seiftotal30-source/BLOC-BOT/thesis/title_main.tex

% Thesis title, read by the title page (titlepage/titlepage.tex) and by main.tex.
\newcommand{\thesistitle}{Universal Modular Platform}
\newcommand{\thesissubtitle}{BLOC-BOT: ESP32-Based Design with a Wireless Handheld Controller}
