seiftotal30-source/BLOC-BOT/thesis/figures.tex

% Figure library for the thesis. \input{figures} where needed, or copy single blocks.
% Images live in ../CAD/out/ (see \graphicspath in main.tex), so re-rendering them in
% Fusion updates the thesis without copying files.
% Every figure is also registered in tracking/log.md with how it was produced.
% Naming: label fig:<topic>-<view>.

% F01 -- made with Fusion viewport.saveAsImageFile, iso top-right view, plate hidden
\begin{figure}[htbp]
  \centering
  
  \caption{Right and left motor brackets with the right-hand TT motor and wheel
           (isometric view).}
  \label{fig:bracket-iso}
\end{figure}

% F02 -- top view, plate hidden
\begin{figure}[htbp]
  \centering
  
  \caption{Top view of both brackets showing the three mounting slots.}
  \label{fig:bracket-top}
\end{figure}

% F03 -- Fusion "front" view (looks along +Y), plate hidden
\begin{figure}[htbp]
  \centering
  
  \caption{Front view: flange on the gearbox top, motor tab and sensor column.}
  \label{fig:bracket-front}
\end{figure}

% F04 -- left view, plate, wheel and left bracket hidden
\begin{figure}[htbp]
  \centering
  
  \caption{Side view: the encoder disc's bottom rim sits in the LM393 fork; the board is
           screwed to the column.}
  \label{fig:sensor-side}
\end{figure}

% F05 -- iso bottom-right view, plate shown
\begin{figure}[htbp]
  \centering
  
  \caption{Brackets mounted under the waffle plate, seen from below.}
  \label{fig:plate-below}
\end{figure}

% F06 -- iso top-right view, plate shown
\begin{figure}[htbp]
  \centering
  
  \caption{Brackets and wheel relative to the waffle plate, seen from above.}
  \label{fig:plate-top}
\end{figure}

% F07-F10 -- bracket alone (all references hidden), four isometric views
\begin{figure}[htbp]
  \centering
  \hfill
  \\[1ex]
  \hfill
  
  \caption{Right bracket on its own: top and underside, from the front and the rear.}
  \label{fig:bracket-angles}
\end{figure}

% F11-F12 -- bracket with motor, disc and LM393 (no wheel, no plate), from below
\begin{figure}[htbp]
  \centering
  \hfill
  
  \caption{Assembly from below: motor tab and nut traps, encoder disc and LM393 sensor.}
  \label{fig:assembly-below}
\end{figure}

% F13 -- controller, closed, iso top-right
\begin{figure}[htbp]
  \centering
  
  \caption{Handheld controller, closed: joystick left, display window top centre, two buttons
           below the stick, directional cross of four buttons on the right.}
  \label{fig:controller-iso}
\end{figure}

% F14 -- controller, top view
\begin{figure}[htbp]
  \centering
  
  \caption{Controller from above (178 x 87~mm): window over the OLED active area, two
           buttons below the stick, directional cross right, joystick opening sized from the cap's sweep sphere.}
  \label{fig:controller-top}
\end{figure}

% F15 -- exploded view (custom graphics copies, design not moved)
\begin{figure}[htbp]
  \centering
  
  \caption{Exploded view: bottom shell, internal parts, top shell and printed caps.}
  \label{fig:controller-exploded}
\end{figure}

% F16 -- section through the directional cross and the display
\begin{figure}[htbp]
  \centering
  
  \caption{Section through the directional cross and the display: caps trapped by their flanges above the
           switch plungers, switches on pillars, OLED glass under the 1~mm bezel lip.}
  \label{fig:controller-section}
\end{figure}

% F18-F19 -- rear caster supports under the waffle plate (cst_shots.py)
\begin{figure}[htbp]
  \centering
  \hfill
  
  \caption{Rear caster under the plate, from below and behind. Left: version A, a 4~mm plate
           (the motor bracket flange's thickness) with four printed pillars the caster screws to.
           Right: version B, the same plate with a 9.75~mm boss, caster screwed straight on.}
  \label{fig:caster-iso}
\end{figure}

% F20-F21 -- side views, plate underside to floor
\begin{figure}[htbp]
  \centering
  \hfill
  
  \caption{Side views. Plate underside to floor is 47.75~mm (bracket + TT motor + \O 65 wheel):
           A and B both 4 + 9.75 + 34 (caster) = 47.75~mm.}
  \label{fig:caster-side}
\end{figure}

% F22-F23 -- the printed supports alone, underside up
\begin{figure}[htbp]
  \centering
  \hfill
  
  \caption{The two supports, underside up: nut traps for the four M3 plate screws, countersunk
           M3 holes for the caster through the pillars (A) or the boss (B).}
  \label{fig:caster-parts}
\end{figure}
