seiftotal30-source/BLOC-BOT/thesis/chapters/front_abbreviations.tex

% List of abbreviations: every acronym used in Chapters 1-3 (collected by grep over the
% chapters). Add new ones here when a chapter introduces them.
\chapter*{List of Abbreviations}
\addcontentsline{toc}{chapter}{List of Abbreviations}

\renewcommand{\arraystretch}{1.1}
\begin{longtable}{L{3.2cm}L{\dimexpr\textwidth-4.4cm\relax}}
\toprule
\textbf{Abbreviation} & \textbf{Meaning} \\
\midrule
\endhead
ADC    & Analog-to-Digital Converter \\
ARC    & Algerian Robot Cup \\
BMS    & Battery Management System \\
CAD    & Computer-Aided Design \\
DA     & Algerian dinar (\emph{dinar algérien}) \\
DC     & Direct Current \\
EPFL   & École Polytechnique Fédérale de Lausanne \\
FDM    & Fused Deposition Modelling \\
FR     & Functional Requirement \\
GPIO   & General-Purpose Input/Output \\
HTSSOP & Heat-sink Thin Shrink Small Outline Package \\
I\textsuperscript{2}C & Inter-Integrated Circuit \\
IMU    & Inertial Measurement Unit \\
IP     & Internet Protocol \\
LE     & (Bluetooth) Low Energy \\
LED    & Light-Emitting Diode \\
LSB    & Least Significant Bit \\
MAC    & Medium Access Control \\
MEMS   & Micro-Electro-Mechanical System \\
MOSFET & Metal-Oxide-Semiconductor Field-Effect Transistor \\
NC     & Not Connected \\
OLED   & Organic Light-Emitting Diode \\
PETG   & Polyethylene Terephthalate Glycol \\
PSRAM  & Pseudo-Static Random-Access Memory \\
PWM    & Pulse-Width Modulation \\
RAM    & Random-Access Memory \\
RMS    & Root Mean Square \\
ROM    & Read-Only Memory \\
SAR    & Successive-Approximation Register \\
SCL    & Serial Clock (I\textsuperscript{2}C) \\
SDA    & Serial Data (I\textsuperscript{2}C) \\
SoC    & System on a Chip \\
SPI    & Serial Peripheral Interface \\
SRAM   & Static Random-Access Memory \\
TSSOP  & Thin Shrink Small Outline Package \\
TTL    & Transistor-Transistor Logic \\
USB    & Universal Serial Bus \\
\bottomrule
\end{longtable}
