seiftotal30-source/BLOC-BOT/thesis/chapters/front_dedication.tex

% Two dedications, one per student, each on its own page. These are personal texts:
% each author writes their own. The red markers must be replaced before printing.
\chapter*{Dedication}
\addcontentsline{toc}{chapter}{Dedication}

\vspace*{2cm}
\begin{center}
\begin{minipage}{0.78\textwidth}
\itshape\centering
\todo{dedication of CHETIOUI Wassim, in their own words}

\vspace{1.2cm}
\normalfont\normalsize
\hfill CHETIOUI Wassim
\end{minipage}
\end{center}

\clearpage

\vspace*{2cm}
\begin{center}
\begin{minipage}{0.78\textwidth}
\itshape\centering
\todo{dedication of CHARAD Seif Ali, in their own words}

\vspace{1.2cm}
\normalfont\normalsize
\hfill CHARAD Seif Ali
\end{minipage}
\end{center}
