seiftotal30-source/BLOC-BOT/thesis/chapters/cover.tex

% Cover page (English). Standard Algerian Master's layout: state and ministry headers,
% university, faculty, department, degree, speciality, title, authors, supervisor, jury.
% The jury is known only shortly before the defence; fill in the table then.
\begin{titlepage}
  \centering
  \small
  {\bfseries People's Democratic Republic of Algeria\\
  Ministry of Higher Education and Scientific Research\par}
  \vspace{4mm}
  {\large\bfseries Ferhat Abbas University S\'{e}tif~1\par}
  \vspace{1mm}
  Faculty of Science and Technology\\
  Department of Electronics\par
  \vspace{14mm}

  {\large\bfseries MASTER'S THESIS\par}
  \vspace{2mm}
  Field: Science and Technology\\
  Speciality: Embedded Systems\par
  \vspace{12mm}

  \rule{\textwidth}{0.8pt}\par
  \vspace{4mm}
  {\LARGE\bfseries BLOC-BOT\par}
  \vspace{3mm}
  {\Large Design and realisation of a modular mobile robot platform\\
  controlled wirelessly by an ESP32-based handheld controller\par}
  \vspace{4mm}
  \rule{\textwidth}{0.8pt}\par
  \vspace{12mm}

  \begin{minipage}[t]{0.47\textwidth}
    \raggedright
    \textbf{Presented by:}\\[1mm]
    Wassim CHETIOUI\\
    Seif Ali CHARAD
  \end{minipage}\hfill
  \begin{minipage}[t]{0.47\textwidth}
    \raggedleft
    \textbf{Supervised by:}\\[1mm]
    Dr.\ Miloud HAMANI
  \end{minipage}\par
  \vspace{14mm}

  \textbf{Defended on \todo{date} before the jury composed of:}\par
  \vspace{3mm}
  \begin{tabular}{@{}l l l l@{}}
    \todo{name} & \todo{grade} & Ferhat Abbas University S\'{e}tif~1 & President \\
    \todo{name} & \todo{grade} & Ferhat Abbas University S\'{e}tif~1 & Examiner \\
    Miloud HAMANI & \todo{grade} & Ferhat Abbas University S\'{e}tif~1 & Supervisor \\
  \end{tabular}\par
  \vfill
  Academic year \todo{2025/2026?}\par
\end{titlepage}
