seiftotal30-source/BLOC-BOT/thesis/tracking/log.md

# Thesis tracking log

One running record of every figure, graph, reference and search made for the thesis.
Add a row whenever one is created or used. IDs never change once given, even if an item is
dropped (mark it `dropped`).

## Figures

Images are in `CAD/out/`. LaTeX blocks are in `thesis/figures.tex`.

| ID | File | LaTeX label | How it was made | Date | Status |
|---|---|---|---|---|---|
| F01 | shot_iso.png | fig:bracket-iso | Fusion, iso top-right, plate hidden, 1600x1100 | 2026-10-05 | ready |
| F02 | shot_top.png | fig:bracket-top | Fusion, top view, plate hidden | 2026-10-05 | ready |
| F03 | shot_front.png | fig:bracket-front | Fusion "front" view (looks along +Y), plate hidden | 2026-10-05 | ready |
| F04 | shot_side.png | fig:sensor-side | Fusion left view; plate, wheel, left bracket hidden | 2026-10-05 | ready |
| F05 | shot_with_plate_below.png | fig:plate-below | Fusion iso bottom-right, plate shown | 2026-10-05 | ready |
| F06 | shot_with_plate_top.png | fig:plate-top | Fusion iso top-right, plate shown | 2026-10-05 | ready |
| F07 | angle_bracket_iso_front.png | fig:bracket-angles (a) | Fusion iso top-right, bracket only | 2026-10-05 | ready |
| F08 | angle_bracket_iso_rear.png | fig:bracket-angles (b) | Fusion iso top-left, bracket only | 2026-10-05 | ready |
| F09 | angle_bracket_under_front.png | fig:bracket-angles (c) | Fusion iso bottom-right, bracket only | 2026-10-05 | ready |
| F10 | angle_bracket_under_rear.png | fig:bracket-angles (d) | Fusion iso bottom-left, bracket only | 2026-10-05 | ready |
| F11 | angle_assembly_under_front.png | fig:assembly-below (a) | Fusion iso bottom-right; bracket, motor, disc, LM393 | 2026-10-05 | ready |
| F12 | angle_assembly_under_rear.png | fig:assembly-below (b) | Fusion iso bottom-left; bracket, motor, disc, LM393 | 2026-10-05 | ready |
| F13 | controller_iso.png | fig:controller-iso | Fusion iso top-right, closed case with references, 1800x1100 (CAD/scripts/ctl_shots.py) | 2026-10-05 | ready |
| F14 | controller_top.png | fig:controller-top | Fusion top view, closed case (ctl_shots.py) | 2026-10-05 | ready |
| F15 | controller_exploded.png | fig:controller-exploded | Custom-graphics copies lifted 0/35/75/100 mm (bottom/parts/top/caps), camera (30,-38,26) (ctl_shots.py) | 2026-10-05 | ready |
| F16 | controller_section.png | fig:controller-section | Custom-graphics copies cut by the vertical plane through the directional cross (57.5,-9.5) and display (0,19.7) centres (ctl_shots.py); F13-F16 re-shot 2026-10-14 (cross of 4 + 2 buttons, rim chamfer) | 2026-10-05 | ready |
| F17 | electronics/robot_circuit.svg | (not added yet) | Hand-written SVG block diagram of the proposed ESP32-S3 robot circuit; convert to PDF before including. 2026-10-10: two DRV8871 boxes replaced by one DRV8833, GPIO 13/14 added | 2026-10-06 | draft |
| F18 | caster/caster_A_iso.png | fig:caster-iso (left) | Fusion "Caster Mount", ortho, eye (-120,-200,-120) target (0,-65,-20); support A, pillars, caster, plate (CAD/scripts/cst_shots.py) | 2026-10-14 | ready |
| F19 | caster/caster_B_iso.png | fig:caster-iso (right) | As F18, support B and caster (cst_shots.py) | 2026-10-14 | ready |
| F20 | caster/caster_A_side.png | fig:caster-side (left) | Fusion ortho from -X, eye (-300,-62,-24); support A, pillars, caster (cst_shots.py) | 2026-10-14 | ready |
| F21 | caster/caster_B_side.png | fig:caster-side (right) | As F20, support B and caster (cst_shots.py) | 2026-10-14 | ready |
| F22 | caster/caster_A_part.png | fig:caster-parts (left) | Fusion ortho from below, eye (-90,-150,-100); support A alone (cst_shots.py) | 2026-10-14 | ready |
| F23 | caster/caster_B_part.png | fig:caster-parts (right) | As F22, support B alone (cst_shots.py) | 2026-10-14 | ready |
| F25 | (circuitikz, inline in chapters/ch2_design.tex) | fig:hbridge | Generic H-bridge principle, switches Q1–Q4; logic mapping from DRV8833 datasheet Table 1 | 2026-10-21 | ready |
| F26 | (TikZ, inline in chapters/ch3_realisation.tex) | fig:robot-loop | Robot main-loop flowchart, from src/main.cpp loop() and setup() (2026-10-24) | 2026-10-25 | ready |
| F27 | (TikZ, inline in chapters/ch3_realisation.tex) | fig:screens | Controller screen map, from Bloc-Con/src/main.cpp menu[] and handleButtons() | 2026-10-25 | ready |
| F28 | ../circuits/kicad/robot/robot.pdf | fig:sch-robot | KiCad 10 schematic generated by circuits/kicad/gen_schematics.pl, exported with kicad-cli (-e -n), cropped with pdfcrop. ERC: no connection errors | 2026-10-25 | ready (MPU6050 supply to confirm) |
| F29 | ../circuits/kicad/controller/controller.pdf | fig:sch-con | Same method as F28 | 2026-10-25 | ready |
| F24 | (TikZ, inline in chapters/ch2_design.tex) | fig:architecture | System block diagram drawn in TikZ. Parts and power chains from circuits/drv8833_motor_circuit.png and bloccon_controller_circuit.png (user-corrected: 0.96" OLED fitted); 50 ms / 100 ms from Bloc-Con/src/main.cpp and src/main.cpp | 2026-10-21 | ready |

## Graphs

Plots made from data (with the data file and the script that made them).

| ID | File | LaTeX label | Data source | Script | Date | Status |
|---|---|---|---|---|---|---|
| G01 | results/print_cost/print_cost.csv (table, not a plot) | (not added yet) | Latest Cura G-code in CAD/out (MotorBracket, HBlocL, VBloc, HBloc _Ender3Pro_pro; CasterSupportB_Ender5Plus) + old waffle plate from the user. Cura headers are wrong (0 m, 6666 s), so filament is summed from the E moves; checked against Cura's VBloc header (5.34 m) and Creality's caster file (7.48 m) | results/print_cost/make_table.py (uses gcode_filament.py) | 2026-10-20 | ready |

## References

Entries are in `thesis/references.bib`.

| Key | What it is | Used for | Verified? |
|---|---|---|---|
| ttmotor_model | TT Motor Dual Shaft CAD model (Oj Simpson) | All motor dimensions | URL missing |
| lm393_sensor_model | Speed sensor MH-Sensor-Series CAD model (P. Pennel) | Board, fork and disc dimensions | URL missing |
| fusion360 | Autodesk Fusion | CAD modelling, checks, renders | yes |
| fusion_api | Fusion API Reference Manual | Scripted modelling and checks | URL missing |
| git | Git 2.55.0 | Version control of the project | yes |
| grabcad_rc_model | GrabCAD Remote Controller (Slyman Rambo) | Controller shell shape (chamfered outline) | URL missing |
| esp32_devkit_model | ESP32 DevKit V1 STEP model | ESP32 board, holes, micro-USB | author, URL missing |
| oled_242_model | 2.42" 12864 OLED STEP model | Display window, lip, bosses | author, URL missing |
| ky023_model | KY-023 joystick STEP model | Opening, travel, posts | author, URL missing |
| b3f_switch_model | OMRON B3F-4050 STEP model | Switch heights, pegs, caps | author, URL missing |
| tp4056_model | TP4056 Type-C STEP model | Charger pocket, USB-C opening | author, URL missing |
| mt3608_model | MT3608 STEP model | Boost board pocket | author, URL missing |
| drv8833_datasheet | TI DRV8833 datasheet (SLVSAR1E) | Motor driver limits, wiring, control tables | yes |
| caster_wheel_model | GrabCAD Nylon Caster Wheel (AJ, 2018) | Caster plate, hole pattern, height, wheel size | yes (page text; files not downloaded) |
| drv8871_datasheet | TI DRV8871 datasheet SLVSCY9B (rev. July 2016), copy in references/datasheets/ | Ch. 2.4.2: VM 6.5–45 V, UVLO falling 6.1 typ / 6.4 max, rising 6.3 / 6.5 V (likely reason the motors did not run on 2S; unconfirmed) | yes |
| adafruit_tt_motor | Adafruit product 3777 "TT Motor" listing (online) | Ch. 2.4.3: 1:48, 3–6 V, no-load/stall current, rpm, torque. Reference for the type only: our motors are unmarked, Algerian shops (MHTronic, Esp32Lab searched 2026-10-21) list no specs | yes |
| tp4056_datasheet | NanJing Top Power TP4056 datasheet (SparkFun-hosted, no rev.), copy in references/datasheets/ | Ch. 2.5.3: CC/CV 4.2 V ±1.5 %, ≤1 A via R_PROG, 2.9 V trickle | yes |
| mt3608_datasheet | Aerosemi MT3608 datasheet (Olimex-hosted, no rev.), copy in references/datasheets/ | Ch. 2.5.3: 2–24 V in, ≤28 V out, 1.2 MHz, V_FB 0.6 V, V_OUT formula | yes |
| ssd1306_datasheet | Solomon Systech SSD1306 Rev 1.1 (Apr 2008), Adafruit-hosted copy in references/datasheets/ | Ch. 2.5.2: 128×64, I2C 0x3C/0x3D via SA0, VDD 1.65–3.3 V | yes |
| esp32lab_tp4056 | Esp32Lab "Chargeur LiPo USB-C TP4056" product page (shop listing) | Ch. 2.5.3: listing of a module identical in layout to ours (ours not bought there, no marking): 1000 mA, 4.2 V ±1 %, 2.5 V over-discharge, 3 A overcurrent, B±/OUT± | yes (shop listing) |
| espnow_idf | ESP-IDF v6.1 ESP-NOW API page (online) | Ch. 2.6: definition, 250 B (v1) / 1470 B (v2), 20 peers, broadcast not encryptable, MAC-level send status, CCMP | yes |
| espidf_adc | ESP-IDF v6.1 ADC oneshot driver page (online) | Ch. 2.5.2: "ADC2 is also used by Wi-Fi" | yes |
| mpu6000_ps | InvenSense MPU-6000/6050 Product Specification rev. 3.1 (2011), SparkFun-hosted copy in references/datasheets/ | Ch. 2.4.6: 6-axis, 2.375–3.46 V, I2C 400 kHz, 0x68, 131 LSB/(°/s), 16384 LSB/g | yes |
| mpu6000_rm | InvenSense MPU-6000/6050 Register Map rev. 4.0 (2012), copy in references/datasheets/ | Ch. 2.4.6: registers 0x1B, 0x1C, 0x3B, 0x43, 0x6B used by main.cpp | yes |
| mini360_c101 | Components101 Mini360 module page (2022-09-15) | Ch. 2.4.6: MP2307DN, 4.75–23 V in, 1–17 V out, 1.8 A cont. / 3 A, 340 kHz. MPS datasheet not downloadable here | yes (secondary source) |
| hcsr04_datasheet | ElecFreaks HC-SR04 datasheet (SparkFun-hosted PDF, no revision), copy in references/datasheets/ | Ch. 2.4.5: 5 V, 15 mA, 2 cm–4 m, 15°, 10 µs trigger, 8×40 kHz, d = t·340/2, cycle > 60 ms | yes |
| lm393_datasheet | TI LM393 family datasheet SLCS005AH (rev. April 2025), copy in references/datasheets/ | Ch. 2.4.4: comparator, open-collector output needing a pull-up, 2–30 V supply | yes |
| esp32_datasheet | Espressif ESP32 Series Datasheet v5.3, copy in references/datasheets/ (WROOM-32 v3.8 also downloaded, not cited: controller module is unmarked) | Ch. 2.5.1 (planned): controller MCU specs, GPIO34/35 input-only ADC1, GPIO12/MTDI strapping | yes |
| esp32s3_datasheet | Espressif ESP32-S3 Series Datasheet v2.2 (2026-03-05), copy in references/datasheets/ | Ch. 2.4.1: CPU, SRAM/ROM, radio, ADC (ADC2 vs Wi-Fi), LED PWM, strapping pins | yes |
| esp32s3_wroom1_datasheet | Espressif ESP32-S3-WROOM-1/1U Datasheet v1.8 (2026-03-02), copy in references/datasheets/ | Ch. 2.4.1: N16R8 memory, 36 GPIOs, 3.0–3.6 V, IO35–37 taken by PSRAM | yes |
| esp32s3_devkitc1_guide | Espressif ESP32-S3-DevKitC-1 v1.1 user guide (online, commit 4ffc5bd) | Ch. 2.4.1: 5 V pin, 5 V→3.3 V LDO, GPIO35–37 note. N16R8 not in its ordering table, so the actual board may be a compatible one | yes |

## Searches and lookups

Every search or data lookup that fed a design decision, with what it found.

| # | Date | Where | Query / action | Result | Used for |
|---|---|---|---|---|---|
| S01 | 2026-10-05 | Fusion cloud (Bloc-Bot) | Document search "waffle" | Found "waffle plate" (210 x 210 x 10 mm) | Plate geometry source |
| S02 | 2026-10-05 | Waffle plate model | All vertical hole faces | 108 x Ø3.2, 192 x Ø4.5, 44 x Ø6.0 through-holes, with centres | Slot placement |
| S03 | 2026-10-05 | Waffle plate model | Outline and hex tabs | Side edge X = 90; front-right corner cut-out r 27.06 (others r 29.21); pillar hex tabs circumradius 10 at (±95, ±13.66), (±13.66, ±95) | Placement rules |
| S04 | 2026-10-05 | TT motor model | Faces, holes, bosses | Gearbox 22.5 x 18.8; holes 20.6 behind shaft at ±8.75; front end +11.2; strap to −28.15; flat face = inner side | Tab, holes, motor orientation |
| S05 | 2026-10-05 | LM393 sensor model | Board, fork, hole | PCB 31.25 x 14.25 x 1.6; fork gap 5.0; slot floor 3.65 above PCB underside; hole Ø2.7 at 21.06 from fork centre | Sensor layout, column |
| S06 | 2026-10-05 | Encoder disc model | Faces | Ø24, 1.4 thick, 16 windows r 6.61–11.5, hub Ø7.2 x 4 | Disc position, flange relief |
| S07 | 2026-10-05 | Fusion API docs | Member search `readonly\|editable` | PersonalUseLimits can be read but not changed by scripts | Document-limit troubleshooting |
| S08 | 2026-10-05 | Fusion licensing | Licence query | Personal Use: 10 editable documents | Document-limit troubleshooting |
| S09 | 2026-10-05 | OLED model | Bodies and faces | PCB 72 x 42.8 x 1.2; holes Ø3.0 on 68 x 38.8; glass 62 x 39.8 x 3.7; active area (grey face) 56.6 x 29.5, 2.65 off PCB centre; header pins 8.54 behind the PCB | Window, lip, bosses |
| S10 | 2026-10-05 | KY-023 model | Faces; cap rotated about the gimbal pivot | Pivot at the pin axes; cap skirt torus = sphere r 13.65 about the pivot; cap meets the module case at 30 deg -> 29 deg travel; holes Ø3.0 at (-12.5/14, -11.25/9.25) | Opening Ø28.5, posts |
| S11 | 2026-10-05 | B3F-4050 model | Bodies and horizontal faces | Seating plane z 0; plunger top 7.35; pegs Ø1.6 x 1.35 at y ±4.5; model includes a 13 x 13 keycap (ignored) | Pillars, cap heights |
| S12 | 2026-10-05 | ESP32 model | Bodies, PCB holes | PCB 28.3 x 51.2 x 1.6; holes Ø2.9 at 23.5 x 46.6; pins 8.2 below; micro-USB 7.98 x 2.94 protruding 0.57 | Standoffs, side USB opening |
| S13 | 2026-10-05 | TP4056 / MT3608 models | Bodies, PCB holes | TP4056 28.3 x 17.4 x 1.5, USB-C 8.42 x 2.79, no mounting holes; MT3608 37.2 x 17.23 x 1.52, 6.45 tall, no mounting holes | Clip pockets, USB-C opening |
| S14 | 2026-10-05 | GrabCAD RC Transmitter | Import and outline | 200 x 170 x 36 box with chamfered corners, two halves, no grips | Shell shape |
| S15 | 2026-10-10 | ti.com, DRV8833 product page and datasheet SLVSAR1E (Rev. E, Jul 2015) | Supply range, current, protection, logic levels, pin functions, control tables | VM 2.7–10.8 V (11.8 V abs. max); 1.5 A RMS / 2 A peak per bridge (HTSSOP/WQFN), 0.5 A RMS (TSSOP); OCP 2–3.3 A, retry 1.35 ms; UVLO below 2.5 V; VIH 2 V (nSLEEP 2.5 V); nSLEEP high to enable, 500 kΩ pull-down; xISEN to GND without current control | Switch from DRV8871 to DRV8833: wiring, pin map, risks |
| S16 | 2026-10-14 | grabcad.com/library/nylon-caster-wheel-1 (built-in browser; plain fetch got 403) | Caster sizes | Fixing plate 38 x 32, holes Ø4 on 30 x 23, overall height 34, wheel Ø25.5; files need a login | Both caster supports |
| S17 | 2026-10-14 | CAD/3mf/from_professional/Bracket.3mf | Vertex heights of the three parts | Flange 4 mm thick (12 mm only at the tab socket); flange X 33..90, Y 47.45..101.06 | Support plate thickness (flange_t) |
| S18 | 2026-10-14 | Waffle plate (copied into "Caster Mount") | Holes near the rear centre line; underside solid fraction | Plate turned 90 deg as on the real robot; Ø4.5 holes at (±27, -71) and (±7, -34) used; underside flat with holes; 77 % of the support top on solid plate, bracket flange area 38 % | Fixing screw positions, contact check |
| S19 | 2026-10-20 | Latest G-code files in CAD/out (motor brackets taken from origin/main a36c08b) + user | Filament length, print time, cost | 5 G-code parts 107.2 g at 1.27 g/cm3 (assumed typical PETG density), 5 h 08 (Cura TIME_ELAPSED); old waffle plate ~200 g, 1 d 21 h (user, no G-code). Total 307 g, 1229-1290 DA at 4000 DA/kg + 0-5 % waste (user) | Print cost table (T5) |

### Chapter 1 sources (added 2026-10-26)

| Key | What it is | Used for | Verified? |
|---|---|---|---|
| siegwart2004 | Siegwart & Nourbakhsh, Introduction to Autonomous Mobile Robots, MIT Press 2004 (PDF copy + extracted text in references/datasheets/) | Ch. 1.2: wheels most popular, legged vs wheeled, differential drive spins on the spot, equal velocity profiles needed to go straight | yes (quotes checked in the text) |
| mondada2009epuck | e-puck paper (9th Conf. Autonomous Robot Systems and Competitions 2009) + EPFL DISAL page | Ch. 1.3: education robot, open hardware, extension turrets | page + abstract (full text not read) |
| riedo2013thymio | Thymio II paper (IEEE ARSO 2013) + EPFL Thymio page | Ch. 1.3: open-source, all ages, two motors, programming levels | page + abstract (full text not read) |
| yim2007modular | Yim et al., Modular self-reconfigurable robot systems, IEEE RAM 2007 | Ch. 1.4: definition of self-reconfigurable modular robots | abstract (full text not read) |
| mhtronic_kit | MHTronic 2-wheel chassis kit page | Ch. 1.3: local kit contents and price (2950 DA) | yes (page) |
| arduino_uno, atmega328p_datasheet | Arduino UNO R3 docs + Atmel ATmega328P datasheet 7810D | Ch. 1.5: 8-bit, 16 MHz, 32 KB flash, 2 KB SRAM, 10-bit ADC, no radio | yes |
| nrf24l01p_datasheet | Nordic nRF24L01+ product spec rev 1.0 | Ch. 1.6: 2.4 GHz, 250 k / 1 M / 2 Mbps | yes |
