seiftotal30-source/BLOC-BOT/thesis/main.pdf

ةيبعشلاةيطارقميدلاةيرئازجلاةيروهمجلا

## People’s Democratic Republic of Algeria

يملعلاثحبلاويلاعلاميلعتلاةرازو

## Ministry of Higher Education and Scientific Research

## Setif 1 University – Ferhat Abbas Faculty of Technology Department of Electronics Field of Electronics

سابعتاحرف1- فيطسةعماج ايجولونكتلاةيلك كينورتكلإلامسق

كينورتكلإلاةبعش

## | :عجرملا | :Ref

# Master’s Thesis

# Presented to the

## Department: Electronics Domain: Science and Technology Field: Electronics Speciality: Embedded Systems Electronics

# Carried out by:

## Mr. CHETIOUI Wassim

## and

## Mr. CHARAD Seif Ali

# Topic

# BLOC-BOT: a Modular Mobile Robot Platform

# ESP32-Based Design with a Wireless Handheld Controller

## Defended on: |

## Before the examination committee composed of:

Members: | | Univ. Setif 1 President
Dr. HAMANI Miloud | MCB Univ. Setif 1 Supervisor
| | Univ. Setif 1 Examiner

## Academic Year: 2025–2026

# Contents

1 Generalities | 2
2 Study and design | 6

i

3 Realisation and tests | 23

# Chapter 1

# Generalities

## 1.1 Introduction

This chapter gives the background on which the rest of the thesis builds. It first describes mobile robots and the way they move, then looks at robots designed for teaching and at the idea of a modular robot, and places BLOC-BOT among them. The last two sections introduce the electronic building blocks of the project: microcontrollers, and the wireless links that let two of them communicate.

## 1.2 Mobile robots

### 1.2.1 Definition

A mobile robot is a machine that can move through its environment under its own control, as opposed to an industrial arm fixed to the floor of a factory. It carries its own actuators to move, sensors to perceive its surroundings and its own motion, a processing unit that decides what to do, and usually its own energy source. It may be controlled by a human, as BLOC-BOT is when it is driven from its controller, or it may act on its own from what its sensors tell it, as a line-following robot does.

### 1.2.2 Locomotion

A mobile robot can move on legs, on wheels, on tracks, or in more unusual ways. Legged locomotion copes well with soft and uneven ground but needs many degrees of freedom and is mechanically complex. Wheels, by contrast, are simple and very well suited to flat ground, where wheeled locomotion is one to two orders of magnitude more efficient than legged locomotion [1]. For these reasons, Siegwart and Nourbakhsh describe the wheel as “by far the most popular locomotion mechanism in mobile robotics” [1]. The student competitions we took part in are run on flat indoor tracks, where wheels are the natural choice.

### 1.2.3 Differential drive

Among the many possible wheel arrangements [1], the simplest steerable one is the differential drive: two wheels on a common axis, each driven by its own motor, and one or two passive points of contact, such as a caster wheel, that keep the robot level. There is no

Chapter 1. Generalities

steering mechanism. The robot goes straight when both wheels turn at the same speed, turns when one wheel turns faster than the other, and spins on the spot when the wheels turn at the same speed in opposite directions. This ability to turn without moving its centre makes it very manoeuvrable, and Siegwart and Nourbakhsh name the two-wheel differential drive the most popular of these highly manoeuvrable designs [1].
The same property has a cost. Since nothing mechanical keeps the robot on a straight line, both motors “must be driven along exactly the same velocity profile” for it to go straight, which is difficult because of the small differences between wheels and motors [1]. This is why a differential-drive robot benefits from measuring the speed of each wheel, as BLOC-BOT does with its encoders (Section 2.4.4). BLOC-BOT uses this configuration: two driven wheels and a caster at the front.

## 1.3 Educational and competition robots

Robots are widely used to teach electronics, programming and control, because they turn abstract notions into a machine whose behaviour can be seen. Several families of robots serve this purpose.

Robots designed for teaching. Some robots are designed from the start as teaching tools. The e-puck, developed at the EPFL in Switzerland, is a small differential-drive robot made for engineering education at university level, inexpensive enough to be used widely in class, released under an open-hardware licence, and extensible with additional boards stacked on top of it, for example for radio communication [2]. Thymio, also from the EPFL, targets a wider public, from primary school to university: it is open-source in both hardware and software, is driven by two independent motors, and can be used through pre-programmed behaviours, then graphical and text programming [3]. Both are complete, finished robots: they are excellent to learn with, but their mechanics are fixed, and adding a sensor that was not planned by their designers is not their purpose.

Hobby kits. At the other end are the robot-car kits sold in electronics shops. The most common one in Algerian shops, a two-wheel chassis kit, costs 2950 DA and contains a chassis, two 6 V gearmotors with a 1:48 reduction, two wheels, an omnidirectional caster, two encoder discs, a holder for four AA batteries and screws; the microcontroller, the motor driver and every sensor have to be bought separately [4]. Such kits are cheap and are the usual starting point for student teams, but they provide little more than a frame and motors. Every new sensor needs its own way of being fixed and wired, and the result is a different robot every time.

Competition robots. In our experience of competitions such as the Algerian Robot Cup (Section 2.2), teams build their robots from such kits or from scratch, for one event and one task. As explained in Chapter 2, this is precisely the situation BLOC-BOT was created to improve.

## 1.4 Modular robots

The word modular is used in robotics with two rather different meanings, and it is worth separating them to place BLOC-BOT correctly.

Chapter 1. Generalities

In research, modular self-reconfigurable robots are machines made of many identical or similar modules that can rearrange how they are connected, and so change their own shape, to adapt to a new situation, perform a new task or recover from damage [5]. The robot changes its shape by itself. This is an active research field with its own open problems [5].
In a simpler sense, a robot is modular when it is built from parts that follow a common interface, so that they can be added, removed or exchanged by hand without redesigning the rest. The extension boards of the e-puck are an example of this on the electronic side [2].
BLOC-BOT belongs to this second kind. It does not reconfigure itself: its modularity is mechanical and manual. A plate with a fixed pattern of holes, the waffle plate, provides a common interface, and printed holders, the blocs, clamp a sensor or a module to it at any position of the pattern. Changing the robot for a new competition then means moving or adding blocs and their wiring, rather than designing and printing a new chassis. In this sense, BLOC-BOT sits between the hobby kit, which it resembles in cost and in parts, and the educational robot, from which it takes the idea of a documented, open platform that others can build on.

## 1.5 Embedded systems and microcontrollers

An embedded system is a computer built into a device to perform a specific function, often with tight limits on size, cost and power, and directly connected to the physical world through sensors and actuators. A robot’s brain is usually such a system, built around a microcontroller: a single chip that contains a processor, program and data memory, and the peripherals needed to talk to the outside world, such as general-purpose input/output (GPIO) pins, timers that generate PWM signals, analog-to-digital converters (ADCs) and serial interfaces.

Arduino. Much of student robotics starts with the Arduino UNO, a board built around the ATmega328P microcontroller [6]. Its 8-bit processor runs at 16 MHz, with 32 KB of flash memory for the program, 2 KB of SRAM and a 10-bit ADC [7]. The board has no radio [6]: a wireless link needs an extra module.

The ESP32 family. The ESP32 chips from Espressif are microcontrollers with an integrated 2.4 GHz radio. The original ESP32 combines a dual-core 32-bit processor at up to 240 MHz, 520 KB of SRAM, Wi-Fi and Bluetooth 4.2 [8]; the newer ESP32-S3 offers a similar processor with 512 KB of SRAM, Wi-Fi and Bluetooth 5 Low Energy, and more GPIOs [9]. Table 1.1 compares them with the Arduino UNO’s microcontroller. Their main interest for a robot is that the processor and the radio are on the same chip, so the robot and its controller can communicate without any added module, and that they are programmed with the same Arduino tools as an Arduino board.

## 1.6 Wireless links for robots

A robot driven by hand needs a link between its controller and its own microcontroller. Most of the options available to a student project work in the 2.4 GHz band.

Chapter 1. Generalities

Table 1.1: Microcontrollers compared [6], [7], [8], [9].

ATmega328P
(Arduino UNO)
| | ESP32 | ESP32-S3
Processor | 8-bit AVR, 16 MHz | dual-core 32-bit
| | Xtensa LX6, up to
| | 240 MHz | dual-core 32-bit
| | | Xtensa LX7, up to
| | | 240 MHz
SRAM | 2 KB | 520 KB | 512 KB
Radio | none | Wi-Fi 802.11b/g/n,
| | Bluetooth 4.2
| | (Classic and LE) | Wi-Fi 802.11b/g/n,
| | | Bluetooth 5 (LE
| | | only)
ADC | 10-bit | two 12-bit | two 12-bit
Used in BLOC-BOT no | controller | robot
- Wi-Fi (IEEE 802.11b/g/n) is built into ESP32 chips [8]. It is designed to connect devices to a network: one device acts as an access point and the others join it before exchanging data, usually over IP.
- Bluetooth exists in two forms. Bluetooth Classic is available on the original ESP32 only; Bluetooth Low Energy, available on both chips [8], [9], organises data as services and characteristics exchanged over a connection between a central and a peripheral device.
- Separate radio modules, such as the nRF24L01+, are transceivers that a microcontroller without a radio drives over SPI. The nRF24L01+ works in the 2.4 GHz band at 250 kbit/s, 1 or 2 Mbit/s [10]; it is cheap and simple but adds a module and its wiring at each end.
- ESP-NOW is Espressif’s connectionless protocol, which uses the Wi-Fi radio of ESP32 chips to send short frames directly from one device to another, without an access point or a connection set-up, with up to 250 bytes per frame [11].

The choice between them for BLOC-BOT is made in Section 2.6: since both ends are ESP32 chips, ESP-NOW gives a direct link with no extra hardware and no connection to establish.

## 1.7 Conclusion

A small differential-drive robot is one of the simplest and most widely used forms of wheeled mobile robot [1]; its weakness, keeping a straight line, is what wheel encoders help with. Between finished educational robots, whose mechanics are fixed, and hobby kits, which offer little beyond a frame and motors, there is room for a platform that is as cheap as a kit but provides a standard way of mounting and wiring modules. The ESP32 family, with its integrated radio and ESP-NOW, provides the electronic base for such a platform. Chapter 2 specifies and designs it.

# Chapter 2

# Study and design

## 2.1 Introduction

Plan: Half a page. What this chapter does: turn the problem from the general introduction into a specification, show the system architecture, then present every electronic component with its working principle and the reason it was chosen. The modular platform comes last.

## 2.2 Specification

### 2.2.1 Origin of the need

BLOC-BOT grew out of our own experience of student robotics competitions. Our team took part in two consecutive editions of the Algerian Robot Cup (ARC 3 and ARC 4), and in several other competitions, without success. Each ARC edition has two stages. To qualify, a team’s robot must follow a line through a maze, and the fastest robots go through. The main event then calls for a second robot, built for a task that changes from one year to the next. Looking back, we traced most of our difficulties to two causes. The first was time. For every competition we built the robot’s modules from scratch: a new chassis, new sensor mounts, new wiring, and in the case of ARC, two robots instead of one. Each took long enough that we reached the competition underprepared, with too little time left for testing and tuning.
The second was the specification itself. Organisers often announce the rules late or in vague terms. Unsure of what would be asked, we tended to over-prepare and build a robot more complicated than the task required. A more complicated robot has more ways to fail, and some of ours failed during the competition itself.
Both problems point to the same answer: a single robot that is ready in advance and can be reconfigured quickly for each competition, rather than a new robot every time. Most competitions in this category rely on a small, recurring set of sensors (line sensors, distance sensors, wheel encoders). If each of these has a standard way of being mounted and wired, adapting the robot becomes a matter of choosing modules instead of designing them. This is the idea behind BLOC-BOT and its interchangeable mechanical holders, which we call blocs.

Chapter 2. Study and design

### 2.2.2 Target users

The platform is aimed first at students and teams preparing for robotics competitions, who need a working base quickly and want to spend their time on strategy and tuning rather than on rebuilding mechanics. Because the hardware and firmware are open and the platform is designed to be extended, it is also meant for students and researchers who need a small mobile robot as a test bench for their own sensors or algorithms.

### 2.2.3 Functional requirements

Table 2.1 lists what the system must do. The last column gives the state of each requirement at the time of writing, so that the specification can be read against the results in Chapter 3.

Table 2.1: Functional requirements of BLOC-BOT and their state at the time of writing.

ID | Requirement | State

FR1 The robot is driven by hand from a handheld controller over a wireless
| link, with no computer or phone in the loop. | Done

FR2 The controller shows feedback from the robot, starting with the speed
| of its wheels. | Done

FR3 The robot stops on its own when it no longer receives commands from
| the controller. | Done

FR4 Sensors and modules are fixed to the robot through a standard hole
| pattern and printed holders, without redesigning the chassis. | Done
FR5 The controller runs from its own rechargeable battery. | Done
FR6 The robot follows a line using a multi-channel infrared sensor. | In progress
FR7 The robot detects obstacles and parks itself using distance sensors. | Planned

### 2.2.4 Non-functional requirements and constraints

Besides what the system does, four conditions shaped how it was built.

- Local availability of components. Most of the components were chosen because they could be bought in Algeria or were already in our hands, not after a comparison of every alternative on the market. We state this plainly here, and each component section in this chapter says when availability was the deciding reason.
- Low cost. The platform is meant for students, so it is built from common hobbyist modules and 3D-printed parts. Its cost is detailed in Chapter 3.
- Reproducibility. The mechanical parts are printed on an ordinary desktop fused deposition modelling (FDM) printer, and the hardware designs and firmware are to be published as open source.
- Size. The size is set by the waffle plate, a 210 × 210 mm printed plate that carries every other part. In the CAD model of the assembled robot, the wheels stand out on each side, giving an overall width of 242 mm and a length of 214 mm. The robot is 102 mm tall up to its upper plate and 133 mm with the ultrasonic sensor mounted on top (values measured in the Fusion assembly, version 13).

## 2.3 System architecture

BLOC-BOT is made of two separate boards that share no wire: a handheld controller and the robot itself. Each has its own microcontroller and its own battery, and the two talk only over a wireless ESP-NOW link (Section 2.6). Figure 2.1 shows both, with the main signals between their parts.
The controller is the human side of the system. It reads the joystick and the four buttons, shows a menu and the robot’s state on a small OLED screen, and sends drive commands to the robot every 50 ms while its Drive screen is open.
The robot turns each drive command into a speed for each wheel and drives the two TT gearmotors through a DRV8833 dual H-bridge. Two LM393 slotted sensors count the turns of the wheels, and every 100 ms the robot sends the measured wheel speeds back to the controller, which displays them. If drive commands stop arriving, the robot stops its motors on its own, which meets requirement FR3. The robot also carries an HC-SR04 ultrasonic sensor at its front, which measures the distance to obstacles, and an MPU6050 inertial sensor, which measures its tilt and rotation. Both readings are sent to the controller, the distance every 100 ms and the tilt every 50 ms, and shown on their own screens.
The two power chains are independent. The robot runs from a 2S lithium-ion pack that feeds the motor driver directly and the microcontroller through a 5 V step-down converter. The controller runs from a single lithium-ion cell with its own charger and a 5 V step-up converter. Both are detailed in Sections 2.4 and 2.5.

## 2.4 The robot

### 2.4.1 Microcontroller: ESP32-S3 (N16R8)

The robot is controlled by an ESP32-S3, a system on a chip (SoC) from Espressif that combines a microcontroller with a 2.4 GHz radio. Its main features are summarised in Table 2.2. The chip has a dual-core Xtensa LX7 processor running at up to 240 MHz, 512 KB of internal SRAM, and both Wi-Fi (IEEE 802.11b/g/n) and Bluetooth 5 Low Energy [9]. The radio is what makes the wireless link of Section 2.6 possible without any extra module.
The chip is not used on its own but inside a module marked ESP-32-S3-N16R8. This is a third-party module rather than an Espressif one, but it follows the pinout and the naming of Espressif’s ESP32-S3-WROOM-1 [12]: N16R8 stands for 16 MB of flash memory and 8 MB of octal pseudo-static RAM (PSRAM). The module adds these memories, the crystal and a printed antenna, and exposes 36 general-purpose input/output (GPIO) pins. It sits on a development board laid out like Espressif’s ESP32-S3-DevKitC-1, which brings the pins out to two headers, carries two USB-C ports for programming and power, and a regulator that turns a 5 V supply into the 3.3 V the module needs [13]. On the robot, that 5 V comes from the step-down converter described in Section 2.4.7.

Why the ESP32-S3. The robot is meant to grow: every new bloc brings a sensor, and every sensor needs pins. The ESP32-S3 was chosen for its number of usable GPIOs, which leaves room for the line sensor, the ultrasonic sensor and later additions without changing the microcontroller. Its PSRAM is not used by the current firmware.

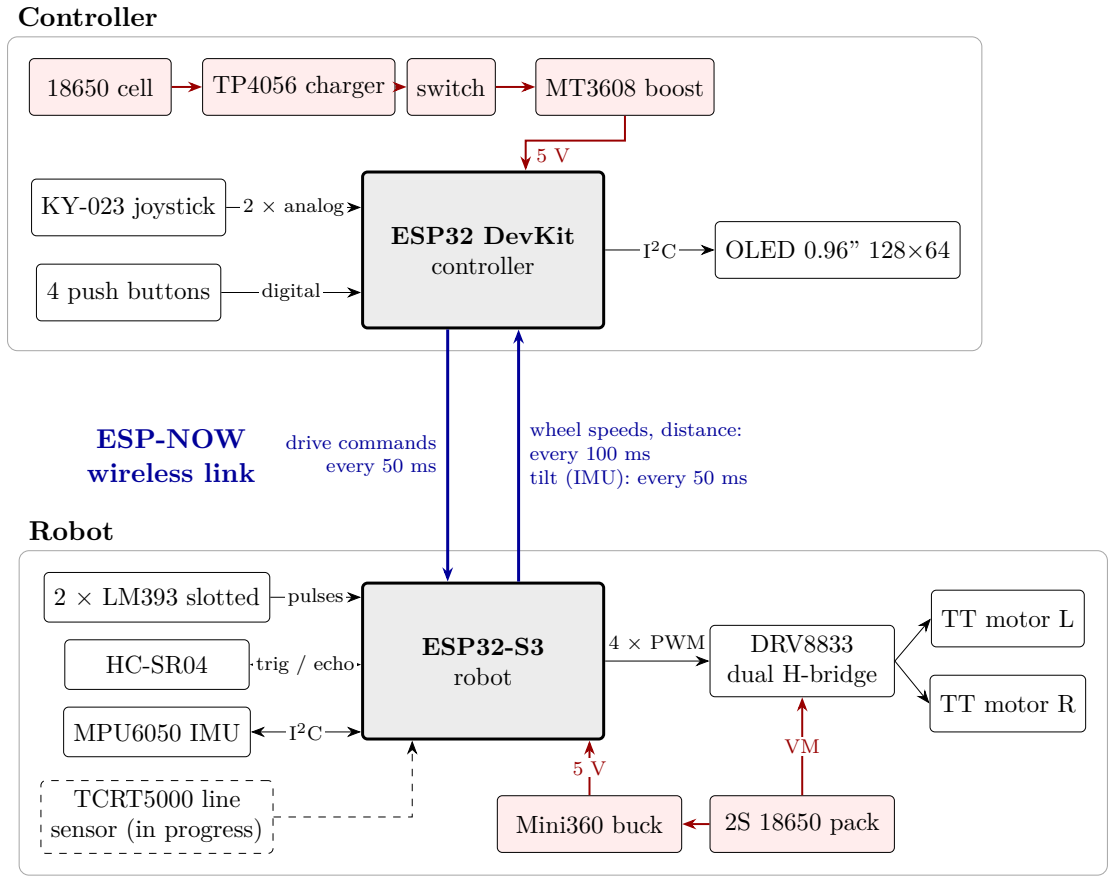
[picture p2: figure]
Controller; Robot; ESP32 DevKit controller; KY-023 joystick; 4 push buttons; OLED 0.96” 128×64; 18650 cell; TP4056 charger; switch; MT3608 boost; 2 × analog; digital; ESP32-S3 robot; 2 × LM393 slotted; MPU6050 IMU; TCRT5000 line sensor (in progress); DRV8833 dual H-bridge; TT motor L; TT motor R; Mini360 buck; 2S 18650 pack; pulses; trig / echo; 4 × PWM; drive commands every 50 ms; wheel speeds, distance: every 100 ms tilt (IMU): every 50 ms; ESP-NOW wireless link

Figure 2.1: System architecture. The controller (top) and the robot (bottom) share no wire; over ESP-NOW the controller sends drive commands and the robot sends back its wheel speeds, the measured distance and its tilt. Red arrows are power, black arrows are signals, and the dashed block is in progress.

Table 2.2: Main features of the ESP32-S3 and of the N16R8 module used on the robot, whose figures follow Espressif’s WROOM-1 N16R8 [9], [12].

Feature | Value
Processor | Dual-core Xtensa 32-bit LX7, up to 240 MHz
Memory | 512 KB SRAM, 384 KB ROM (chip); 16 MB flash, 8 MB PSRAM (mod-
| ule)
Radio | 2.4 GHz Wi-Fi (IEEE 802.11b/g/n), Bluetooth 5 (LE)
GPIOs | 36 on the module, of which GPIO35–37 are taken by the PSRAM
Analog inputs Two 12-bit SAR ADCs, up to 20 channels; ADC2 cannot be used while
| Wi-Fi is active
PWM | LED PWM controller, up to 8 channels
Supply | 3.0–3.6 V (module); 5 V on the development board, regulated to 3.3 V

Pins that cannot be used freely. Not all 36 GPIOs are available. With an octal PSRAM, GPIO35, GPIO36 and GPIO37 carry the memory’s data lines and cannot be used for anything else [9], [12], [13], even though our board still brings them out to its header. GPIO0, GPIO3, GPIO45 and GPIO46 are strapping pins, read by the chip at reset to choose its boot mode, so nothing connected to them should pull them high or low at power-up. GPIO19 and GPIO20 carry the USB interface and GPIO43 and GPIO44 the serial port used for programming [9]. Finally, because the robot uses its radio all the time, analog sensors must be wired to ADC1 pins (GPIO1 to GPIO10): the ADC2 channels cannot be read while Wi-Fi is running [9]. This matters for the five-channel line sensor, which gives analog outputs.
Table 2.3 gives the pins the robot uses at the time of writing. The DRV8833’s sleep input is tied to 3.3 V, so the driver is always enabled and needs no pin.

Table 2.3: GPIO assignment on the robot (firmware file pins_esp32s3.h).

GPIO Connected to | Note

13, 16 DRV8833 AIN1, AIN2 left motor, PWM
18, 17 DRV8833 BIN1, BIN2 right motor, PWM; the pair is swapped in firmware so that both wheels turn forward together
40 | left LM393 sensor | digital pulses, read by interrupt
41 | right LM393 sensor | digital pulses, read by interrupt
11 | HC-SR04 TRIG | 10 µs trigger pulse
12 | HC-SR04 ECHO | through a 1 kΩ/2 kΩ divider (Section 2.4.5), timed by
| | interrupt
8, 9 | I²C SDA, SCL | MPU6050 at 0x68 (Section 2.4.6); reserved for more I²C
| | sensors

### 2.4.2 Motor driver: DRV8833

A microcontroller pin can supply only a few milliamperes, far less than a motor draws, and it cannot reverse the polarity of the voltage across the motor. Both jobs are done by a motor driver built around an H-bridge.

The H-bridge. An H-bridge is made of four switches arranged around the motor, as in Figure 2.2. Closing Q1 and Q4 connects the left terminal of the motor to the supply and the right terminal to ground, and the motor turns one way. Closing Q3 and Q2 reverses the voltage, and the motor turns the other way. Closing both low-side switches Q2 and Q4 shorts the motor terminals together, which brakes it, and opening all four leaves it free to coast. The two switches of the same leg (Q1 and Q2, or Q3 and Q4) must never be closed together, since that would short the supply to ground; the driver chip prevents this internally.

The DRV8833. The robot uses one DRV8833 from Texas Instruments, a chip that contains two complete H-bridges, so a single module drives both wheels. Each bridge is controlled by two logic inputs, IN1 and IN2, following Table 2.4. Its main ratings are listed in Table 2.5.

VM

Q1

Q2

Q3

Q4

OUT1 | M | OUT2

Figure 2.2: Principle of an H-bridge. The DRV8833 contains two of these, built from N-channel MOSFETs, one per motor [14].

Table 2.4: DRV8833 H-bridge logic, per bridge [14], and the switches of Figure 2.2 that it closes.

IN1 IN2 OUT1 OUT2 Switches closed Function

0 | 0 | Z | Z | none | Coast
1 | 0 | H | L | Q1, Q4 | Forward
0 | 1 | L | H | Q3, Q2 | Reverse
1 | 1 | L | L | Q2, Q4 | Brake

Table 2.5: Main ratings of the DRV8833 [14].

Parameter | Value
Motor supply voltage VM | 2.7 to 10.8 V
Output current per bridge (per motor) 1.5 A RMS, 2 A peak (HTSSOP package with
| exposed pad); 0.5 A RMS, 2 A peak (plain
| TSSOP package)
Undervoltage lockout (voltage) | below 2.6 V (VM falling, maximum)
Overcurrent protection (current) | trips between 2 and 3.3 A; the bridge switches
| off and retries after 1.35 ms
Logic input voltage | high from 2 V (nSLEEP from 2.5 V), up to 5.75 V

Speed control by PWM. To vary the speed, the firmware does not hold an input high but switches it on and off rapidly, a technique called pulse-width modulation (PWM). If the input is high for a fraction D of each period, the duty cycle, the motor sees on average roughly D × VM, and because its winding and its inertia smooth the pulses, it turns as if fed that average voltage. The ESP32-S3 generates the PWM signals with its LED PWM controller, at 20 kHz with 8-bit resolution, so the duty cycle is set by a number from 0 to 255 (firmware files pins_esp32s3.h and motor.cpp). For forward motion the firmware applies PWM to IN1 and holds IN2 low; for reverse it does the opposite, and it sets both inputs low to stop. In the DRV8833’s terms this is PWM with fast decay [14]: during the off part of each period the bridge is disabled and the motor coasts. Four PWM channels are therefore needed for the two motors.

Why the DRV8833. One chip drives both motors, which saves space and wiring on the waffle plate. Its supply range, 2.7 to 10.8 V, covers the whole range of a 2S lithium-ion pack, and its logic inputs accept the 3.3 V signals of the ESP32-S3 directly. It was also available locally at low cost.
The module we use is a small red breakout board that carries the chip and a 10 µF capacitor on the motor supply, and follows the pin layout of the common TB6612FNG boards, with the three pins the DRV8833 does not need marked NC. The chip’s marking is not readable on our module, so we cannot tell from it whether it is the HTSSOP version, whose exposed pad allows 1.5 A per bridge, or the plain TSSOP one, limited to 0.5 A [14]. We therefore take the lower figure, 0.5 A continuous per motor, as the safe limit.

The driver we started with. The robot was first wired with two DRV8871 modules, one per motor. With them, the motors never turned at all, while the same motors ran with the DRV8833. We did not measure the battery voltage at the time, so we cannot state the cause with certainty. The DRV8871 datasheet points to a likely one: the chip is rated for a motor supply of 6.5 to 45 V, and its undervoltage lockout switches the bridge off when the supply falls to 6.1 V typically (6.4 V at most), only restarting once it rises back to about 6.3–6.5 V [15]. Our 2S pack is 7.4 V nominal (2 × 3.7 V, from the cell labels), only about 1 V above that threshold, and its voltage falls as it discharges and drops further for a moment each time a motor starts and draws a surge of current. A partly discharged pack could therefore keep the DRV8871 at or below its lockout threshold. The DRV8833, whose lockout is at 2.6 V, has no such problem with 2S.

### 2.4.3 Motors: TT gearmotors

Each wheel is driven by a TT gearmotor, the yellow plastic motor found in most hobby robot kits. It combines a small brushed DC motor with a plastic gearbox that reduces the speed and multiplies the torque, and has an output shaft on both sides of the gearbox. One side carries the wheel; the other is free, which is where the encoder disc of Section 2.4.4 is fitted.
Our motors carry no marking, and the shops we bought them from publish no specifications. We therefore use the figures published by Adafruit for the same common 1:48 TT motor as a reference, given in Table 2.6; they describe the type of motor, not measurements of our own units.
Three consequences follow for the design.

Table 2.6: Reference figures for the 1:48 TT gearmotor (vendor bench measurements [16], not measured on our motors).

| at 3 V | at 6 V
No-load speed (output shaft) | 120 rpm | 250 rpm
No-load current | 150 mA | 160 mA
Stall current | 1.1 A | 1.5 A
Stall torque | 0.4 kg cm 0.8 kg cm

Voltage. The motor is rated for 3 to 6 V [16], while the 2S pack gives 7.4 V nominally and about 8.4 V when fully charged (4.2 V per cell, the usual full-charge voltage of a lithium-ion cell). The firmware therefore never applies full duty: drive commands are scaled so that the duty cycle does not exceed 204/255, or 80 %. On a pack at 7.7 V, the value used in the firmware comment, this gives about 0.8×7.7 ≈ 6.2 V on average. When the pack is fully charged the average rises to about 6.7 V, slightly above the rating; this is a known limit of the current setting.

Current. While running, a TT motor draws well under 0.5 A, the safe limit we set for the driver in Section 2.4.2, but at stall, or for an instant when it starts, it can draw up to about 1.5 A at 6 V (Table 2.6). This is still below the 2 A peak the DRV8833 accepts and below its overcurrent trip point [14]. To soften the start-up surge, the firmware does not jump to the requested speed but ramps the duty cycle by 5 steps (out of 255) every 10 ms (motor.cpp), so going from rest to the 80 % cap takes about 0.4 s.

Speed. The wheels are standard 65 mm TT wheels (the diameter used in the CAD model and in the firmware; test T1 in Chapter 3 checks it in practice). One turn of the wheel moves the robot by π × 65 ≈ 204 mm. At the 250 rpm no-load speed of Table 2.6, this is about 0.85 m/s, or 3.1 km/h. Under the weight of the robot the real speed is lower, so the robot should not go much faster than about 3 km/h. This order of magnitude is a useful check on the speed the encoders report.

Why TT motors. They are geared, so they turn slowly enough to drive a wheel directly, cheap, easy to mount, and the dual shaft leaves room for an encoder. Above all they were the motors available to us.

### 2.4.4 Wheel speed sensors: LM393 slotted encoders

To report the speed of each wheel, the robot uses one slotted speed sensor per motor: a small board with a U-shaped optical fork, an LM393 comparator and a digital output.

Working principle. One arm of the fork holds an infrared LED and the other a phototransistor facing it. A plastic disc with evenly spaced slots is mounted on the free shaft of the TT motor so that its rim passes through the fork. As the wheel turns, the disc alternately lets the infrared light through a slot and blocks it, and the phototransistor’s current rises and falls with it. This signal is slow and noisy at its edges, so the board feeds it to an LM393 comparator, which compares it with a fixed reference and gives a clean two-level output: one pulse per slot. The LM393’s output stage is an open-collector transistor that can only pull the line low, so the board carries a pull-up resistor that defines the high level [17]. We power the sensors from the ESP32-S3’s 3.3 V supply, so that this high level is 3.3 V and the output can go straight to a GPIO.

From pulses to speed. With N slots on the disc and a wheel of diameter D, each pulse corresponds to a distance travelled by the wheel of

∆s =

πD
N
. | (2.1)

Our discs have N = 20 slots, counted on the real parts, and the wheels are 65 mm in diameter, which gives ∆s = π × 65/20 ≈ 10.2 mm per pulse (encoders.cpp). The firmware first assumed 16 slots; this made every reported speed 25 % too high (20/16) until the slots were counted and the constant corrected. Each sensor output is wired to its own GPIO (40 and 41) and triggers an interrupt on every rising edge.

First method: counting pulses. The first version of the firmware counted the pulses of each wheel and, every 100 ms, computed the speed as

v =

n ∆s
∆t
, | (2.2)

where n is the number of pulses counted during the interval ∆t = 100 ms. This turned out to be too coarse. At the robot’s speeds a 100 ms window holds only a few pulses, so one pulse more or less changes the result by 10.2 mm/0.1 s ≈ 102 mm/s, about 0.37 km/h, and the displayed speed jumped between neighbouring values.

Current method: timing the pulses. The firmware now measures the time between pulses instead. Each interrupt also records the period Ti since the previous pulse, taken from the microsecond timer. Every 100 ms, the speed is computed from the average period of the n pulses received in that window:

vmeas =

n ∆s
Pn
i=1 Ti
. | | (2.3)

Since the periods are timed to the microsecond, the result no longer moves in steps of about 100 mm/s. Three details handle the edge cases. If no pulse arrives during a window, the time elapsed since the last pulse gives an upper bound on the speed, so the reading falls smoothly instead of dropping at once. If no pulse arrives for 300 ms, the wheel is considered stopped and the speed is set to zero; this means the slowest speed the robot can report is about 10.2 mm/0.3 s ≈ 34 mm/s. And the first pulse after a stop is not used, because its “period” is just the time the wheel was standing still. Finally, the measured value is smoothed with a first-order filter,

vk = vk−1 + α (vmeas − vk−1), | α = 0.4, | (2.4)

where a larger α follows changes faster but lets more noise through.
The sensor has a single channel, so it sees that the wheel turns but not in which direction. The firmware takes the sign from the command it is applying to that motor, then sends both wheel speeds, in millimetres per second, to the controller every 100 ms.

Protection against false pulses. Slotted sensors of this kind can produce several rapid transitions as a slot edge passes, which would be counted as extra pulses. The interrupt routine therefore ignores any pulse that arrives less than 1 ms after the previous one on the same wheel. At the TT motor’s no-load speed of 250 rpm (Table 2.6), a 20-slot disc gives about 83 pulses per second, one every 12 ms, so this 1 ms window cannot hide a real pulse.

Why these sensors. The board’s fork fits around the rim of a disc on the TT motor’s second shaft, the sensors cost little, and they were what we had. They give speed, not position or direction; a quadrature encoder would give both, at a higher cost.

### 2.4.5 Ultrasonic sensor: HC-SR04

At the front of the robot, an HC-SR04 ultrasonic module measures the distance to the nearest obstacle. It is mounted in a VBloc on the upper plate, facing forward.

Working principle. The HC-SR04 measures distance by time of flight. When its TRIG input receives a pulse of at least 10 µs, its transmitter sends a burst of eight ultrasonic cycles at 40 kHz. The sound travels to the obstacle, is reflected, and comes back to the receiver. The module raises its ECHO output when the burst leaves and lowers it when the echo returns, so the length t of the ECHO pulse is the round-trip time [18]. Since the sound covers the distance twice, the distance d to the obstacle is

d =

v t
2
, | (2.5)

where v is the speed of sound in air. The datasheet takes v = 340 m/s, which gives the rule of thumb d [cm] = t[µs]/58 [18]. The value of v depends on the air temperature, so the measured distance carries a small error when the air is much warmer or colder than assumed. Table 2.7 lists the module’s main figures.

Table 2.7: Main figures of the HC-SR04 module, from the manufacturer’s datasheet [18].

Parameter | Value
Supply | 5 V, 15 mA
Range | 2 cm to 4 m
Measuring angle | 15°
Trigger | pulse of at least 10 µs
Ultrasonic burst | 8 cycles at 40 kHz
Recommended cycle at least 60 ms between measurements

Reading it without blocking. The maximum range sets how long an echo can take: for an obstacle at 4 m the sound travels 8 m, which takes about 8/340 ≈ 24 ms. A simple program would wait for the ECHO pulse to end, but waiting up to 25 ms in the main loop would delay the motor ramp and the failsafe, which run every 10 ms. The robot’s firmware therefore times the echo with an interrupt on GPIO 12: the rising edge stores the start time, the falling edge the pulse width, and the loop never waits. Every

100 ms the firmware converts the last pulse width into a distance with Equation (2.5), using v = 343 m/s (0.343 mm/µs), sends it to the controller in millimetres, and fires the next ping. A pulse longer than 25 ms, about 4.3 m, is reported as “no object”. The 100 ms spacing also respects the datasheet’s advice to leave at least 60 ms between measurements, so that a late echo is not mistaken for the next one.

Level shifting. The HC-SR04 runs from 5 V, and its ECHO output swings to that supply. The ESP32-S3, however, accepts at most its own supply plus 0.3 V on an input, about 3.6 V [9], so ECHO cannot be connected directly. A voltage divider of two resistors brings it down: R1 in series between ECHO and GPIO 12, and R2 from GPIO 12 to ground. The pin then sees

VGPIO = VECHO

R2
R1 + R2
. | (2.6)

We use R1 = 1 kΩ and R2 = 2 kΩ, so a 5 V echo gives 3.33 V, within the input limit and well above the 0.75 × VDD, about 2.5 V, that the ESP32-S3 needs to read a high level [9]. The TRIG input is left without conversion. The datasheet only asks for a “TTL pulse”
[18] and gives no threshold, but in practice the module triggers reliably on the 3.3 V pulse from GPIO 11.

Why the HC-SR04. It is a cheap, widely sold module that is easy to drive with two pins, and it was available. Its limits are stated by the manufacturer: the beam spreads over about 15°, and reliable readings need a target of at least 0.5 m² with a fairly smooth surface [18].

### 2.4.6 Inertial sensor: MPU6050

The robot also carries an MPU6050 inertial measurement unit (IMU), which tells it how it is tilted and how fast it turns. At this stage the data is sent to the controller and displayed; it is the basis for later uses such as holding a straight line or detecting that the robot has tipped over.

What it measures. The MPU6050 from InvenSense combines a three-axis MEMS gyroscope, which measures angular rate, and a three-axis MEMS accelerometer, which measures acceleration including gravity, in one chip [19]. It runs from 2.375 to 3.46 V and is read over I²C at up to 400 kHz, at the address 0x68 when its AD0 pin is low [19]. On the robot it shares an I²C bus, on GPIO 8 (SDA) and GPIO 9 (SCL), that is reserved for later I²C sensors as well, and the module is powered from the board’s 3.3 V, inside the chip’s supply range.

Configuration. At start-up the firmware wakes the chip by clearing the SLEEP bit of its power-management register, and selects the most sensitive ranges: ±2 g for the accelerometer and ±250°/s for the gyroscope [20]. In these ranges one unit of the 16-bit raw value is 1/16 384 g and 1/131°/s [19], which are the scale factors the firmware divides by. It then averages 200 gyroscope readings while the robot stands still and stores them as offsets, because a real gyroscope does not read exactly zero at rest; the robot must therefore not be moved for about a second after it is switched on.

From raw data to tilt. Two estimates of the tilt are available, and each is good where the other is weak. The accelerometer gives the roll and pitch angles directly from the direction of gravity,

ϕacc = atan2(ay, az), θacc = atan2 −ax,

q
a

2
y + a

2
z
, | (2.7)

but this estimate is disturbed every time the robot accelerates or vibrates. The gyroscope, integrated over time, follows fast changes cleanly but slowly drifts away from the true angle. The firmware blends the two with a complementary filter, run on every pass of the main loop:
ϕk = 0.96 (ϕk−1 + ωx ∆t) + 0.04 ϕacc, | (2.8)

and the same for the pitch θ with ωy. The gyroscope term dominates over short times, while the small accelerometer share slowly pulls the estimate back and cancels the drift. Every 50 ms (20 Hz) the robot sends the roll, the pitch and the three angular rates to the controller, which shows them on its MPU6050 screen.

Why the MPU6050. It is a common and cheap module that gives six axes over two wires, and it was available to us. The yaw angle, the heading, cannot be corrected the same way, because gravity gives no reference for it; it would need a magnetometer, and the firmware does not compute it.

### 2.4.7 Power supply

The battery. The robot runs from two 18650 lithium-ion cells, the cylindrical 18 mm by 65 mm format used in laptop packs and power banks. Ours are METAMA cells labelled 3.7 V and 2500 mAh; we found no datasheet for them, so the label values are all we use. The two cells sit in a two-slot holder and are connected in series, the positive terminal of one to the negative terminal of the other, which makes a 2S pack:

- nominal voltage 2 × 3.7 = 7.4 V, rising to about 8.4 V when fully charged (4.2 V per cell, the usual full-charge voltage of a lithium-ion cell);
- capacity 2500 mAh, since cells in series share the same current;
- nominal energy about 7.4 V × 2.5 Ah ≈ 18.5 Wh.

How long the robot runs on one charge is measured in Chapter 3 (test T2) rather than estimated here. The cells are removed from the robot and charged in a separate two-slot lithium-ion charger.

Distribution. The pack feeds two branches, as shown in Figure 2.1. The first goes straight to the motor supply pin VM of the DRV8833, whose 2.7 to 10.8 V range covers the whole 2S range (Section 2.4.2). The second goes to a step-down converter that produces the 5 V for the ESP32-S3 board, whose own regulator then makes the 3.3 V the module and the LM393 sensors use. The HC-SR04, which needs 5 V, takes it from the board’s 5 V pin, that is from the converter’s output (pins_esp32s3.h).

The step-down converter. A pack that reaches 8.4 V cannot be connected to the board’s 5 V pin directly. A linear regulator would turn the difference into heat; a switching buck converter instead switches the input on and off at high frequency and smooths the result with an inductor and a capacitor, so it wastes far less. We use a Mini360 module, a very small buck board built around the MP2307 controller, whose output voltage is set with an on-board trimmer. Before the ESP32-S3 was connected, we fed the module 7.4 V from a bench power supply and turned the trimmer until a multimeter read 5 V at its output. Its main figures, from a module description [21], are an input of 4.75 to 23 V, an output of 1 to 17 V, and 1.8 A continuous (3 A peak). The ESP32-S3 draws at most about 340 mA, while transmitting over Wi-Fi [9], so the converter works far below its limit.

What is missing. The pack has no battery management system (BMS) and no fuse, and the main switch is planned but not fitted yet. A BMS would cut the load when a cell is over-discharged and stop overcharging, and a fuse would protect the wiring from a short circuit; without them, these protections rely on the user, who must not run the pack flat and must charge the cells in the dedicated charger. One of our cells failed during development and was replaced; we did not identify the cause. Adding a 2S BMS, a fuse and the switch is the first item of future work on the hardware.
Decoupling is also minimal. TI asks for at least 10 µF close to the DRV8833’s VM pin, which the module provides, and recommends adding a local bulk capacitor, rated above the supply voltage, whose size is to be found by testing [14]. No bulk capacitor has been added yet, nor the small ceramic capacitors often soldered across a DC motor’s terminals to absorb the noise of its brushes. Both are cheap to add: a 470 µF, 16 V electrolytic capacitor across the driver’s VM and GND pins, and a 0.1 µF capacitor on each motor.

## 2.5 The controller

The controller is the handheld unit the user drives the robot with. It reads a joystick and four buttons, shows menus and the robot’s data on a small screen, and talks to the robot over ESP-NOW. Its parts are shown in the upper half of Figure 2.1, and its pin assignment in Table 2.8.

### 2.5.1 Microcontroller: ESP32 DevKit

The controller uses a classic ESP32, the predecessor of the chip on the robot. Its main figures are a dual-core Xtensa LX6 processor at up to 240 MHz, 520 KB of SRAM, 2.4 GHz Wi-Fi (IEEE 802.11b/g/n), Bluetooth 4.2, two 12-bit analog-to-digital converters and 34 GPIOs, six of which are inputs only [8]. The board is a generic 30-pin development board of the “ESP32 DevKit V1” type, with a USB-C connector and a CP2102 USB-to-serial converter for programming. Its module carries no marking, so we cannot name it exactly; like the robot’s board, it takes 5 V on its VIN pin and regulates it to 3.3 V.

Why an ESP32. The controller’s job is light: read a few inputs, draw a 128 × 64 screen and exchange small packets with the robot. A classic ESP32 does this easily and it is the board we already had. Since it uses the same radio and the same ESP-NOW protocol as the ESP32-S3, the two ends speak to each other without any extra hardware.

A smaller and cheaper chip, such as the single-core ESP32-C3, would probably be enough and is left as a possible improvement.

Table | 2.8: | GPIO | assignment | on | the | controller | (firmware | file
Bloc-Con/include/config.h).
GPIO | | Connected to | | | | Note
34, 35 | joystick X, Y | ADC1, input-only pins
12, 13, 14, 27 buttons UP, DOWN, FORWARD, BACK to ground, internal pull-ups; 12 is a strapping pin (see
| | | | | | text)
21, 22 | OLED SDA, SCL | I²C

A pin to handle with care. GPIO 12 is one of the ESP32’s strapping pins: its level at reset, through the bit called MTDI, selects the voltage of the flash memory. Its default, set by an internal pull-down, is 0, which keeps the 3.3 V flash supply [8]. The UP button is connected to it, which is safe because the button can only pull the pin to ground and the firmware enables the internal pull-up only after boot. An external pull-up on this pin, however, could select the wrong flash voltage and stop the board from starting.

### 2.5.2 Human interface: joystick, buttons and display

Joystick. The KY-023 module is a two-axis thumb joystick: each axis moves the wiper of a potentiometer connected between the supply and ground, so the wiper voltage varies with the position of the stick and rests near mid-supply when the stick is released. The module also has a push switch, which the controller does not use. Although its supply pin is labelled +5 V, we power it from 3.3 V so that its outputs never exceed what the ESP32’s inputs accept. The two wipers go to GPIO 34 and 35, which belong to ADC1. This matters because the radio is on all the time and ADC2 is shared with the Wi-Fi driver [22], while ADC1 is not. The ADC converts each voltage into a 12-bit number, from 0 to 4095. Its accuracy is limited: the datasheet gives a non-linearity of up to 12 LSB and advises averaging several samples [8], which is what the firmware does (Chapter 3).

Buttons. Four push buttons, UP, DOWN, FORWARD (select) and BACK, navigate the menus. Each connects its GPIO to ground when pressed. The pins use the ESP32’s internal pull-up resistors, so no external resistor is needed: a released button reads high, a pressed one reads low.

Display. The screen is a 0.96-inch monochrome OLED of 128 × 64 pixels, driven by a Solomon Systech SSD1306 controller. It is connected over I²C on GPIO 21 (SDA) and GPIO 22 (SCL), at the address 0x3C, the one the SSD1306 answers to when its addressselect pin is low [23], and is powered from 3.3 V, within the controller’s 1.65 to 3.3 V logic supply range [23]. The firmware draws each screen in a frame buffer in the ESP32’s memory, 128×64/8 = 1024 bytes, and sends it to the display in one transfer. OLED pixels emit their own light, so the screen needs no backlight. During development we found the small 0.96-inch screens hard to read at arm’s length, so a larger 2.42-inch display of the same resolution, driven by the closely related SSD1309, is planned. The firmware already supports it through a single compile-time switch (USE_SSD1309), and the wiring is the same.

### 2.5.3 Power supply

The controller is powered by a single 18650 cell, a QHTC cell labelled 2000 mAh and 4.2 V. It is a cheaper cell than the robot’s, which is acceptable because the controller draws far less current than two motors. The power chain has three stages, shown in Figure 2.1.

Charging and protection: TP4056 module. The cell stays in the controller and is charged through a TP4056 module with a USB-C input. The TP4056 is a linear charger for single lithium-ion cells. It charges at constant current, set by a programming resistor, then at constant voltage once the cell reaches 4.2 V (within 1.5 %), and charges a deeply discharged cell gently until it rises above 2.9 V [24]. Our module carries no reference; it is identical in layout to a USB-C TP4056 module sold locally, whose listing we use for its figures [25]: a maximum charge current of 1000 mA.
Unlike the robot’s pack, the controller’s cell is protected. The module has separate terminals for the battery (B+, B−) and for the load (OUT+, OUT−), and according to that listing it disconnects the load when the cell falls to 2.5 V or when the current exceeds 3 A [25]. The power switch is placed on the load side, after the charger, so the cell can be charged with the controller switched off.

Boost: MT3608. A lithium-ion cell stays below 4.2 V even when fully charged, under the 5 V the ESP32 board expects on its VIN pin. A step-up (boost) converter raises it. The MT3608 accepts 2 to 24 V at its input, switches at 1.2 MHz and regulates its output so that its feedback pin sits at 0.6 V, which gives

VOUT = 0.6 V ×

1 +

R1
R2
, | (2.9)

where R1 and R2 form the divider from the output to the feedback pin [26]. On the module, R1 is a trimmer. The datasheet allows outputs up to 28 V, so the trimmer must be set to 5 V with a multimeter before the ESP32 is connected.

Load. The ESP32 draws up to about 240 mA while transmitting over Wi-Fi at full power [8], and the screen and joystick add little to this. A boost converter draws more current from the cell than it delivers, by the ratio of the voltages and its efficiency, so the controller’s runtime on one charge is measured rather than estimated (Chapter 3).

## 2.6 Wireless link: ESP-NOW

The controller and the robot communicate over ESP-NOW. This section explains what the protocol is, why it was chosen, and what its use in BLOC-BOT does and does not guarantee. The exact packet formats are given with the firmware in Chapter 3.

What ESP-NOW is. ESP-NOW is, in Espressif’s words, “a kind of connectionless Wi-Fi communication protocol that is defined by Espressif” [11]. It uses the same 2.4 GHz radio as Wi-Fi, but instead of joining a network, a device simply sends short frames addressed to another device’s MAC address, or to the broadcast address FF:FF:FF:FF:FF:FF so that every listening device receives them. No access point and no connection set-up are needed. A frame carries at most 250 bytes of data in version 1.0 of the protocol (1470 bytes in version 2.0), and a device can register up to 20 peers [11]. On reception, the firmware is notified by a callback function that receives the sender’s address and the data.

Why ESP-NOW and not Wi-Fi or Bluetooth. The link has a simple job: carry a few bytes of commands one way and a few bytes of measurements the other, several times per second, between two boards that are both Espressif chips.

- Wi-Fi in the usual sense would require one board to act as an access point and the other to join it before any data could flow, and then an IP-based protocol on top. This is more set-up than two boards exchanging small packets need.
- Bluetooth: the two chips do not even share the same versions. The controller’s ESP32 supports Bluetooth 4.2 in both its Classic and Low Energy forms [8], but the robot’s ESP32-S3 supports only Bluetooth 5 Low Energy [9]. A Bluetooth LE link would work, but it needs a connection between a central and a peripheral device and a description of the exchanged data as services and characteristics.
- ESP-NOW needs neither an access point nor a connection: each board can send as soon as the radio is started, and the same few lines of code run on both chips. The 250-byte limit is far above what BLOC-BOT needs, since its largest packet is 11 bytes.

The choice was also practical: the protocol was suggested to us during development, and it suits a system in which every board is an ESP32.

How BLOC-BOT uses it. Both boards send to the broadcast address, without pairing and without encryption, on the radio’s current channel. Every packet starts with a onebyte identifier, and the receiver accepts a packet only if both this identifier and the packet’s length match what it expects; anything else is ignored. The controller sends drive commands every 50 ms while its Drive screen is open, and the robot sends its wheel speeds and the measured distance every 100 ms and its tilt every 50 ms.

What the link does not guarantee. Three limits follow from these choices. The first is handled by the design; the other two remain open.

- Delivery. A successful send only means that the frame was received at the radio’s MAC layer; Espressif states that reception by the application is not guaranteed [11]. BLOC-BOT therefore does not rely on any single packet: commands are repeated every 50 ms, and the robot stops its motors if none arrives for 300 ms, that is after about six missed commands in a row (requirement FR3).
- Security and interference. Broadcast frames cannot be encrypted [11], and any ESP-NOW device in range that sends a packet with the same identifier and length would be obeyed. Two BLOC-BOTs used side by side would therefore interfere. Pairing each controller with its robot by MAC address, and enabling ESP-NOW’s encryption, which is available for paired devices [11], would remove this limit and is left as future work.
- Range. We have not measured the range of the link, and the documentation we used gives no figure for it, so the thesis states none.

## 2.7 The modular platform

Plan: | Written last, short. | Waffle plate (210 x 210 x 10 mm PETG, hole pattern
3.2/4.5/6.0 mm), blocs HBloc / VBloc / HBloc_L, pillars. Old plate (printed) vs new plate (designed): print time and mass. One or two figures, the print cost table.

## 2.8 Conclusion

Plan: Short bridge to Chapter 3 (realisation and tests).

# Chapter 3

# Realisation and tests

## 3.1 Introduction

Chapter 2 chose the components and explained how each one works. This chapter describes how they were put together: the wiring of the two boards, the firmware that runs on them, the problems met along the way and how they were solved, and the tests that show what the finished system does. It ends with the cost of the platform.

## 3.2 Wiring

Both boards are built from ready-made modules connected with jumper wires, so their schematics are drawn at module level, in KiCad: each module appears as a box carrying the pins of its header, and connections are made by giving the same net name to the pins that are joined, a common convention that keeps a schematic readable when many wires would cross. Only the microcontroller pins in use are shown. The robot’s schematic is given in Figure 3.1 and the controller’s in Figure 3.2; their pin assignments are those of Tables 2.3 and 2.8. KiCad’s electrical rules check reports no unconnected pin or dangling net on either sheet.
Three points of the robot’s wiring deserve a comment. The DRV8833’s STBY pin is tied to 3.3 V, so the driver is always enabled and no GPIO is spent on it, and its three NC pins, kept from the TB6612FNG board layout, are left open. The right motor’s inputs are wired to GPIO 17 and 18 in that order but swapped in the firmware, so that both wheels turn forward for the same command; changing two constants was simpler than rewiring. Finally, the HC-SR04’s ECHO line reaches GPIO 12 through the 1 kΩ/2 kΩ divider of Section 2.4.5.
On the controller, the cell is connected to the battery terminals (B+, B−) of the TP4056 module and everything else to its protected output (OUT+, OUT−), so the protection of Section 2.5.3 covers the whole controller. The power switch sits between that output and the MT3608, and the four buttons go straight from their GPIO to ground. Plan: Photos of the wired robot and controller. [TODO: photos]

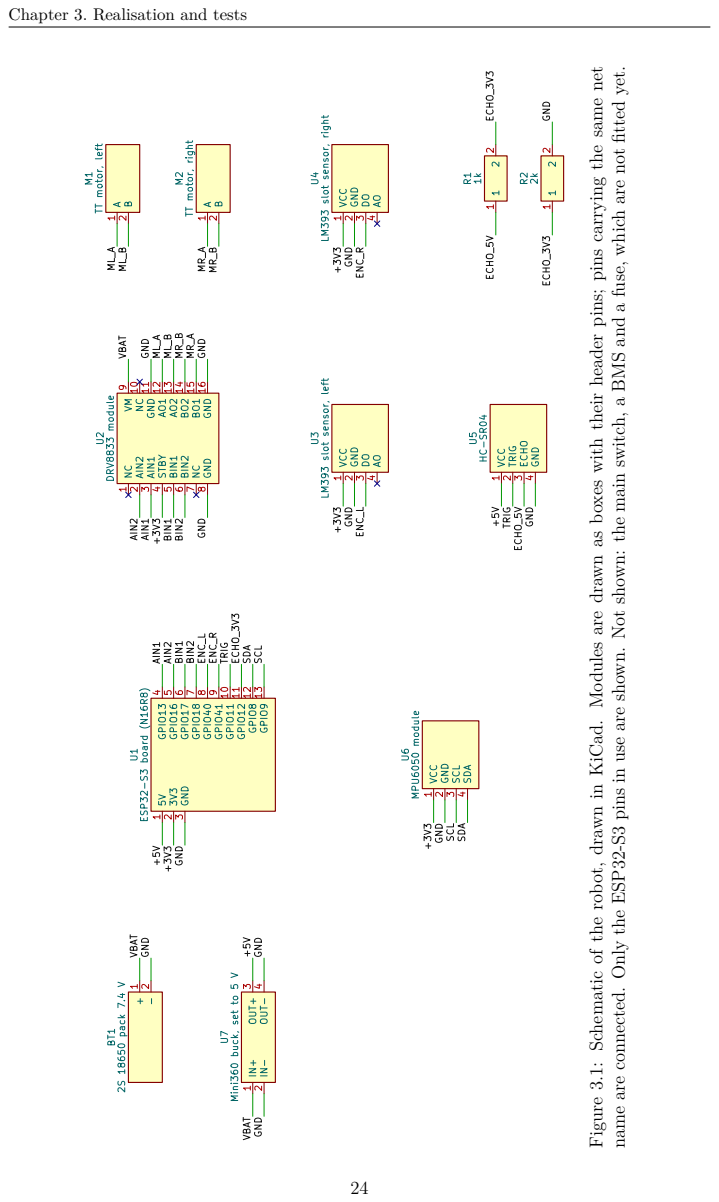
[picture p3: page 26]

Chapter 3. Realisation and tests

ECHO_5V Figure 3.1: Schematic of the robot, drawn in KiCad. Modules are drawn as boxes with their header pins; pins carrying the same net name are connected. Only the ESP32-S3 pins in use are shown. Not shown: the main switch, a BMS and a fuse, which are not fitted yet.

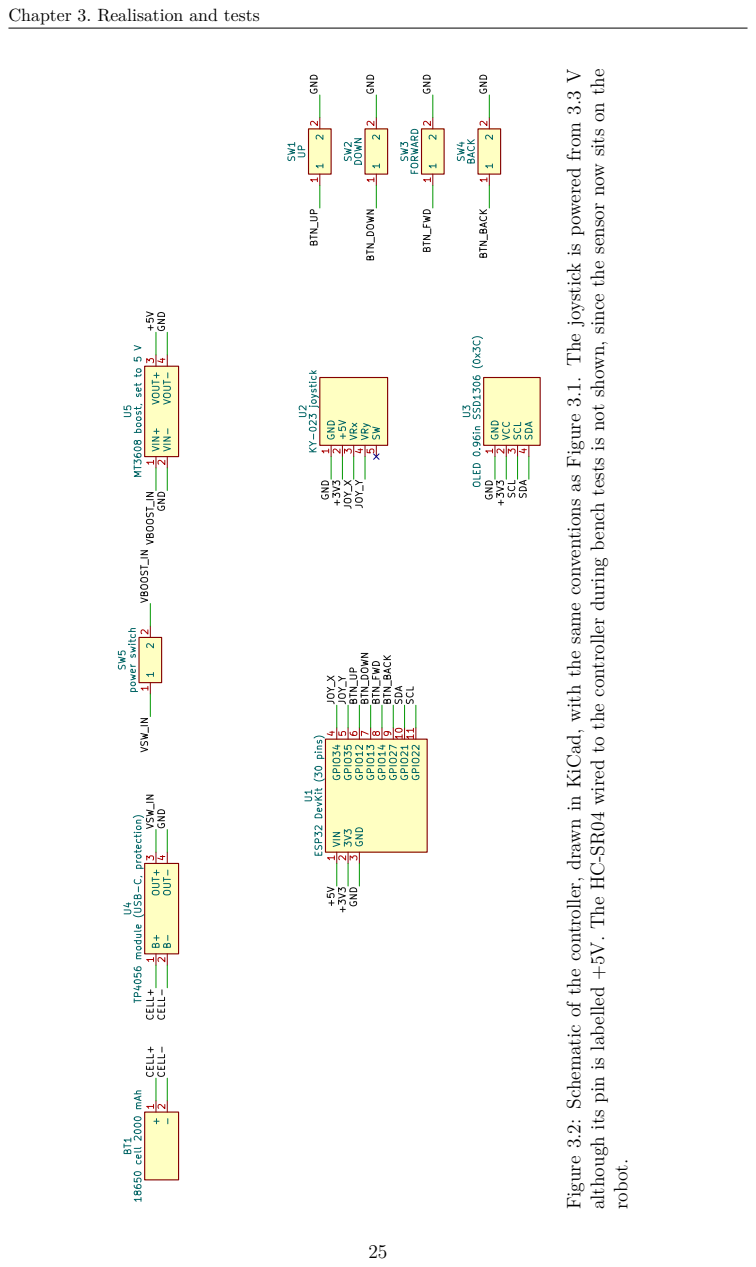
[picture p4: page 27]

Chapter 3. Realisation and tests

JOY_Y Figure 3.2: Schematic of the controller, drawn in KiCad, with the same conventions as Figure 3.1. The joystick is powered from 3.3 V although its pin is labelled +5V. The HC-SR04 wired to the controller during bench tests is not shown, since the sensor now sits on the robot.

Chapter 3. Realisation and tests

## 3.3 Firmware

### 3.3.1 Tools

Both boards are programmed in C++ with the Arduino framework for Espressif chips, inside PlatformIO, an open build system that fetches the toolchain and the libraries a project declares and builds and uploads the firmware. Each board has its own project: the robot’s at the root of the repository, the controller’s in Bloc-Con. The controller also uses the U8g2 graphics library to drive its display. All the source code is kept in a single Git repository, whose history is also the record of what was changed and when. The firmware is built with PlatformIO Core 6.1.19, its Espressif 32 platform 7.1.2 and version 2.0.17 of the Arduino core for ESP32. The controller’s firmware was also run in Wokwi, an online simulator for microcontroller boards, before it was loaded on the real board. The simulated circuit, kept in the project as diagram.json, contains an ESP32 board, an SSD1306 display, an analogue joystick, the four push buttons and an HC-SR04, so the menus and screens could be tried without the hardware.
The code of each board is split into one file per function, listed in Table 3.1, so that each part can be read, tested and changed on its own. The packet formats are defined in a single header, packets.h, kept identical in both projects so that the two ends always agree on them.

### 3.3.2 Communication protocol

The two boards exchange four kinds of packet over ESP-NOW (Section 2.6), listed in Table 3.2. Each is a C structure sent as raw bytes. Its first byte is an identifier, and the receiver accepts a packet only when both this identifier and the packet’s length match one of the structures it knows. Values that are naturally fractional are scaled to integers to keep the packets small: distances are sent in millimetres and angles in tenths of a degree. The drive command is only sent while the controller’s Drive screen is open. Leaving that screen with the BACK button sends three stop commands in a row, so that the robot stops at once instead of waiting for its failsafe. On the controller, a value received from the robot is shown only if it is less than 500 ms old; otherwise the screen shows “–” or a waiting message.

### 3.3.3 Robot firmware

Structure. The robot’s firmware is a single loop that runs every 10 ms (Figure 3.3). Each pass handles the bench-test serial commands, applies the latest drive command, sends the wheel speeds, the inertial data and the distance when their period has elapsed, and finally updates the motors. Work that cannot wait for the loop is done in interrupt routines: the radio callback stores each drive command as it arrives, the two encoder interrupts time the wheel pulses (Section 2.4.4), and the echo interrupt times the ultrasonic pulse (Section 2.4.5). No function in the loop waits for a sensor, so the motor ramp and the failsafe always run on time.

From command to wheel speeds. The robot is driven like a tank: each wheel has its own motor, and turning comes from a difference in speed between them. The drive command carries a forward value f and a turn value t, both between −100 and +100.

Chapter 3. Realisation and tests

Table 3.1: Organisation of the firmware (.cpp file and its .h header).

File | Role

Robot
main | start-up and the 10 ms main loop
radio | ESP-NOW set-up, sending, reception
| callback
drive | drive commands: reception, mixing,
| link indicator
motor | PWM output, soft start, failsafe
encoders | wheel-speed measurement
ultrasonic | HC-SR04, echo timed by interrupt
imu | MPU6050 and the complementary
| filter
bench | serial commands for bench tests
pins_esp32s3.h | pin assignment

Controller
main | start-up and the main loop
radio | ESP-NOW set-up, drive commands,
| data received from the robot
joystick | calibration and reading
ui | buttons, menu, splash, About and
| Settings screens
screen_drive, screen_ultrasonic, screen_mpu one file per screen
display, config.h | display object, pin assignment
packets.h | packet formats, shared by both
| projects

Table 3.2: ESP-NOW packets exchanged between the controller (Con) and the robot (Bloc). All multi-byte fields are signed 16-bit integers.

ID | Direction | Content | Size | Period

0xB1 Con → Bloc forward and turn commands, each from −100 to
| | +100 (8-bit) | 3 B | 50 ms

0xB2 Bloc → Con left and right wheel speeds, mm/s, negative in re-
| | verse | 5 B | 100 ms

0xB4 Bloc → Con roll and pitch (0.1°), angular rates about x, y, z
| | (0.1°/s) | 11 B | 50 ms
0xB5 Bloc → Con distance in mm, −1 when no object is in range | 3 B | 100 ms

Chapter 3. Realisation and tests

Interrupts, any time
radio: store drive command and its time
encoders: time each wheel
pulse
echo: time the ultrasonic pulse

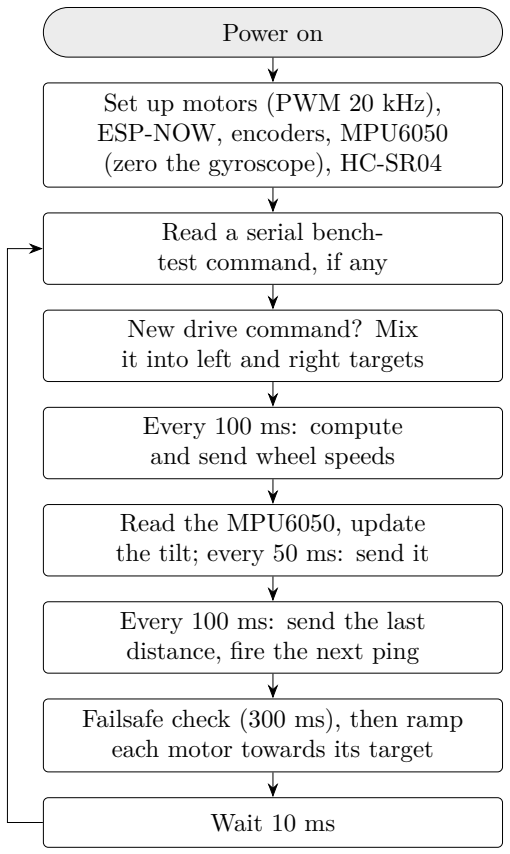
[picture p5: figure]
Power on; Set up motors (PWM 20 kHz), ESP-NOW, encoders, MPU6050 (zero the gyroscope), HC-SR04; Read a serial bench- test command, if any; New drive command? Mix it into left and right targets; Every 100 ms: compute and send wheel speeds; Read the MPU6050, update the tilt; every 50 ms: send it; Every 100 ms: send the last distance, fire the next ping; Failsafe check (300 ms), then ramp each motor towards its target; Wait 10 ms

Figure 3.3: Main loop of the robot firmware. Dashed: work done in interrupt routines, outside the loop.

Chapter 3. Realisation and tests

The firmware mixes them into a target for each wheel,

L = clamp(f + t)

204
100

, R = clamp(f − t)

204
100
, | (3.1)

where clamp limits the sum to ±100 and 204 is the PWM cap of Section 2.4.2. Pushing the stick straight ahead (f = 100, t = 0) drives both wheels forward at the cap; pushing it fully to the right (f = 0, t = 100) turns the wheels in opposite directions and the robot spins on the spot; any position in between gives a curve.

Soft start. The firmware does not apply a new target at once. Every 10 ms it moves each motor’s duty cycle by at most 5 steps towards its target, so going from rest to the 80 % cap takes about 0.4 s, and so does a reversal from full forward to standstill. This limits the current surge when a motor starts (Section 2.4.7) and makes the robot’s starts and stops smoother.

Failsafe. Every time a drive command is applied, the firmware records the time. If more than 300 ms pass without a new one, because the controller was switched off, left the Drive screen or went out of range, the firmware stops both motors immediately, without ramping, and they coast to a halt. This meets requirement FR3. With commands sent every 50 ms, the failsafe tolerates five lost packets in a row and acts on the sixth.

Bench-test interface. During development the robot can also be driven from a computer through its USB serial port: single letters drive forward, backward, turn, spin or stop, and L or R followed by a number sets one motor directly. A serial command runs for 2 s and then lets the failsafe stop the motors, so a robot on the bench never keeps running unattended. This interface is a tool for testing, not part of normal use.

### 3.3.4 Controller firmware

Screens. The controller’s firmware is organised as a set of screens, only one of which is active at a time (Figure 3.4). It starts with an animated splash screen, then shows a menu with seven entries: Start, Settings, Ultrasonic, MPU6050, Drive, About and Reset. UP and DOWN move the selection, FORWARD opens the selected screen, and BACK returns to the menu from anywhere. Start does nothing yet and Settings only shows “Coming soon”; Reset restarts the controller. The main loop reads the buttons, redraws the active screen and waits 20 ms. A button press is ignored if it comes less than 180 ms after the previous one, which filters out contact bounce and stops a held button from scrolling too fast.

Reading the joystick. At start-up, with the stick released, the firmware takes 50 readings of each axis over about a quarter of a second and stores their average as the centre position. On the Drive screen, each axis is then read eight times and averaged, as the ESP32 datasheet advises for its converter [8]. The centre is subtracted, the result is divided by 20, and values smaller than 4 in magnitude, that is within 80 counts of the centre, are set to zero. This dead zone keeps the robot still when the stick rests slightly off centre. The forward and turn commands are finally scaled so that a value of 90 gives the full command of 100, and larger values are clipped. Since the end of the stick’s travel corresponds to about 2048/20 ≈ 102, full speed is reached near the end of the travel, and

Chapter 3. Realisation and tests

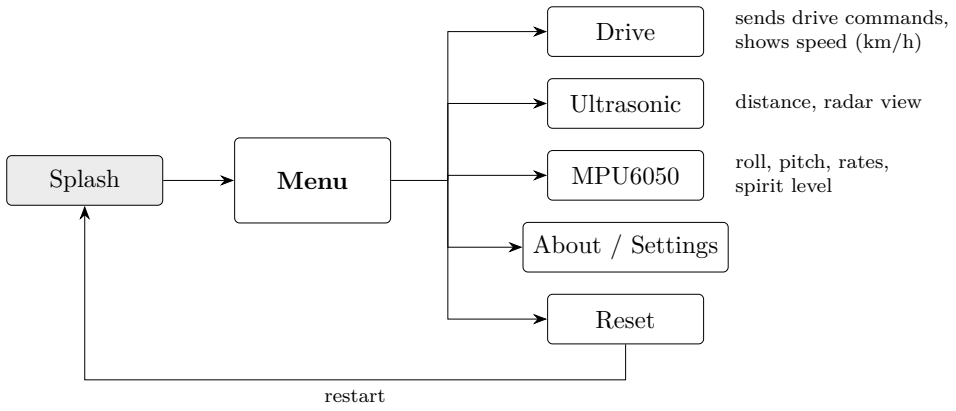
[picture p6: figure]
Splash; Menu; Drive; Ultrasonic; MPU6050; About /; Settings; Reset; restart; sends drive commands, shows speed (km/h); distance, radar view; roll, pitch, rates, spirit level

Figure 3.4: Screens of the controller. FORWARD opens the selected screen from the menu, and BACK returns to the menu from every screen.

the small margin makes sure it can always be reached. An earlier version used 30 instead of 90: full speed then came at less than a third of the travel, which made slow, precise driving difficult, so the scale was widened to use almost the whole stick.

Drive screen. The Drive screen draws a circle with a dot that follows the stick, the scaled X and Y values, and the robot’s speed in kilometres per hour: the average of the two wheel speeds received from the robot, converted from mm/s by the factor 0.0036.

Ultrasonic and MPU6050 screens. The Ultrasonic screen prints the distance received from the robot and draws a radar-style view, in which the obstacle appears as a dot at the measured distance. The sweeping line of this view is only an animation: the sensor itself does not turn, so the angle at which the dot appears carries no information. The MPU6050 screen prints the roll, the pitch and the three angular rates, and draws a spirit level whose dot moves with the tilt. Both screens can also read a sensor wired directly to the controller, a fallback kept from bench testing that is used only when no data arrives from the robot; each screen shows in a corner which source it is using.

## 3.4 Problems met and solutions

Several things did not work the first time. They are listed here in the order we met them, each with its symptom, its cause as far as we could establish it, and the fix. Most of them are small, but together they shaped the final design, and several left a trace in the firmware or the wiring described earlier.

The motors did not turn with the DRV8871. The robot was first wired with two DRV8871 drivers, and the motors never turned. We did not measure the battery voltage at the time, but the driver’s datasheet gives a likely cause: it needs at least 6.5 V and locks out when its supply falls to about 6.1 to 6.4 V, very close to what a 2S pack gives under load (Section 2.4.2). We replaced both with a single DRV8833, which works from 2.7 V, and the motors ran at once.

Chapter 3. Realisation and tests

The left motor would not run forward. With its AIN1 input on GPIO 15, the left motor would not run forward. We first suspected the pin and moved the signal to GPIO 13, after which the motor worked; we later found that the real cause was a faulty jumper wire. The signal stayed on GPIO 13. The lesson was to check the wiring before suspecting the microcontroller.

The right motor turned the wrong way. For the same forward command, the right wheel turned backward. Instead of rewiring the motor, we swapped the two pin numbers of the right motor in the firmware, so that both wheels turn forward together (Section 3.2).

The 5 V echo of the ultrasonic sensor. The HC-SR04 was at first connected straight to the board, so its 5 V ECHO pulse reached a 3.3 V input whose limit is the supply voltage plus 0.3 V [9], which is outside the chip’s ratings. A 1 kΩ/2 kΩ divider now brings the pulse to 3.33 V (Section 2.4.5).

The speed reading jumped. The first speed measurement counted the pulses received in each 100 ms window. With only a few pulses per window, one pulse more or less made the displayed speed jump between distant values. Timing the interval between pulses, then smoothing the result, removed the steps (Section 2.4.4).

The speed was too high. The firmware assumed encoder discs with 16 slots. Counting them on the robot gave 20, so every distance and speed was overestimated by 20/16 = 1.25. The constant was corrected. This explains part of the speeds of up to about 10 km/h seen on the controller during early tests, which were far above what the motors can reach (Section 2.4.3); the rest is examined in test T1 (Section 3.5).

Full speed too early on the joystick. The controller first reached the full drive command with the stick at about a third of its travel, so small movements of the thumb gave large changes of speed. The scale was widened so that full speed is reached near the end of the travel (Section 3.3.4).

A slow and heavy first plate. The first waffle plate, printed before we had any experience with 3D printing, took about 45 hours and weighs about 200 g. It still carries the robot today, but it led to the redesign described in Section 2.7.

## 3.5 Tests and results

The tests below were chosen to give a number that can be checked, or something that can be shown at the defence. For each one, the raw data is kept in the folder thesis/results/ of the repository.

### 3.5.1 T1: real speed against displayed speed

Purpose. To check that the speed shown on the controller is the real speed of the robot, and to explain the high readings of the early tests.

Chapter 3. Realisation and tests

Procedure. A 2 m straight course is marked on the floor with tape. The robot starts about 1 m before the first mark, so that it has reached a steady speed, and is driven straight at full command. The time between the two marks is taken from a phone video, three runs in a row, and the speed displayed on the controller is noted during each run. The measured speed is v = 2 m/t.

Expected. A speed below about 3 km/h, the no-load figure of the motors (Section 2.4.3), and a displayed speed that agrees with it within the resolution of the encoders.

Results. [TODO: three times, the three displayed speeds, table and comment]

### 3.5.2 Running time on one charge

The running time of the robot was deliberately not measured. Measuring it means running the pack down to empty, and since the pack has no battery management system (Section 2.4.7), nothing would stop the cells from being over-discharged and damaged during the test; one cell had already failed during development.
An order of magnitude is enough for the intended use. The pack holds 2500 mAh, or about 18.5 Wh (Section 2.4.7). Even if the robot drew an average of 1 A from it, an assumption well above the no-load current of the two motors (2 × 0.16 A, Table 2.6) plus the electronics, the pack would last in the order of two hours. A demonstration or a competition run lasts a few minutes, so the running time is not a limitation in practice. Measuring it properly, with a BMS fitted to cut off the pack safely, is left for future work.

### 3.5.3 T3: ultrasonic distance

Purpose. To check the distances measured by the HC-SR04 and sent to the controller.

Procedure. A flat box is placed in front of the robot at 10, 20, 50 and 100 cm, measured with a tape from the front of the sensor, and the distance shown on the controller is noted for each.

Results. In use, the distance shown on the controller follows the obstacle up to 59.9 cm, then stays at 59.9 cm whatever the real distance. This is far below the 4 m given in the datasheet [18]. [TODO: cause: a floor echo is the likely one (sensor about 10–

### 11 cm above the floor, beam of about 15°); check by lifting or tilting the sensor

towards a wall at 1 m, then write the result; table at 10, 20 and 50 cm: real, displayed, difference]

### 3.5.4 T4 and T5: printed parts and mass

Fits. Two dimensions were corrected after the first prints: the hole for the jaw screw of the blocs, reduced from 6.2 to 6.0 mm in diameter, and the clearance of the glued joints, increased from 0.14 to 0.20 mm per side. [TODO: photos of the parts]

Chapter 3. Realisation and tests

Print time and mass. The print time and mass of each part are given in Table 3.3. The robot described here is still a prototype: it runs on the first waffle plate, while the two plates of the new design (lower and upper), the pillars and a new set of blocs are being printed. [TODO: print time and filament of the final parts from the slicer, once printed] Its total mass has not been weighed; we estimate it at 0.8 to 1 kg. [TODO: weigh the final robot on a kitchen scale]

### 3.5.5 Demonstrations

Four behaviours are shown live rather than measured: driving the robot from the controller with its speed on the screen (D1); switching the controller off while the robot moves, after which the robot stops by itself within 300 ms (D2); moving a bloc to another position on the plate in a few seconds (D3); and, once it works, following a line of tape (D4). The safety stop has been checked on the robot: when the controller is switched off while the robot moves, the robot stops at once. Videos of the robot in use have been recorded as a back-up in case a demonstration fails on the day. [TODO: which demos the 2–3 videos show]

## 3.6 Cost

Printed parts. Table 3.3 gives the mass, print time and material cost of the printed parts. Masses and times are read from the slicer’s G-code for each part, except the waffle plate in use, an early print for which only our own estimate is available. The cost is the mass of PETG at 4000 DA per kilogram, with and without a 5 % allowance for waste.

Table 3.3: | Printed parts: | mass, print time and PETG cost at 4000 DA/kg
(results/print_cost/print_cost.csv).
Part | Mass (g) Print time Cost (DA) +5 % waste
Motor brackets (left and right) | 29.5 | 1 h 18 | 118 | 124
HBloc_L (line sensor holder) | 28.0 | 1 h 15 | 112 | 117
VBloc | 16.4 | 1 h 15 | 66 | 69
HBloc | 13.9 | 0 h 39 | 56 | 59
Caster support | 19.4 | 0 h 41 | 78 | 82
Waffle plate (first version, in use)a | 200.0 | 45 h 00 | 800 | 840
Total | 307.2 | 50 h 08 | 1229 | 1290

a Estimated by the team (about 200 g and 1 day 21 h); all other rows from the G-code.

Electronics. Table 3.4 lists the electronic parts with the prices we paid in Algerian shops (results/bom_cost/paid_prices.csv). Tools, such as the two-slot charger (3000 DA), and parts bought for features not built yet, the five-channel line sensor (800 DA) and the Flying Fish infrared sensor (500 DA), are not counted.
The electronics of one robot cost 9400 DA, and those of the controller about 3800 to 3950 DA, to which the printed parts of Table 3.3 add about 1230 to 1290 DA of PETG.

Chapter 3. Realisation and tests

Table 3.4: Electronic parts and the prices paid (DA). [TODO: MT3608 price]

Part | Unit price Qty | Total

Robot
ESP32-S3 board (N16R8) | 2000 | 1 | 2000
TT gearmotor | 550 | 2 | 1100
Wheel | 250 | 2 | 500
DRV8833 module | 500 | 1 | 500
Mini360 buck converter | 400 | 1 | 400
LM393 slotted speed sensor | 500 | 2 | 1000
HC-SR04 | 600 | 1 | 600
MPU6050 module | 600 | 1 | 600
Two-cell 18650 holder | 400 | 1 | 400
18650 cell, 2500 mAh | 1000 | 2 | 2000
Caster wheel | 300 | 1 | 300
Robot total | | | 9400

Controller
ESP32 DevKit | 1600 | 1 | 1600
KY-023 joystick | 500 | 1 | 500
Push button | 50 | 4 | 200
TP4056 module | 200 | 1 | 200
Single 18650 holder | 200 | 1 | 200
OLED 0.96” | 800 | 1 | 800
MT3608 boost converter | [TODO: ?] | 1 [TODO: ?]
18650 cell, 2000 mAh | 250 | 1 | 250
Power switcha | 50–200 | 1 | 50–200
Controller totalb | | | 3800–3950

a Exact price not remembered. b Without the MT3608.

Chapter 3. Realisation and tests

## 3.7 Conclusion

Plan: What works against the requirements of Table 2.1, what the tests show, and what is left for the general conclusion.

# Bibliography

[1] R. Siegwart and I. R. Nourbakhsh, Introduction to Autonomous Mobile Robots. Cambridge, MA: MIT Press, 2004.
[2] F. Mondada, M. Bonani, et al., “The e-puck, a robot designed for education in engineering,” in Proceedings of the 9th Conference on Autonomous Robot Systems and Competitions, Castelo Branco, Portugal, 2009, pp. 59–65. Accessed: Oct. 26, 2026. [Online]. Available: https : / / www . epfl . ch / labs / disal / research / epuckwheeledrobot (https://www.epfl.ch/labs/disal/research/epuckwheeledrobot)
[3] F. Riedo, M. Chevalier, S. Magnenat, and F. Mondada, “Thymio II, a robot that grows wiser with children,” in 2013 IEEE Workshop on Advanced Robotics and its Social Impacts (ARSO), Tokyo, Japan, 2013, pp. 187–193. doi: 10.1109/ARSO. 2013.6705527 (https://doi.org/10.1109/ARSO.2013.6705527)
[4] MHTronic. “Kits châssis de voiture robotisée intelligente 2 roues.” Product page (Algerian shop), in French, Accessed: Oct. 26, 2026. [Online]. Available: https://mhtronic.com/produit/kits-chassis-de-voiture-robotisee-intelligente-2-roues/ (https://mhtronic.com/produit/kits-chassis-de-voiture-robotisee-intelligente-2-roues/)
[5] M. Yim et al., “Modular self-reconfigurable robot systems: Challenges and opportunities for the future,” IEEE Robotics & Automation Magazine, pp. 43–53, Mar. 2007.
[6] Arduino. “UNO R3.” Product documentation, Accessed: Oct. 26, 2026. [Online]. Available: https://docs.arduino.cc/hardware/uno-rev3/
[7] Atmel, ATmega328P 8-bit AVR microcontroller with 32k bytes in-system programmable flash (automotive), 7810D-AVR-01/15, Datasheet summary, 2015. Accessed: Oct. 26, 2026. [Online]. Available: https : / / ww1 . microchip . com / downloads / en / DeviceDoc / Atmel - 7810 - Automotive - Microcontrollers -ATmega328P_Datasheet.pdf (https://ww1.microchip.com/downloads/en/DeviceDoc/Atmel-7810-Automotive-Microcontrollers-ATmega328P_Datasheet.pdf)
[8] Espressif Systems, ESP32 Series Datasheet, Version 5.3. Accessed: Oct. 21, 2026. [Online]. Available: https : / / www . espressif . com / sites / default / files / documentation/esp32_datasheet_en.pdf (https://www.espressif.com/sites/default/files/documentation/esp32_datasheet_en.pdf)
[9] Espressif Systems, ESP32-S3 Series Datasheet, Version 2.2, Mar. 5, 2026. Accessed: Oct. 21, 2026. [Online]. Available: https://www.espressif.com/sites/default/files/documentation/esp32-s3_datasheet_en.pdf (https://www.espressif.com/sites/default/files/documentation/esp32-s3_datasheet_en.pdf)
[10] Nordic Semiconductor, nRF24L01+ single chip 2.4ghz transceiver product specification, Revision 1.0, 2008. Accessed: Oct. 26, 2026. [Online]. Available: https : //cdn.sparkfun.com/assets/home_page_posts/2/6/7/3/nRF24L01P.pdf

Bibliography

[11] Espressif Systems. “ESP-NOW – ESP32.” ESP-IDF Programming Guide v6.1, Accessed: Oct. 25, 2026. [Online]. Available: https : / / docs . espressif . com / projects/esp-idf/en/stable/esp32/api-reference/network/esp_now.html (https://docs.espressif.com/projects/esp-idf/en/stable/esp32/api-reference/network/esp_now.html)
[12] Espressif Systems, ESP32-S3-WROOM-1 / WROOM-1U Datasheet, Version 1.8, Mar. 2, 2026. Accessed: Oct. 21, 2026. [Online]. Available: https : / / www . espressif . com / sites / default / files / documentation / esp32 -s3-wroom-1_wroom-1u_datasheet_en.pdf (https://www.espressif.com/sites/default/files/documentation/esp32-s3-wroom-1_wroom-1u_datasheet_en.pdf)
[13] Espressif Systems, ESP32-S3-DevKitC-1 v1.1 User Guide, Online documentation. Accessed: Oct. 21, 2026. [Online]. Available: https : / / docs . espressif . com / projects/esp- dev- kits/en/latest/esp32s3/esp32- s3- devkitc- 1/user_ guide_v1.1.html (https://docs.espressif.com/projects/esp-dev-kits/en/latest/esp32s3/esp32-s3-devkitc-1/user_guide_v1.1.html)
[14] Texas Instruments, DRV8833 Dual H-Bridge Motor Driver, SLVSAR1E, Datasheet, revised July 2015, 2015. Accessed: Oct. 10, 2026. [Online]. Available: https://www.ti.com/lit/gpn/DRV8833
[15] Texas Instruments, DRV8871 3.6-A Brushed DC Motor Driver With Internal Current Sense, SLVSCY9B, Datasheet, revised July 2016, 2016. Accessed: Oct. 21, 2026. [Online]. Available: https://www.ti.com/lit/ds/symlink/drv8871.pdf
[16] Adafruit Industries. “DC Gearbox Motor – “TT Motor” – 200RPM – 3 to 6VDC.” Product 3777, technical details, Accessed: Oct. 21, 2026. [Online]. Available: https: //www.adafruit.com/product/3777
[17] Texas Instruments, LM393B, LM2903B, LM193, LM293, LM393 and LM2903 Dual Comparators, SLCS005AH, Datasheet, revised April 2025, 2025. Accessed: Oct. 24, 2026. [Online]. Available: https://www.ti.com/lit/ds/symlink/lm393.pdf
[18] ElecFreaks, Ultrasonic Ranging Module HC-SR04, Datasheet, hosted by SparkFun Electronics. Accessed: Oct. 24, 2026. [Online]. Available: https://cdn.sparkfun.com/datasheets/Sensors/Proximity/HCSR04.pdf (https://cdn.sparkfun.com/datasheets/Sensors/Proximity/HCSR04.pdf)
[19] InvenSense Inc., MPU-6000 and MPU-6050 Product Specification, Revision 3.1, PS-MPU-6000A-00, Oct. 24, 2011. Accessed: Oct. 24, 2026. [Online]. Available: https: //cdn.sparkfun.com/datasheets/Components/General%20IC/PS-MPU-6000A. pdf (https://cdn.sparkfun.com/datasheets/Components/General%20IC/PS-MPU-6000A.pdf)
[20] InvenSense Inc., MPU-6000 and MPU-6050 Register Map and Descriptions, Revision 4.0, RM-MPU-6000A-00, Mar. 9, 2012. Accessed: Oct. 24, 2026. [Online]. Available: https://cdn.sparkfun.com/datasheets/Sensors/Accelerometers/RM-MPU-6000A.pdf (https://cdn.sparkfun.com/datasheets/Sensors/Accelerometers/RM-MPU-6000A.pdf)
[21] Components101. “Mini360 DC-DC Buck Converter Module Pinout, Datasheet, Features, Specs and Applications,” Accessed: Oct. 24, 2026. [Online]. Available: https: //components101.com/modules/mini360-dc-dc-buck-converter-module
[22] Espressif Systems. “Analog to Digital Converter (ADC) Oneshot Mode Driver – ESP32.” ESP-IDF Programming Guide v6.1, Accessed: Oct. 24, 2026. [Online]. Available: https : / / docs . espressif . com / projects / esp - idf / en / stable / esp32/api-reference/peripherals/adc/adc_oneshot.html (https://docs.espressif.com/projects/esp-idf/en/stable/esp32/api-reference/peripherals/adc/adc_oneshot.html)
[23] Solomon Systech, SSD1306 128 x 64 Dot Matrix OLED/PLED Segment/Common Driver with Controller, Rev 1.1, Apr. 2008. Accessed: Oct. 24, 2026. [Online]. Available: https://cdn-shop.adafruit.com/datasheets/SSD1306.pdf

Bibliography

[24] NanJing Top Power ASIC Corp., TP4056 1A Standalone Linear Li-ion Battery Charger with Thermal Regulation in SOP-8, Datasheet, hosted by SparkFun Electronics. Accessed: Oct. 24, 2026. [Online]. Available: https : / / dlnmh9ip6v2uc . cloudfront.net/datasheets/Prototyping/TP4056.pdf (https://dlnmh9ip6v2uc.cloudfront.net/datasheets/Prototyping/TP4056.pdf)
[25] Esp32Lab. “Chargeur LiPo USB-C TP4056.” Product page (Algerian shop), in French, Accessed: Oct. 24, 2026. [Online]. Available: https : / / esp32lab . com / boutique/chargeur-lipo-usb-c-tp4056/ (https://esp32lab.com/boutique/chargeur-lipo-usb-c-tp4056/)
[26] Aerosemi Technology, MT3608 High Efficiency 1.2MHz 2A Step Up Converter, Datasheet, hosted by Olimex. Accessed: Oct. 24, 2026. [Online]. Available: https://www.olimex.com/Products/Breadboarding/BB-PWR-3608/resources/MT3608. pdf (https://www.olimex.com/Products/Breadboarding/BB-PWR-3608/resources/MT3608.pdf)
