seiftotal30-source/BLOC-BOT/thesis/main.tex

% BLOC-BOT thesis -- main file. Build: latexmk -pdf -interaction=nonstopmode main.tex (biber).
% Each chapter lives in chapters/. Front matter (cover, abstracts) comes later.
\documentclass[12pt,a4paper]{report}

\usepackage{cmap}        % before fontenc: makes the PDF text searchable and copyable
\usepackage[a4paper,margin=2.5cm]{geometry}
\usepackage[utf8]{inputenc}
\usepackage[T1]{fontenc}
\usepackage{lmodern} % vector fonts; without it T1 falls back to blurry bitmap fonts
\usepackage{amsmath,amssymb}
\usepackage{graphicx}
\usepackage{float}
\usepackage{booktabs}
\usepackage{tabularx}    % any table with a text column: use an X column so it wraps
\usepackage{longtable}   % list of abbreviations
\usepackage{multirow}
\newcolumntype{L}[1]{>{\raggedright\arraybackslash}p{#1}}
\newcolumntype{Y}{>{\raggedright\arraybackslash}X}

% Table of contents shows "Chapter 1: Generalities".
\usepackage[titles]{tocloft}
\renewcommand{\cftchappresnum}{Chapter~}
\renewcommand{\cftchapaftersnum}{:}
\AtBeginDocument{\settowidth{\cftchapnumwidth}{\bfseries Chapter~0:\ }}
\usepackage{caption}
\usepackage{pdfpages}    % separately built cover / Arabic abstract
\usepackage{rotating}    % sidewaysfigure, for the schematics
\usepackage{xcolor}
\usepackage{tikz}
\usetikzlibrary{arrows.meta, positioning, calc, fit, backgrounds}
\usepackage[european]{circuitikz} % circuit symbols (H-bridge figure)
\setlength{\emergencystretch}{3em}

\usepackage[style=ieee,backend=biber]{biblatex}
\addbibresource{references.bib}
\usepackage[hidelinks]{hyperref}

% Running header: current chapter at the top of every body page.
\usepackage{fancyhdr}
\setlength{\headheight}{15pt}
\fancyhf{}
\fancyhead[L]{\small\nouppercase{\leftmark}}
\fancyfoot[C]{\thepage}
\renewcommand{\headrulewidth}{0.4pt}
\renewcommand{\chaptermark}[1]{\markboth{\chaptername~\thechapter.\ #1}{}}

% Drafting marks. \plan: what a section will contain (blue box). \todo: a fact still
% missing (red). Both must be gone before submission: grep for them.
\newcommand{\plan}[1]{\par\noindent\colorbox{blue!8}{\parbox{\dimexpr\linewidth-2\fboxsep}{%
  \small\textcolor{blue!60!black}{\textbf{Plan:} #1}}}\par\medskip}
\newcommand{\todo}[1]{\textcolor{red!75!black}{\textbf{[TODO: #1]}}}

% Figures are read straight from the CAD output folder, so re-rendered images are
% picked up automatically.
\graphicspath{{../CAD/out/}}

\title{BLOC-BOT}
\author{Wassim Chetioui \and Seif Ali Charad}
\date{\today}

\begin{document}
% Title page from the faculty's 2026 template, built separately with LuaLaTeX because
% its header carries Arabic:  cd titlepage && lualatex titlepage.tex
\includepdf[pages=1]{titlepage/titlepage.pdf}

\pagenumbering{roman}
\include{chapters/front_dedication}
\include{chapters/front_acknowledgements}

\tableofcontents
\listoffigures
\listoftables

\include{chapters/front_abbreviations}

\cleardoublepage
\pagenumbering{arabic}
\pagestyle{fancy}
\include{chapters/general_introduction}

\include{chapters/ch1_generalities}
\include{chapters/ch2_design}
\include{chapters/ch3_realisation}

% Figure library (F01...): not placed yet; figures move into the chapters as they are used.
% \input{figures}

\printbibliography[heading=bibintoc,title={References}]
\end{document}
