seiftotal30-source/BLOC-BOT/BlocBot-Sim/cad/fit_check_plate_bottom.png

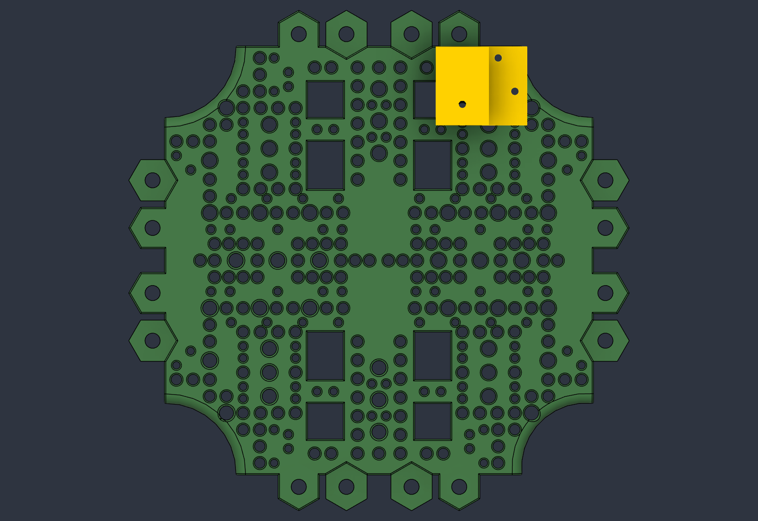
BlocBot-Sim/cad/fit_check_plate_bottom.png
