seiftotal30-source/BLOC-BOT/BlocBot-Sim/cad/preview_rear.png

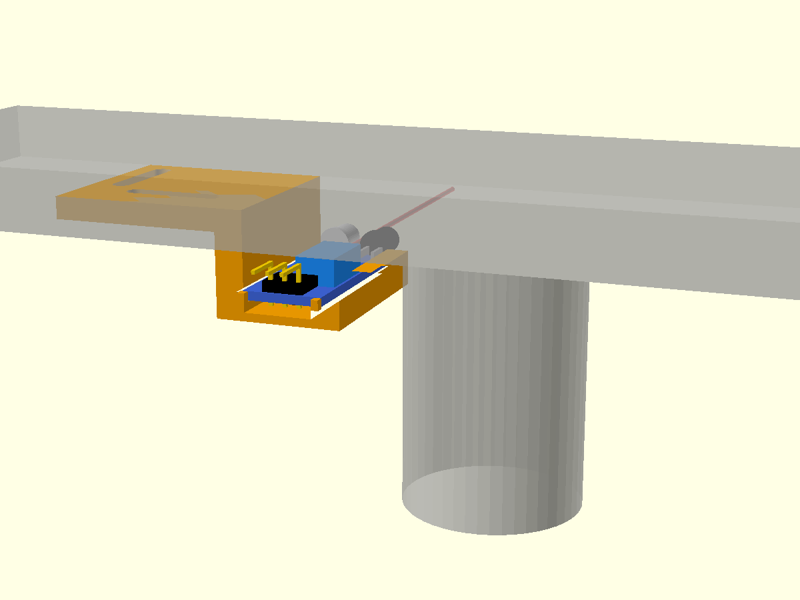
BlocBot-Sim/cad/preview_rear.png
