seiftotal30-source/BLOC-BOT/CAD/controller/2-42-12864-oled-display/2.42 oled.jpg

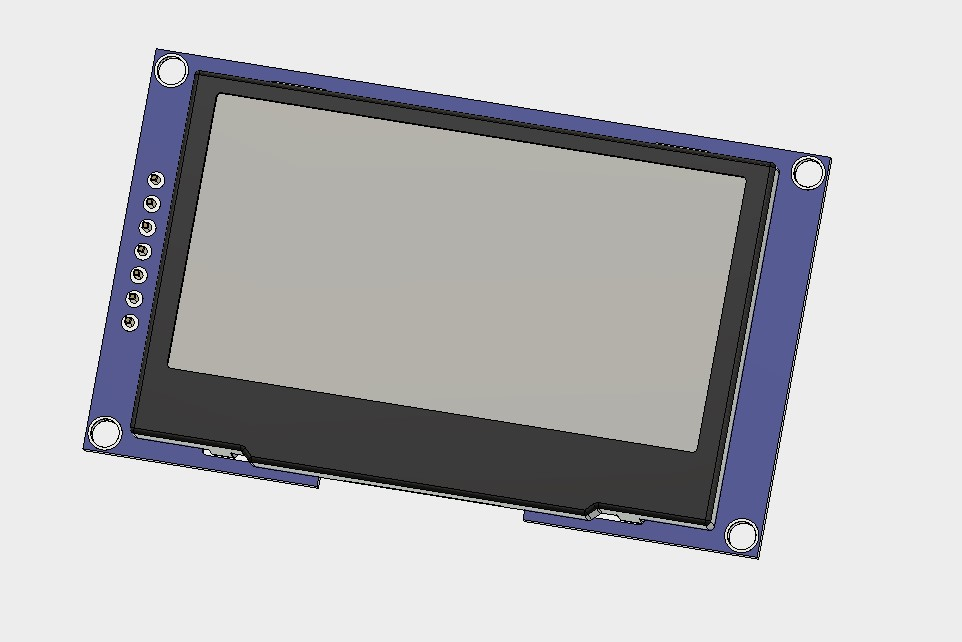
CAD/controller/2-42-12864-oled-display/2.42 oled.jpg
