seiftotal30-source/BLOC-BOT/CAD/controller/remote-controller/Remote Controller Bottom with Arduino Due.png

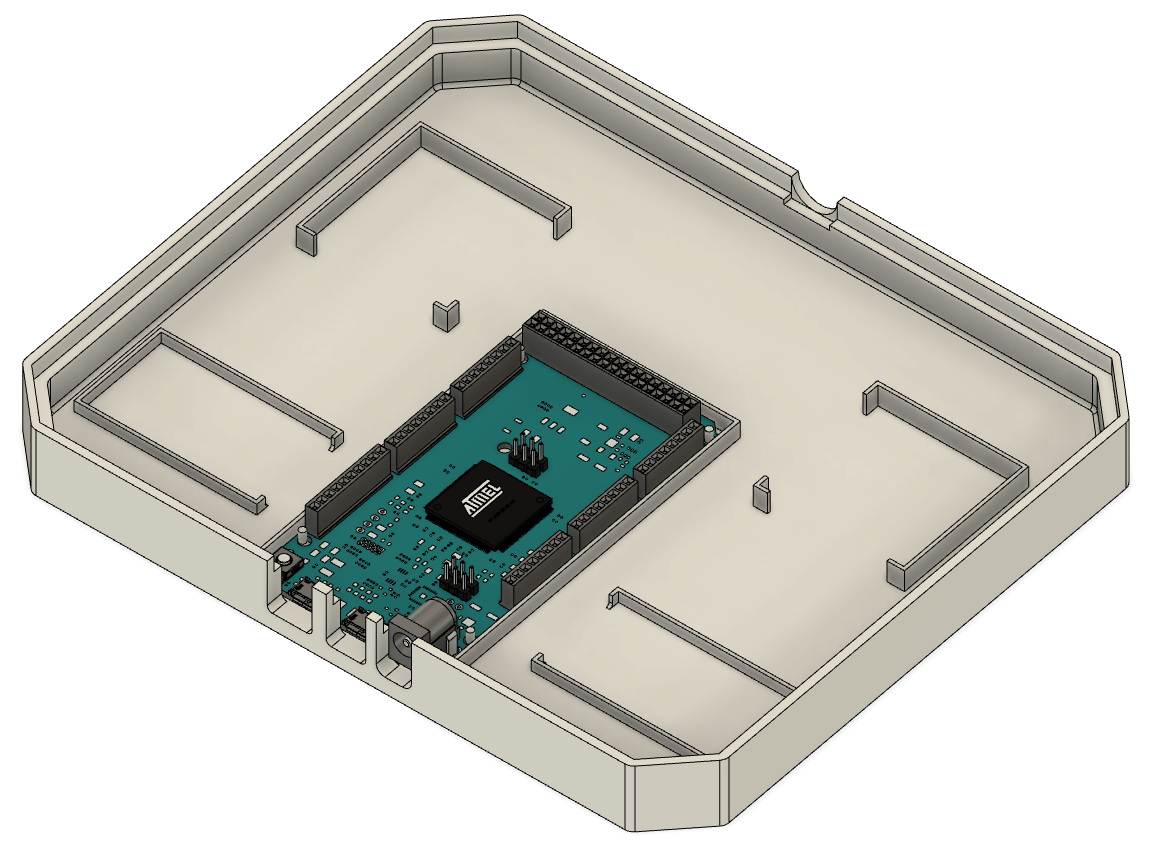
CAD/controller/remote-controller/Remote Controller Bottom with Arduino Due.png
