seiftotal30-source/BLOC-BOT/CAD/controller/remote-controller/Remote Controller Bottom.png

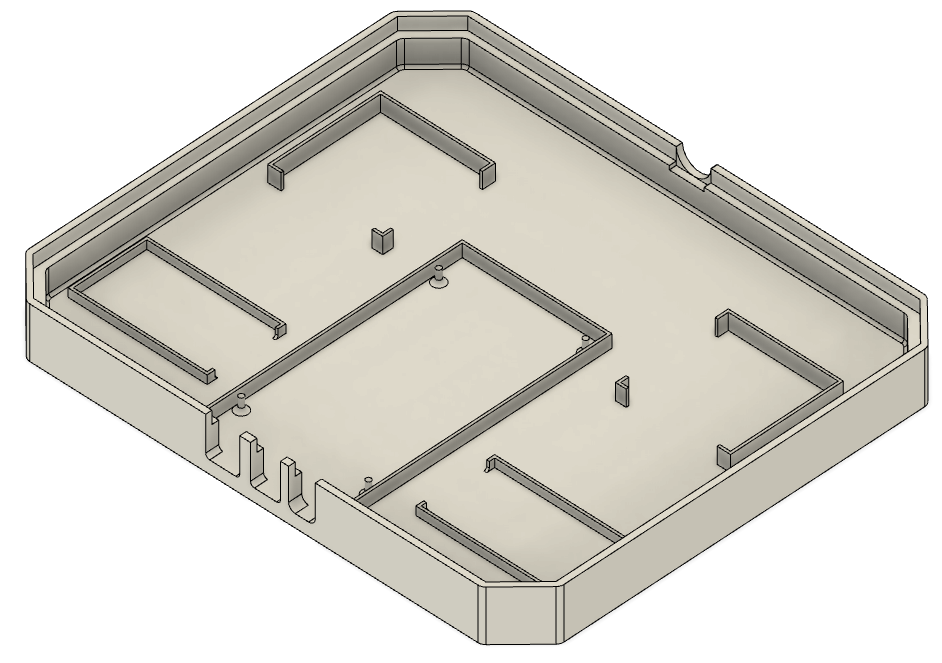
CAD/controller/remote-controller/Remote Controller Bottom.png
