seiftotal30-source/BLOC-BOT/CAD/controller/remote-controller/Remote Controller Top inside.png

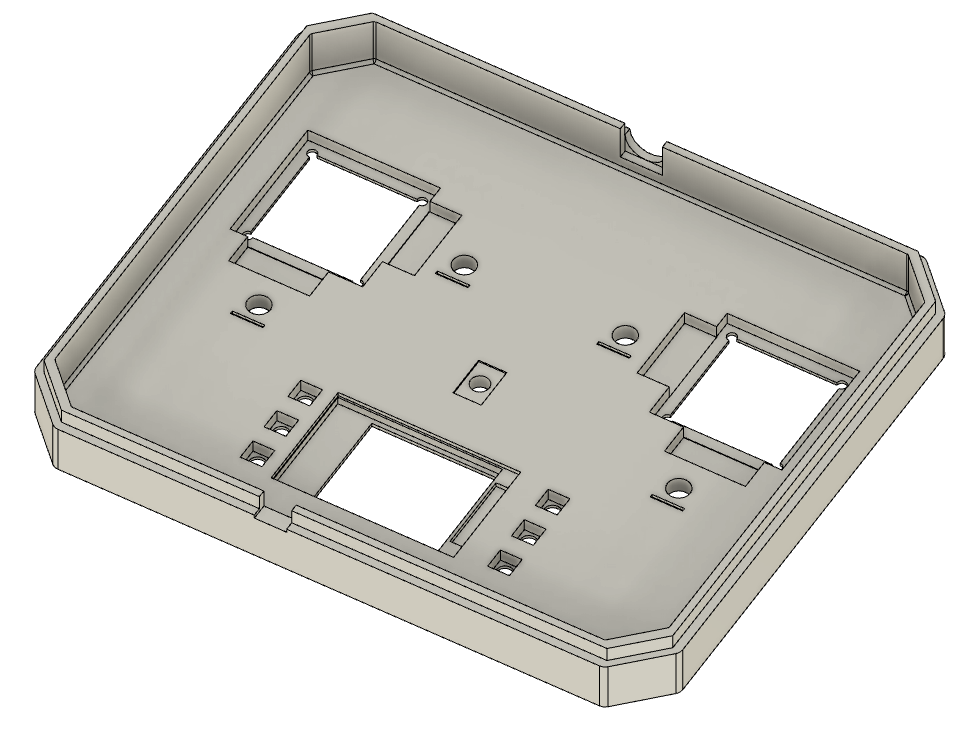
CAD/controller/remote-controller/Remote Controller Top inside.png
