seiftotal30-source/BLOC-BOT/CAD/controller/remote-controller/Remote Controller.png

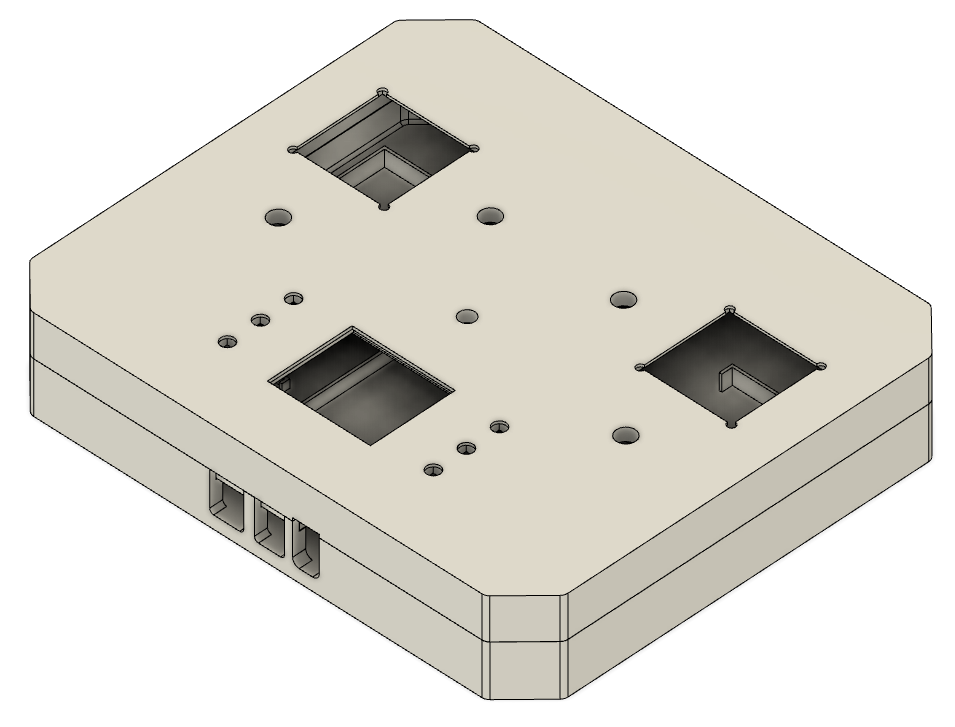
CAD/controller/remote-controller/Remote Controller.png
