seiftotal30-source/BLOC-BOT/CAD/out/angle_bracket_iso_front.png

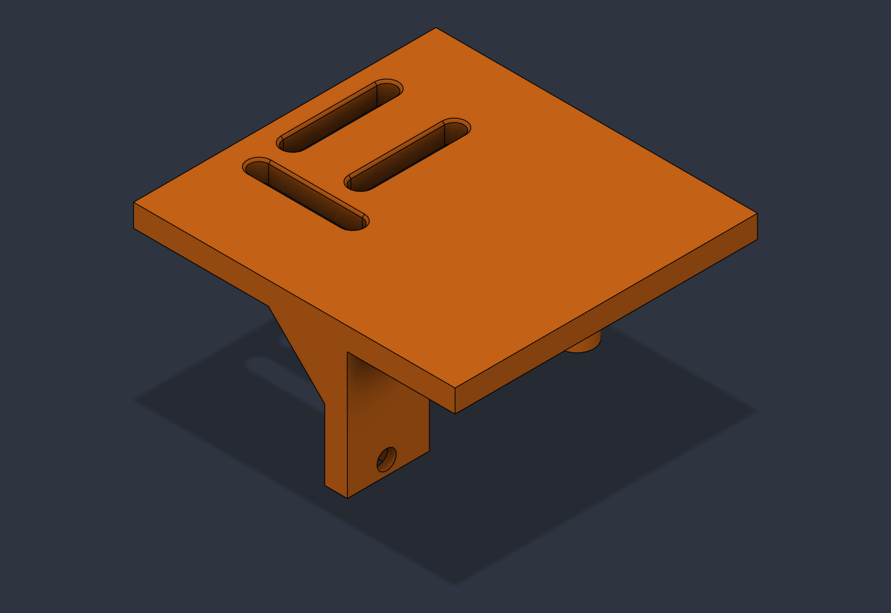
CAD/out/angle_bracket_iso_front.png
