seiftotal30-source/BLOC-BOT/CAD/out/caster/caster_A_part.png

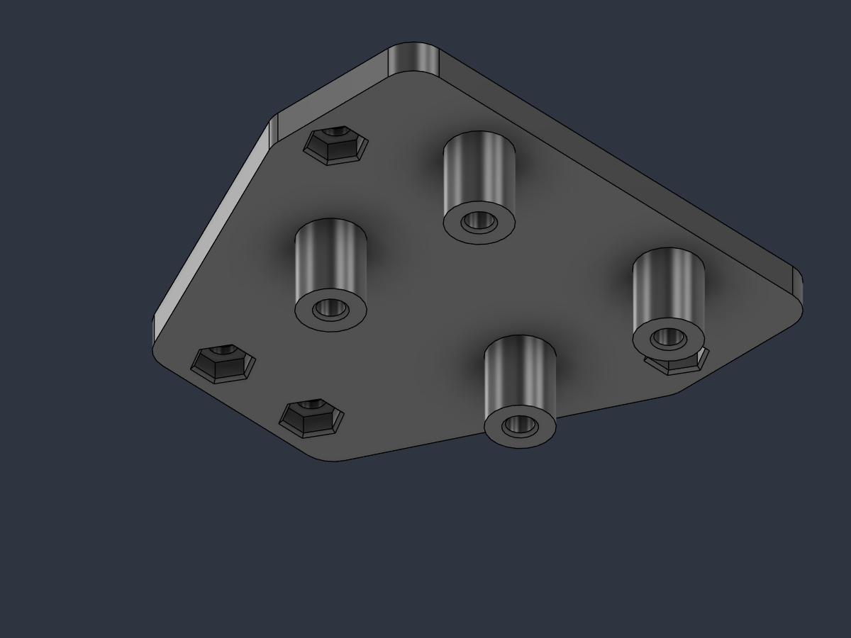
CAD/out/caster/caster_A_part.png
