seiftotal30-source/BLOC-BOT/CAD/out/caster/caster_B_iso.png

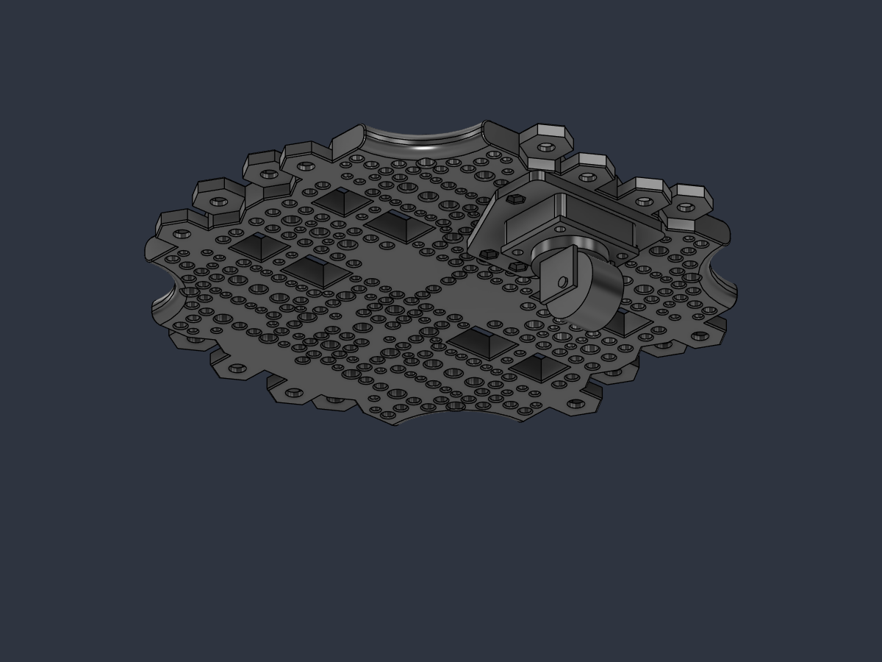
CAD/out/caster/caster_B_iso.png
