seiftotal30-source/BLOC-BOT/CAD/out/caster/caster_B_side.png

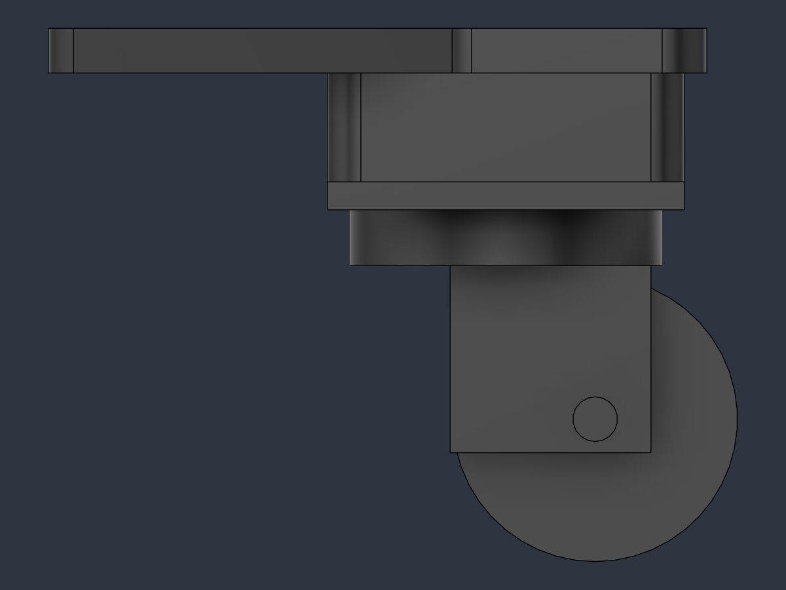
CAD/out/caster/caster_B_side.png
