seiftotal30-source/BLOC-BOT/CAD/out/caster/caster_check_below.png

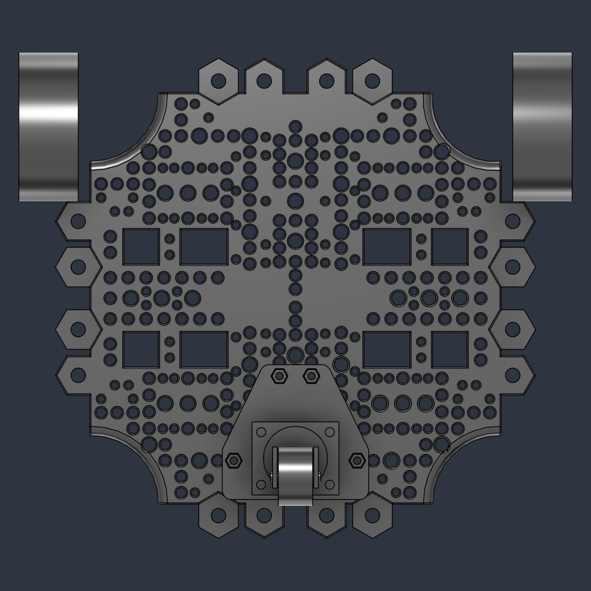
CAD/out/caster/caster_check_below.png
