seiftotal30-source/BLOC-BOT/CAD/out/controller_exploded.png

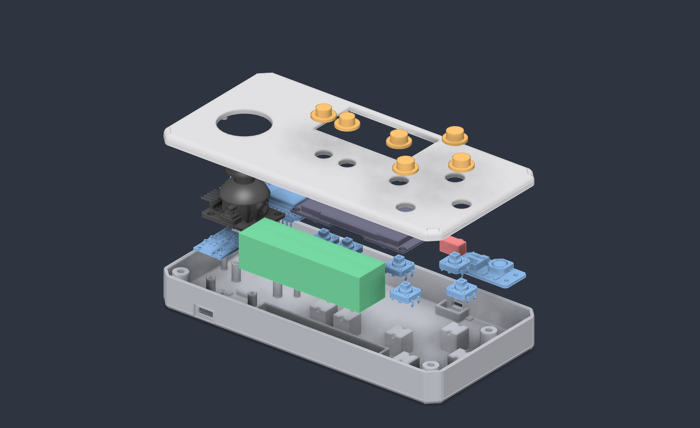
CAD/out/controller_exploded.png
