seiftotal30-source/BLOC-BOT/CAD/out/controller_iso.png

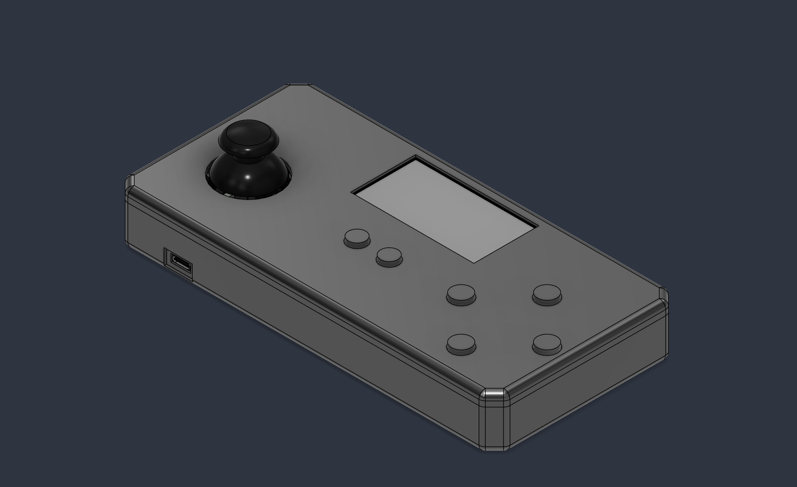
CAD/out/controller_iso.png
