seiftotal30-source/BLOC-BOT/CAD/out/controller_section.png

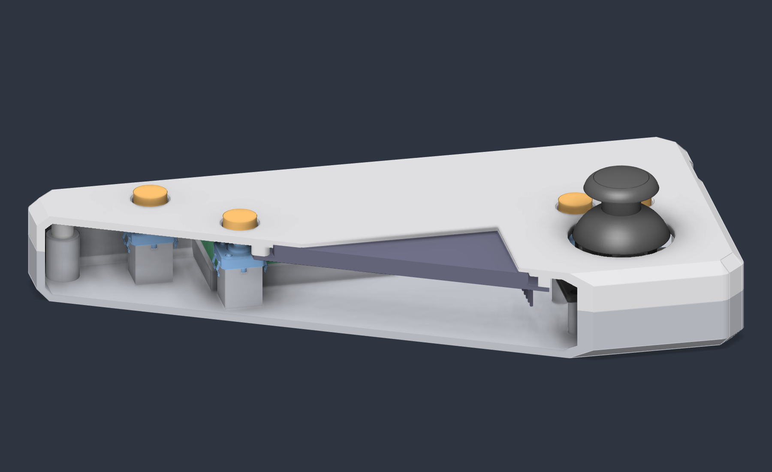
CAD/out/controller_section.png
