seiftotal30-source/BLOC-BOT/CAD/out/controller_top.png

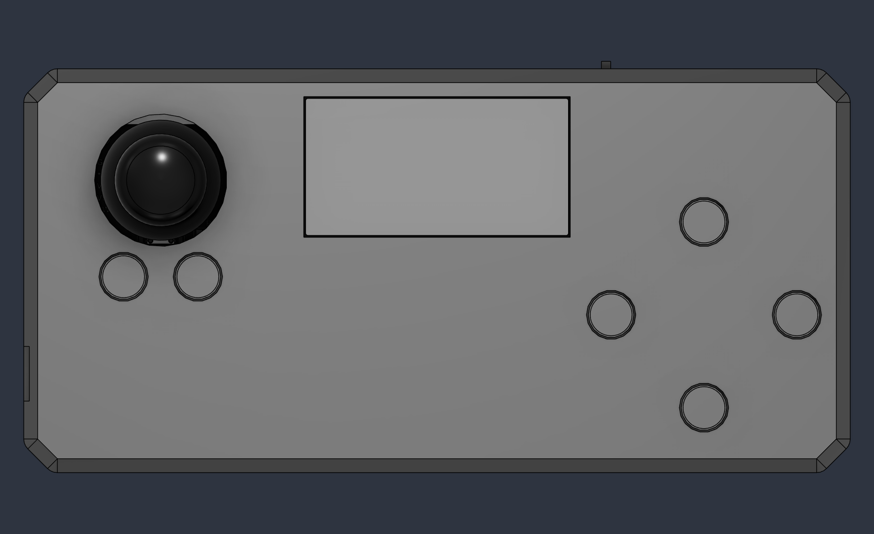
CAD/out/controller_top.png
