seiftotal30-source/BLOC-BOT/CAD/out/shot_iso.png

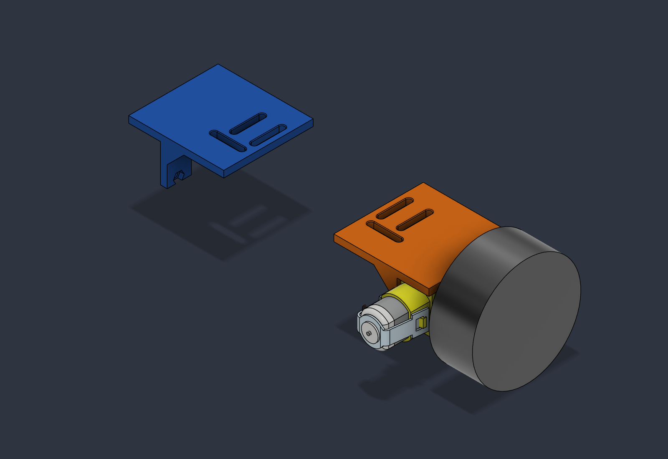
CAD/out/shot_iso.png
