seiftotal30-source/BLOC-BOT/CAD/out/shot_side.png

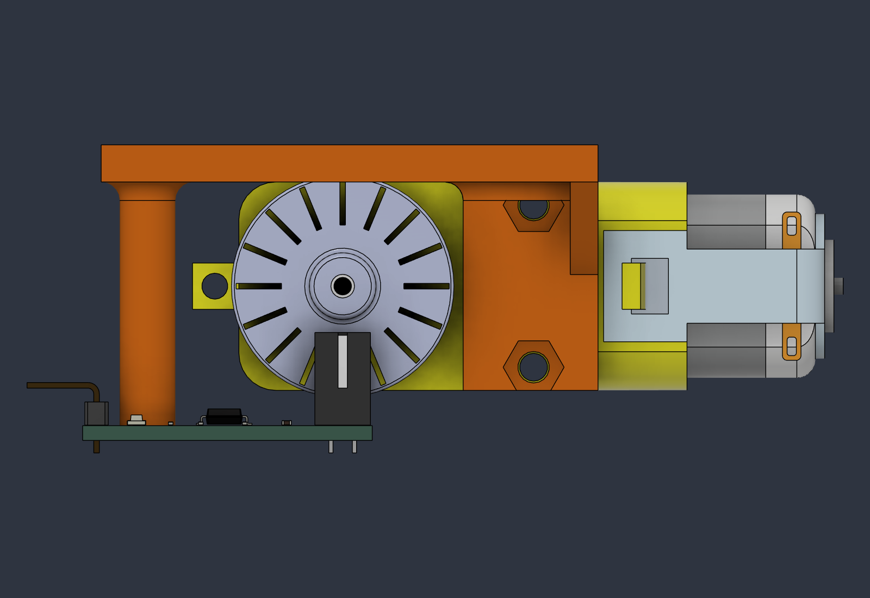
CAD/out/shot_side.png
