seiftotal30-source/BLOC-BOT/CAD/out/shot_top.png

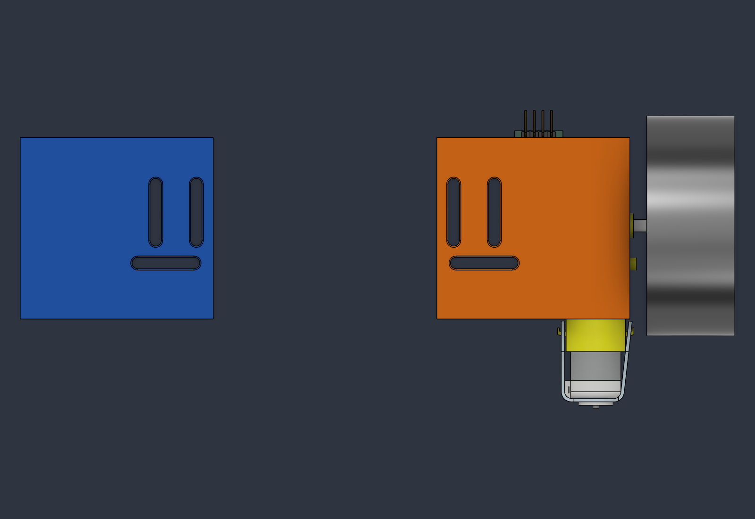
CAD/out/shot_top.png
