seiftotal30-source/BLOC-BOT/CAD/out/shot_with_plate_below.png

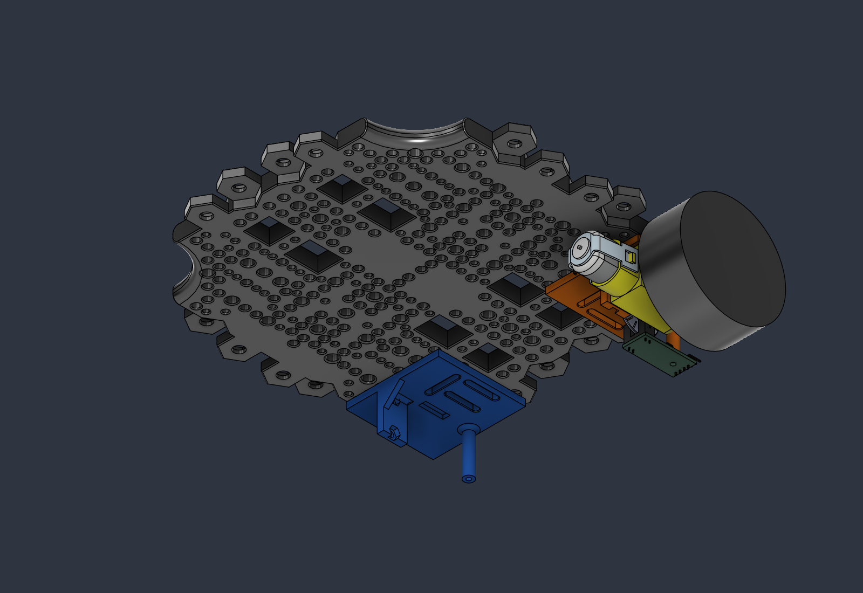
CAD/out/shot_with_plate_below.png
