seiftotal30-source/BLOC-BOT/CAD/out/shot_with_plate_top.png

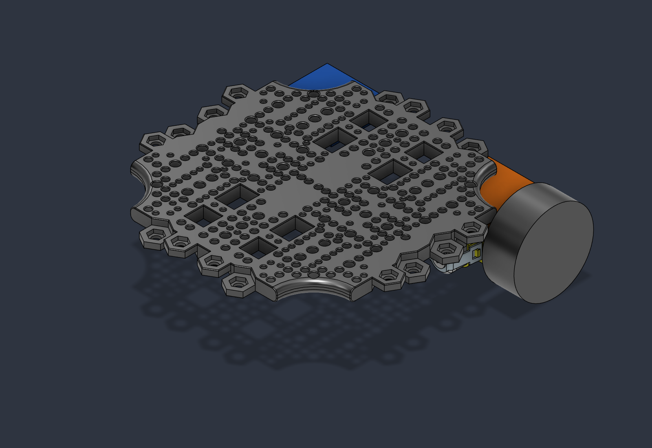
CAD/out/shot_with_plate_top.png
