seiftotal30-source/BLOC-BOT/CAD/pictures/hbloc/hbloc_iso_front_left.png

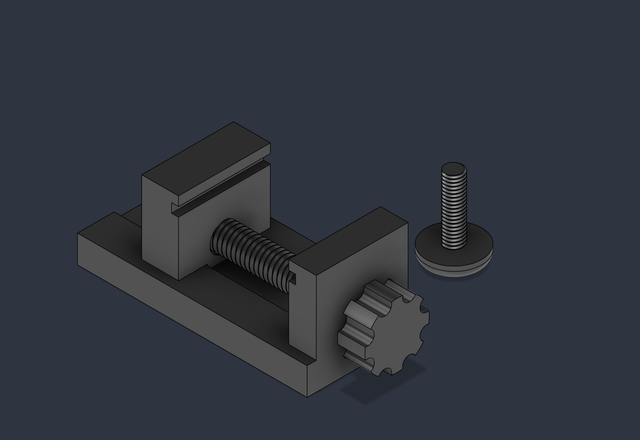
CAD/pictures/hbloc/hbloc_iso_front_left.png
