seiftotal30-source/BLOC-BOT/CAD/pictures/hbloc/hbloc_right.png

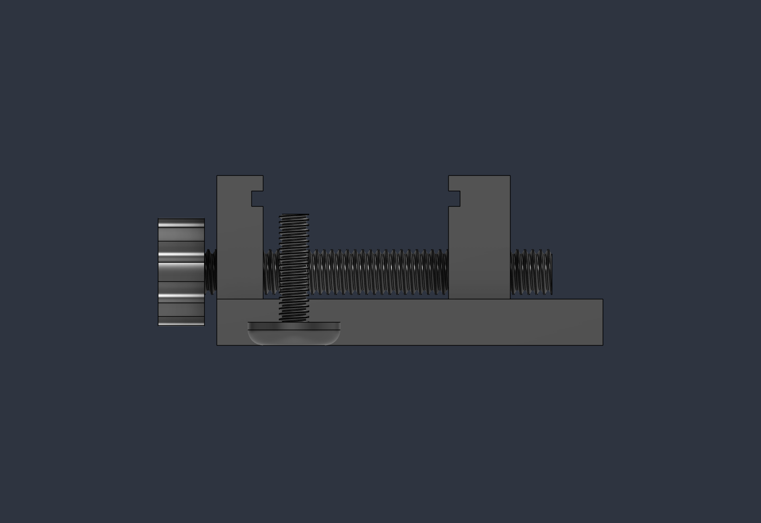
CAD/pictures/hbloc/hbloc_right.png
