seiftotal30-source/BLOC-BOT/CAD/pictures/hbloc/hbloc_top.png

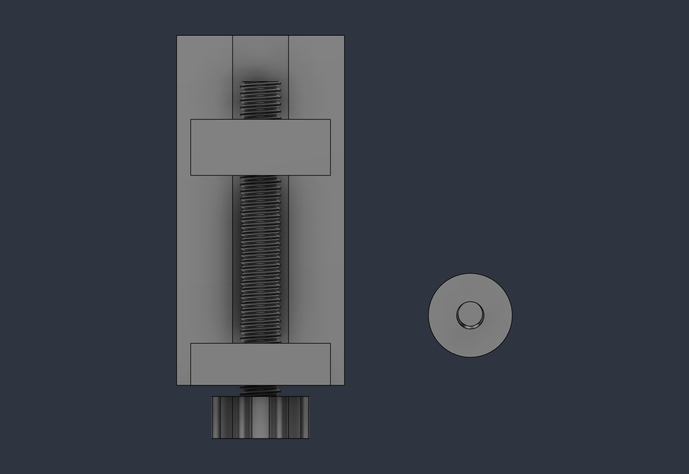
CAD/pictures/hbloc/hbloc_top.png
