seiftotal30-source/BLOC-BOT/CAD/pictures/vbloc/vbloc_iso_front_left.png

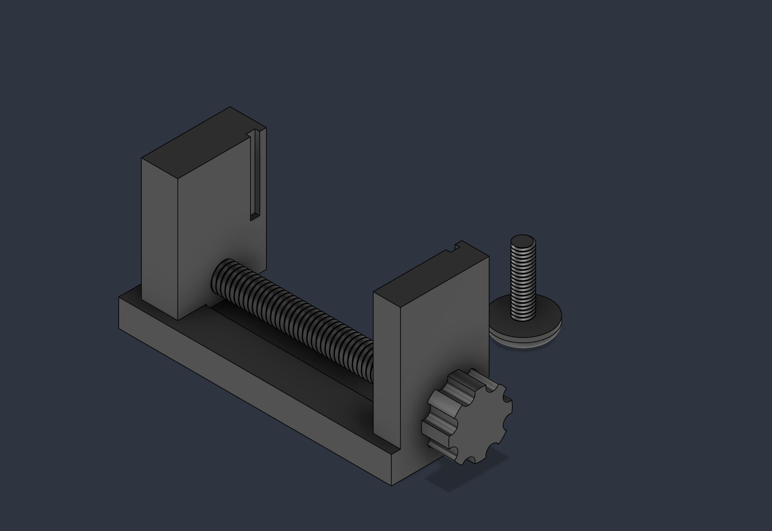
CAD/pictures/vbloc/vbloc_iso_front_left.png
