seiftotal30-source/BLOC-BOT/CAD/pictures/vbloc/vbloc_top.png

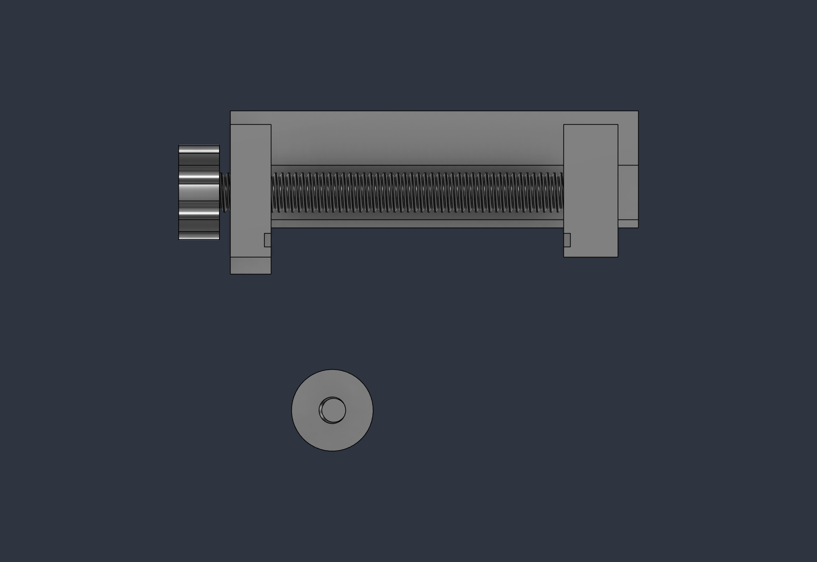
CAD/pictures/vbloc/vbloc_top.png
