seiftotal30-source/BLOC-BOT/CAD/pictures/waffle_plate/waffle_plate_iso_front_left.png

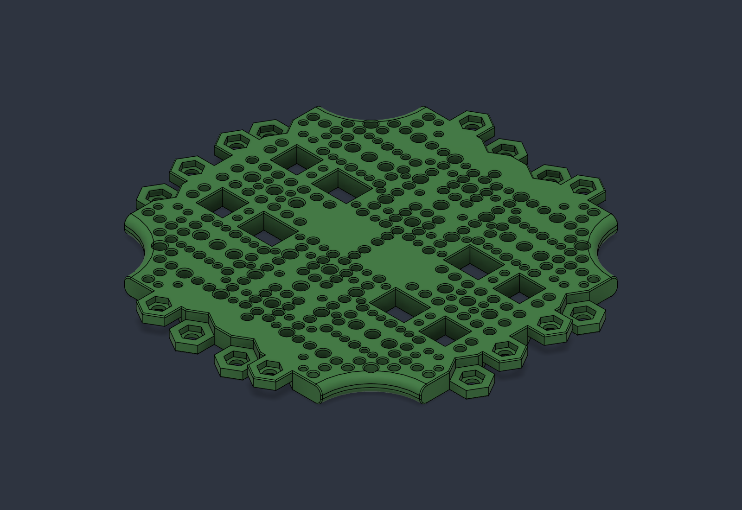
CAD/pictures/waffle_plate/waffle_plate_iso_front_left.png
