seiftotal30-source/BLOC-BOT/CAD/pictures/waffle_plate/waffle_plate_iso_underside.png

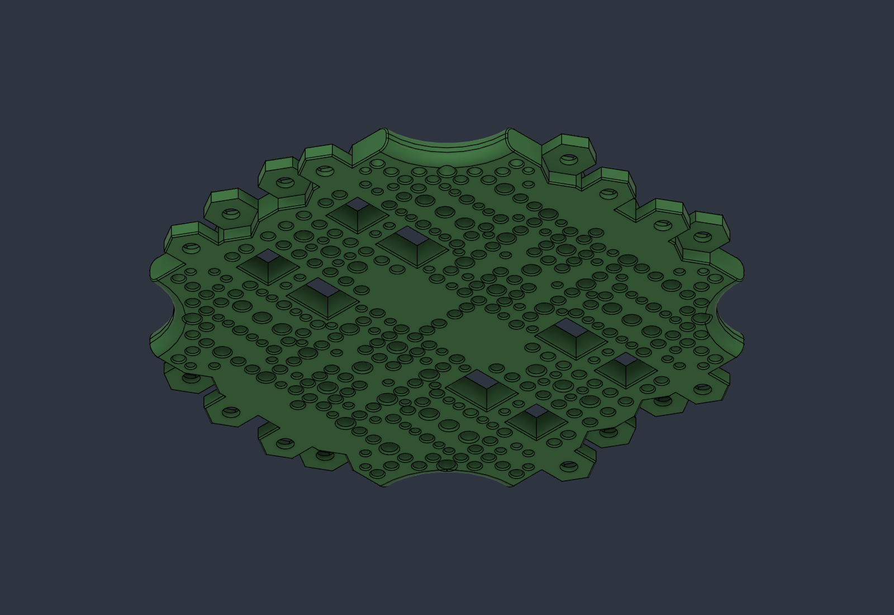
CAD/pictures/waffle_plate/waffle_plate_iso_underside.png
