seiftotal30-source/BLOC-BOT/CAD/ref/speed-sensor-mh-sensor-series-1.snapshot.6/20240805_210224.jpg

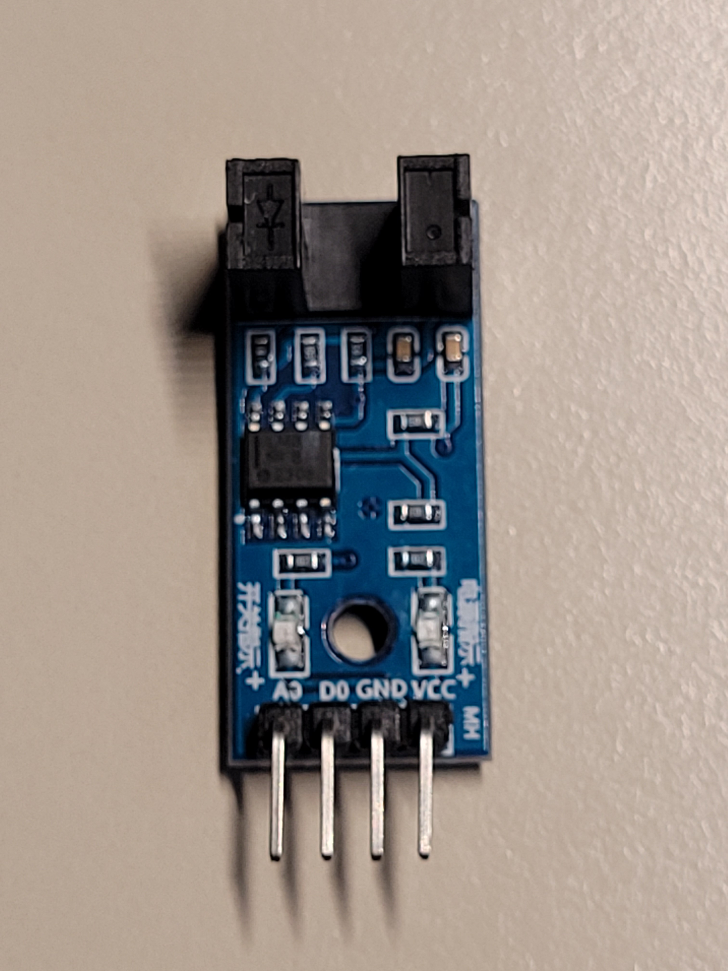
CAD/ref/speed-sensor-mh-sensor-series-1.snapshot.6/20240805_210224.jpg
