seiftotal30-source/BLOC-BOT/CAD/scad/view_controller.png

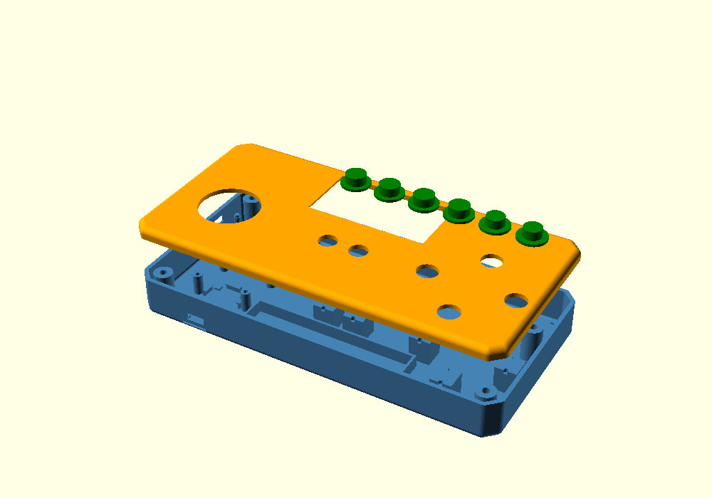
CAD/scad/view_controller.png
