seiftotal30-source/BLOC-BOT/circuits/drv8833_motor_circuit.png

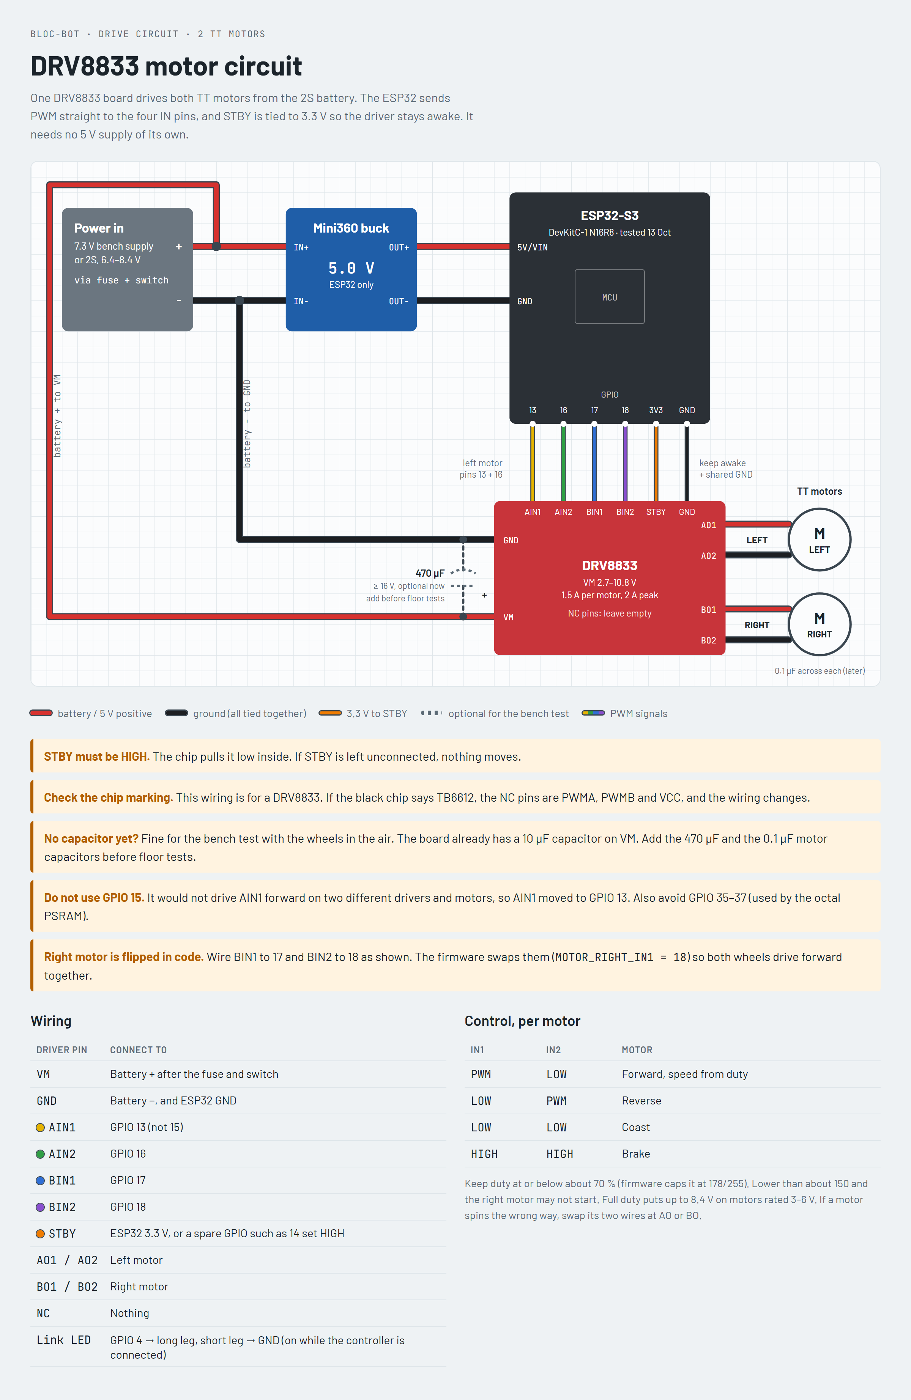
circuits/drv8833_motor_circuit.png
