seiftotal30-source/BLOC-BOT/thesis/results/bom_cost/paid_prices.csv

component | used_in | unit_price_da | qty | source | note
ESP32-S3 DevKitC-1 N16R8 | robot MCU | 2000 | 1 | paid (Wassim 2026-10-21)
ESP32 DevKit | controller MCU | 1600 | 1 | paid (Wassim 2026-10-21)
TT gearmotor | robot drive | 550 | 2 | paid (Wassim 2026-10-21)
Wheel | robot drive | 250 | 2 | paid (Wassim 2026-10-21) | diameter to measure (65 mm assumed in code)
DRV8833 module | robot motor driver | 500 | 1 | paid (Wassim 2026-10-21)
Mini360 buck converter | robot 5 V | 400 | 1 | paid (Wassim 2026-10-21)
HC-SR04 | robot distance (front) | 600 | 1 | paid (Wassim 2026-10-21)
KY-023 joystick | controller | 500 | 1 | paid (Wassim 2026-10-21)
Push button | controller | 50 | 4 | paid (Wassim 2026-10-21) | qty 4 from the wiring diagram
Flying Fish IR sensor | planned self-parking | 500 | 1 | paid (Wassim 2026-10-21) | bought; feature not built
TCRT5000 5-channel line sensor | line following (in progress) | 800 | 1 | paid (Wassim 2026-10-21)
18650 cell (METAMA 2500 mAh) | robot power | 1000 | 2 | paid (Wassim 2026-10-25)
18650 cell (QHTC 2000 mAh) | controller power | 250 | 1 | paid (Wassim 2026-10-25)
18650 holder 2x | robot power | 400 | 1 | paid (Wassim 2026-10-21)
18650 holder 1x | controller power | 200 | 1 | paid (Wassim 2026-10-21)
Li-ion charger (2 slots) | charging the robot cells | 3000 | 1 | paid (Wassim 2026-10-21)
LM393 slotted speed sensor | robot wheel speed (2 fitted) | 500 | 4 | paid (Seif 2026-10-24) | 4 bought
MPU6050 module | robot IMU | 600 | 1 | paid (Seif 2026-10-25)
TP4056 USB-C module with protection | controller charging | 200 | 1 | paid (Wassim 2026-10-25) | not bought from Esp32Lab; looks identical to their listing
Caster wheel | robot | 300 | 1 | paid (Wassim 2026-10-25)
OLED 0.96in SSD1306 | controller display | 800 | 1 | paid (Wassim 2026-10-25) | found too small; a larger one may replace it
Power switch | controller | 50-200 | 1 | paid (Wassim 2026-10-25) | exact price not remembered
MT3608 boost converter | controller 5 V | TBD | 1 | TBD | price not given yet
