seiftotal30-source/BLOC-BOT/tools and components irl/components/controller_cell_QHTC_2000mAh.webp

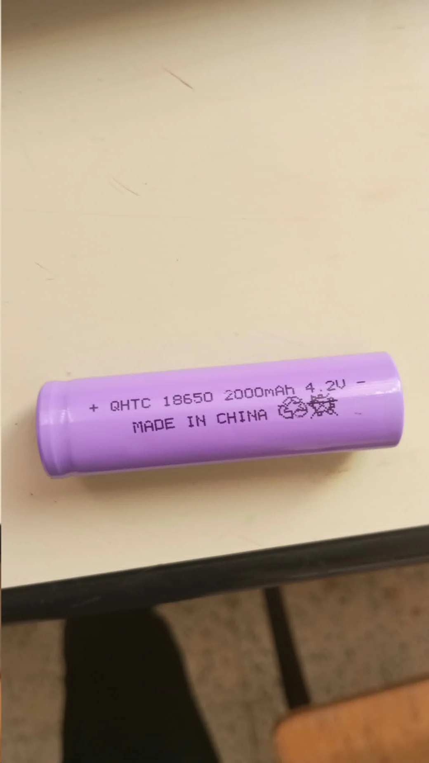
tools and components irl/components/controller_cell_QHTC_2000mAh.webp
