seiftotal30-source/BLOC-BOT/tools and components irl/components/controller_esp32_board.jpg

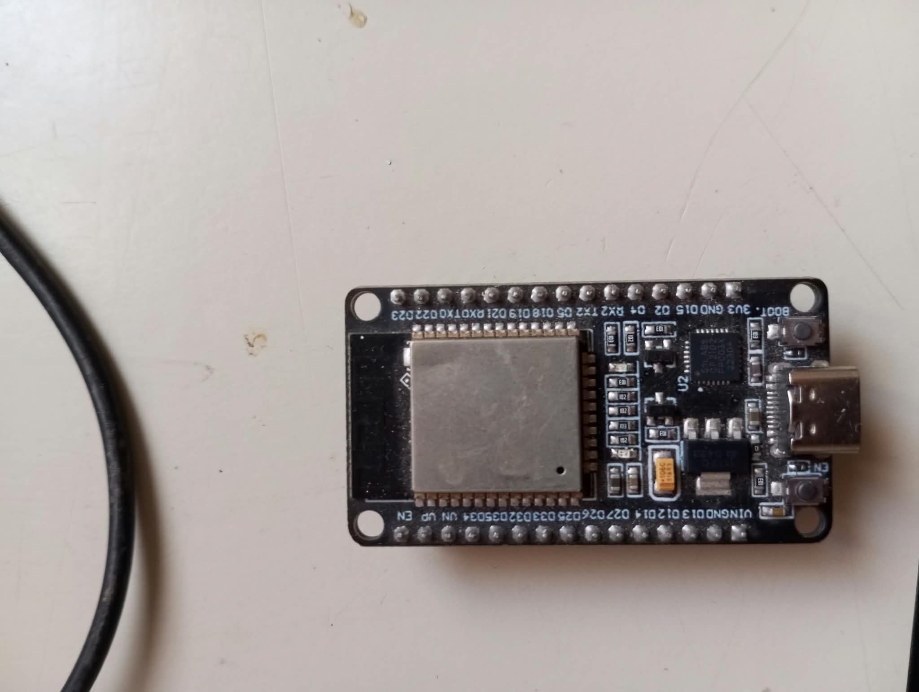
tools and components irl/components/controller_esp32_board.jpg
