seiftotal30-source/BLOC-BOT/tools and components irl/components/drv8833_module_back.webp

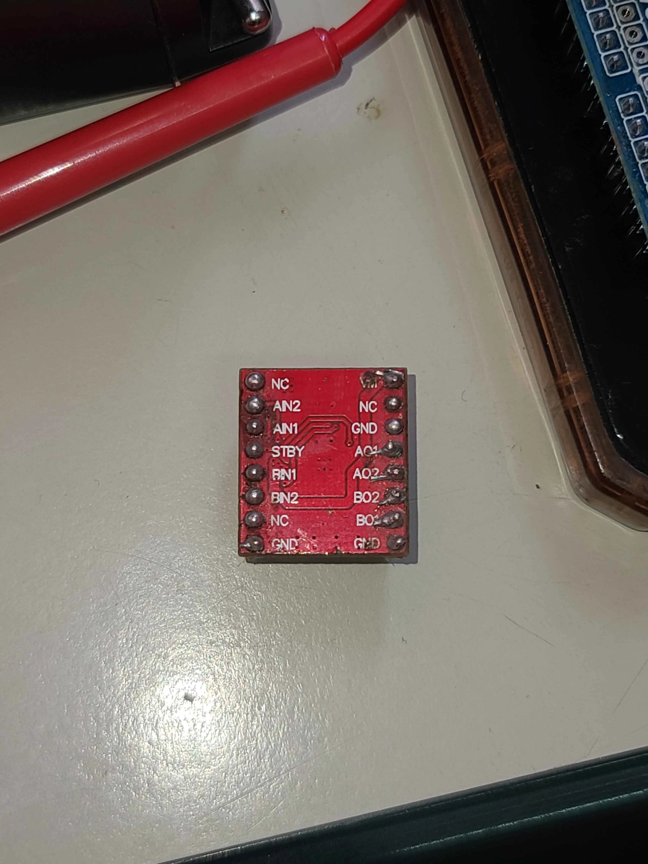
tools and components irl/components/drv8833_module_back.webp
