seiftotal30-source/BLOC-BOT/tools and components irl/components/drv8871-back-pin-labels.jpg

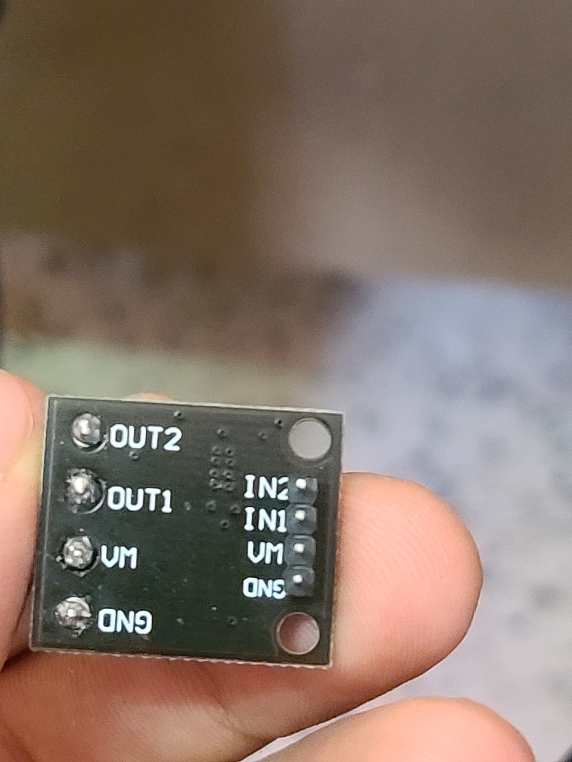
tools and components irl/components/drv8871-back-pin-labels.jpg
