seiftotal30-source/BLOC-BOT/tools and components irl/components/drv8871-front.jpg

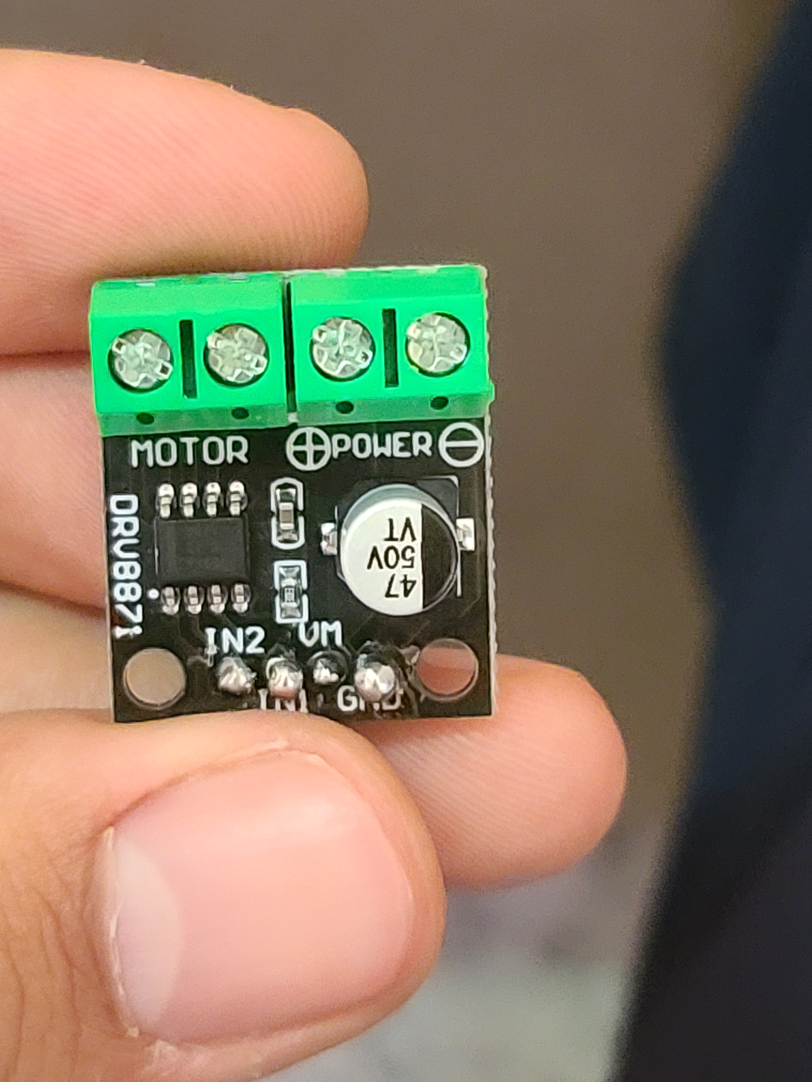
tools and components irl/components/drv8871-front.jpg
