seiftotal30-source/BLOC-BOT/tools and components irl/components/esp32-s3-n16r8-devkit.jpg

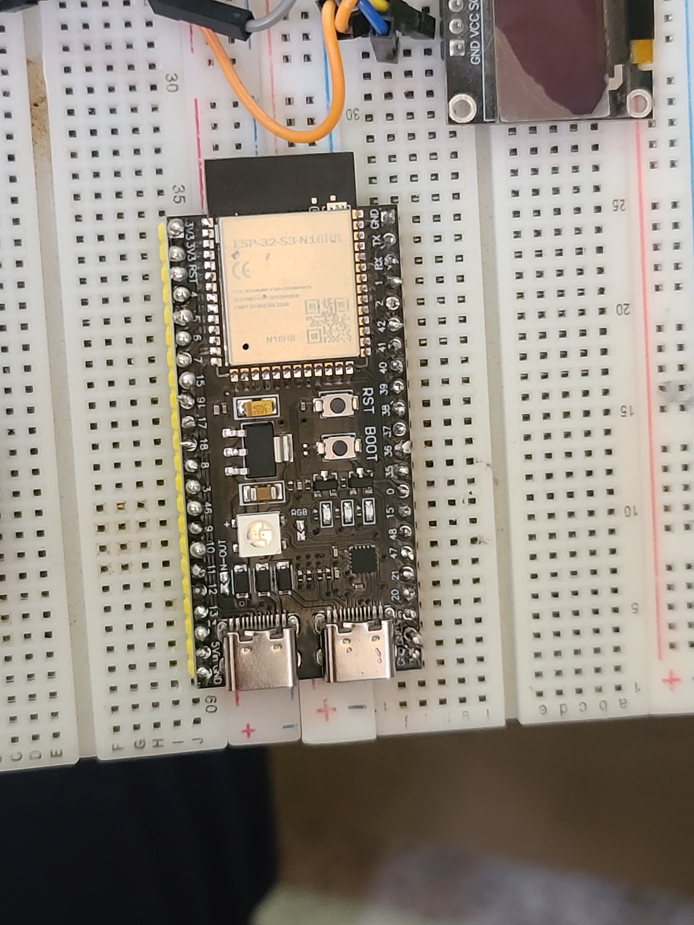
tools and components irl/components/esp32-s3-n16r8-devkit.jpg
