seiftotal30-source/BLOC-BOT/tools and components irl/components/robot_esp32s3_board.jpg

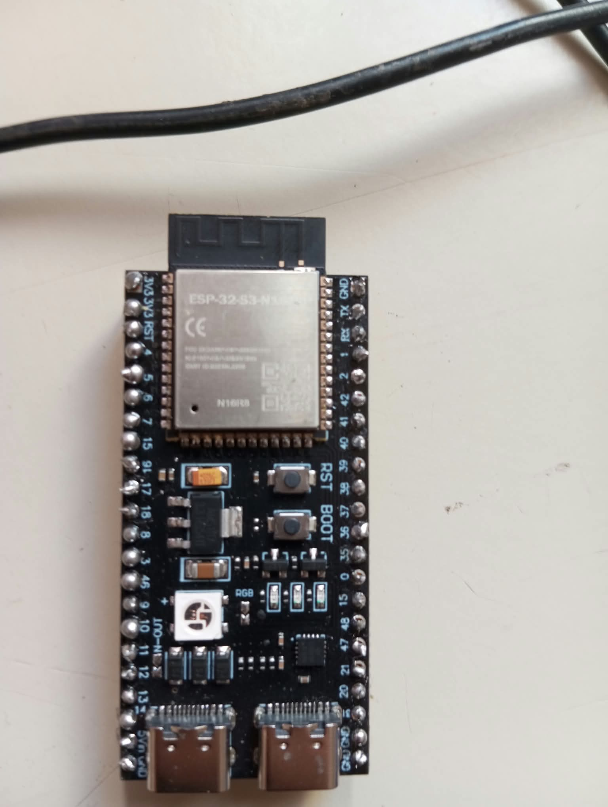
tools and components irl/components/robot_esp32s3_board.jpg
