seiftotal30-source/BLOC-BOT/tools and components irl/tools/oscilloscope-ch1-menu.jpg

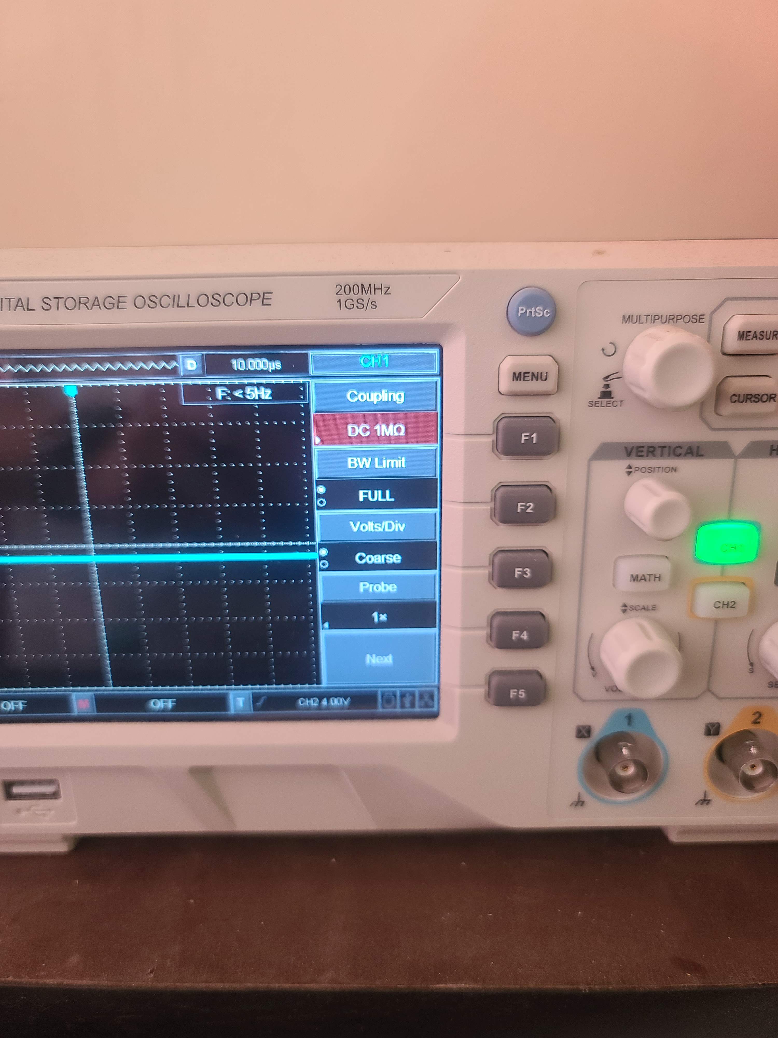
tools and components irl/tools/oscilloscope-ch1-menu.jpg
