seiftotal30-source/BLOC-BOT/CAD/3mf/HBloc_assembled.3mf

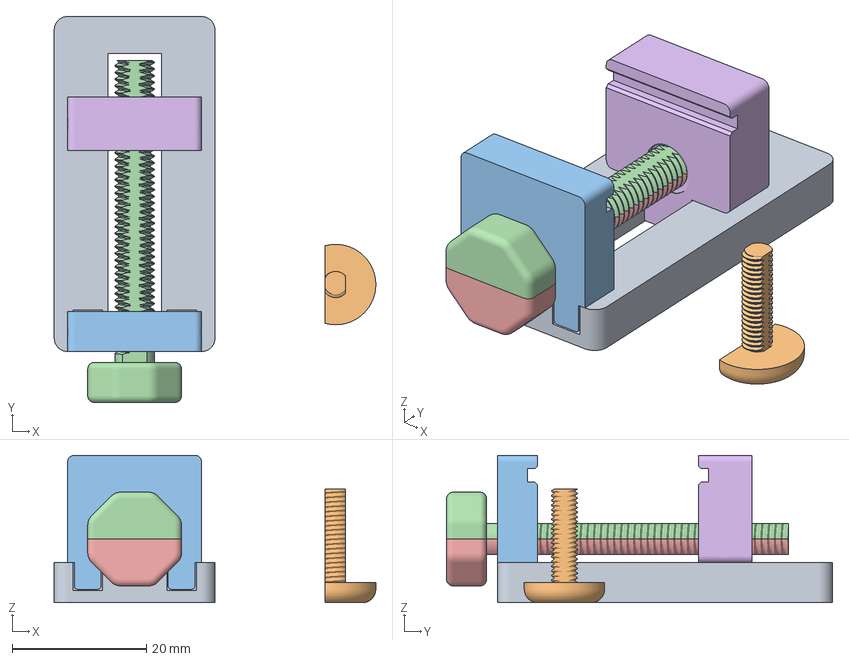
[picture p50: CAD file, 2026-10-25]
CAD/3mf/HBloc_assembled.3mf
48.0 x 57.6 x 22.0 mm
Bloc_Base
Bloc_Cap (1) (1)
Bloc_FixedJaw
Bloc_LeadScrewBottom (1)
Bloc_LeadScrewBottom
Bloc_SlidingJaw
