seiftotal30-source/BLOC-BOT/BlocBot-Sim/cad/flyingfish_mount.stl

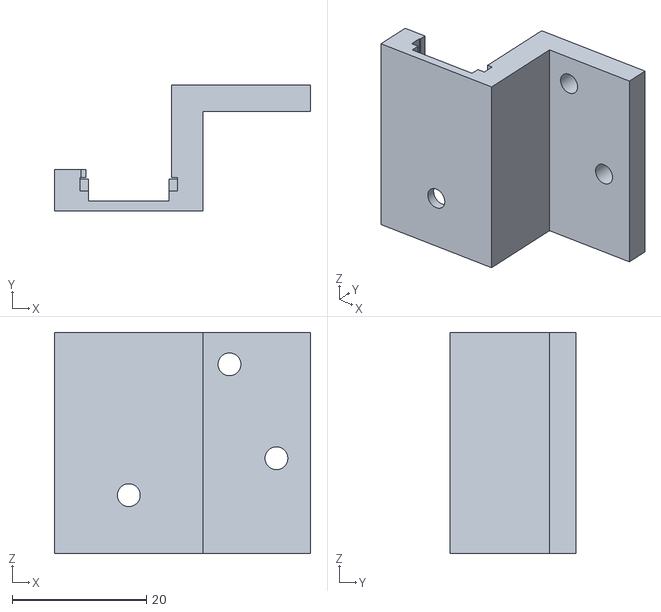
[picture p51: CAD file, 2026-10-06]
BlocBot-Sim/cad/flyingfish_mount.stl
38.2 x 18.9 x 33.0
