seiftotal30-source/BLOC-BOT/CAD/3mf/from_professional/Bracket.3mf

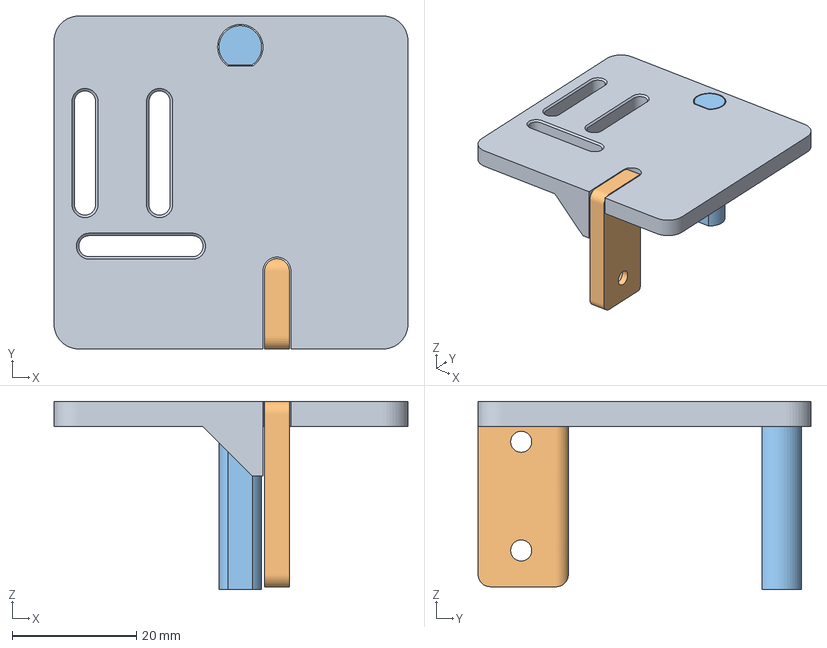
[picture p52: CAD file, 2026-10-12]
CAD/3mf/from_professional/Bracket.3mf
57.0 x 53.6 x 30.3 mm
Bracket_R (1) (1)
Bracket_R (1) (5)
Bracket_R
