seiftotal30-source/BLOC-BOT/CAD/3mf/HBloc_L.3mf

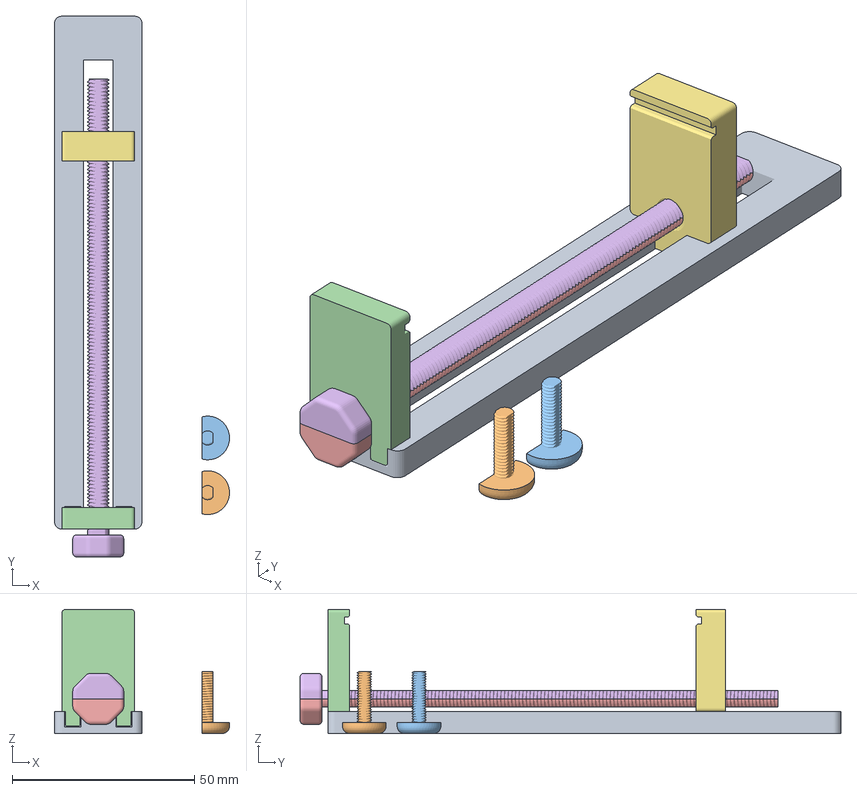
[picture p53: CAD file, 2026-10-25]
CAD/3mf/HBloc_L.3mf
48.0 x 148.3 x 34.0 mm
HBlocL_Base
HBlocL_Cap_1
HBlocL_Cap_2
HBlocL_FixedJaw
HBlocL_LeadScrew_A
HBlocL_LeadScrew_B
HBlocL_SlidingJaw
