seiftotal30-source/BLOC-BOT/CAD/controller/2-42-12864-oled-display/OLED 2.42 12864 v7.step

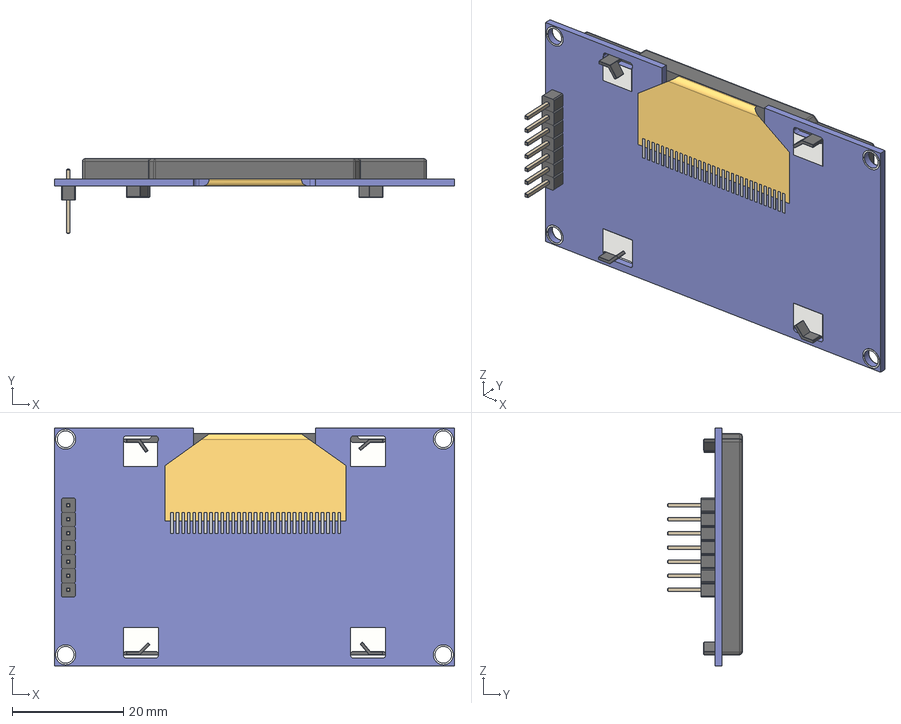
[picture p54: CAD file, 2026-10-05]
CAD/controller/2-42-12864-oled-display/OLED 2.42 12864 v7.step
72.0 x 13.4 x 42.8 mm
screen
cable
PLS-7 v2
