seiftotal30-source/BLOC-BOT/CAD/controller/esp32-devkit-v1/ESP32-devkit_v1.step

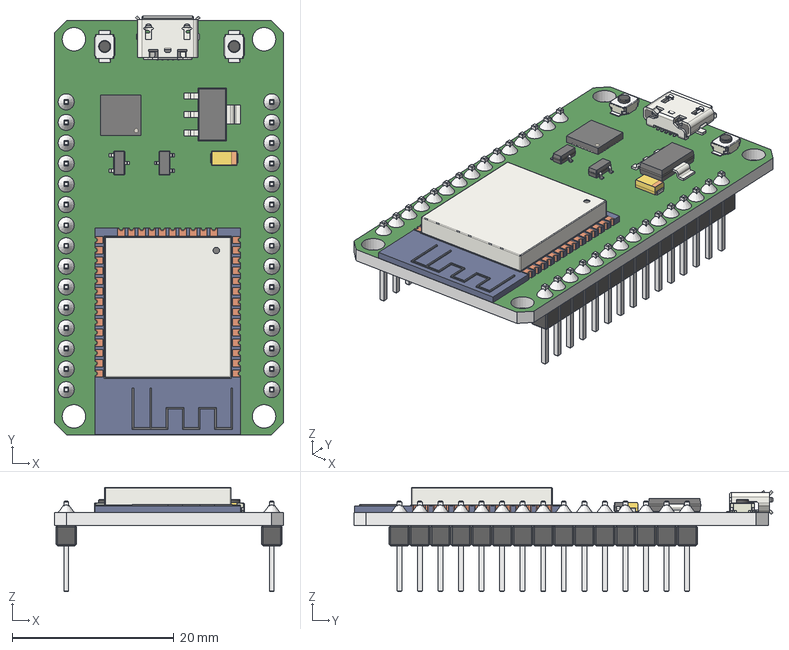
[picture p55: CAD file, 2026-10-05]
CAD/controller/esp32-devkit-v1/ESP32-devkit_v1.step
28.3 x 51.8 x 12.9 mm
Печатная плата
ESP32-WROOM-32
USB_Micro-B_Molex_47346-0001
AMS-1117
cp2102
SOT_23-1
SOT_23-2
SW_SPST_B3U-1000P-1
SW_SPST_B3U-1000P-2
CP_EIA_3216_10_Kemet_I
