seiftotal30-source/BLOC-BOT/CAD/out/caster/caster_support_B.stl

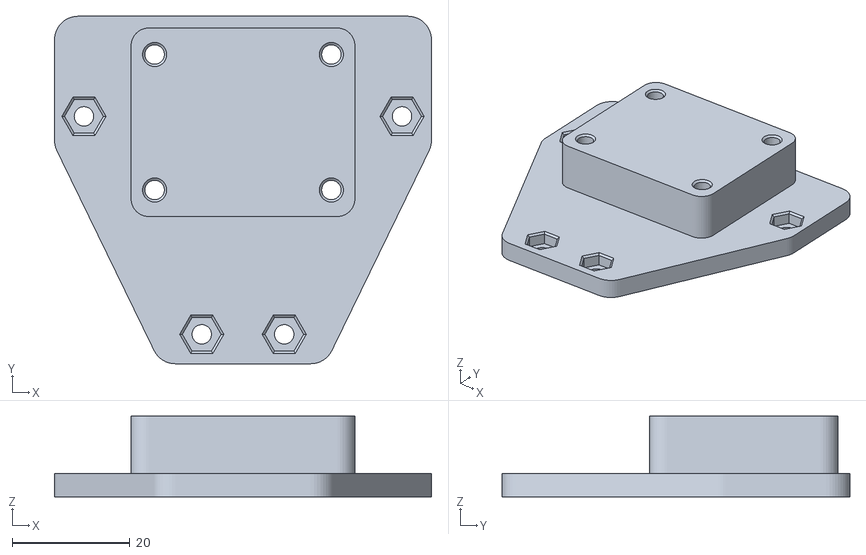
[picture p56: CAD file, 2026-10-15]
CAD/out/caster/caster_support_B.stl
64.0 x 59.0 x 13.8
