seiftotal30-source/BLOC-BOT/CAD/out/controller_caps.stl

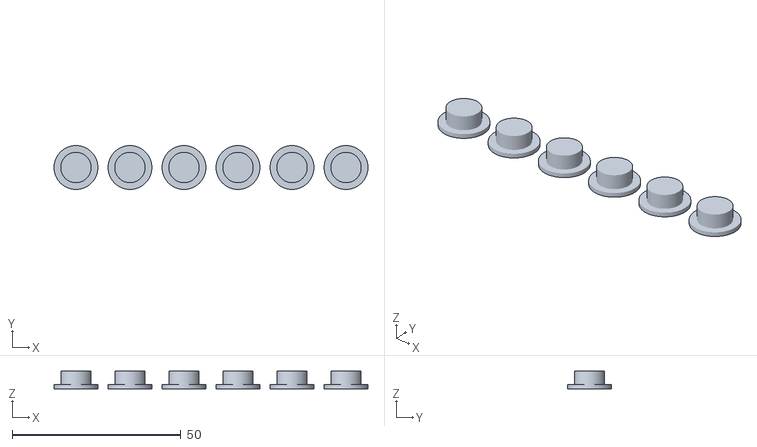
[picture p57: CAD file, 2026-10-15]
CAD/out/controller_caps.stl
93.0 x 13.0 x 5.20
