seiftotal30-source/BLOC-BOT/CAD/out/hbloc/hbloc_slidingjaw.stl

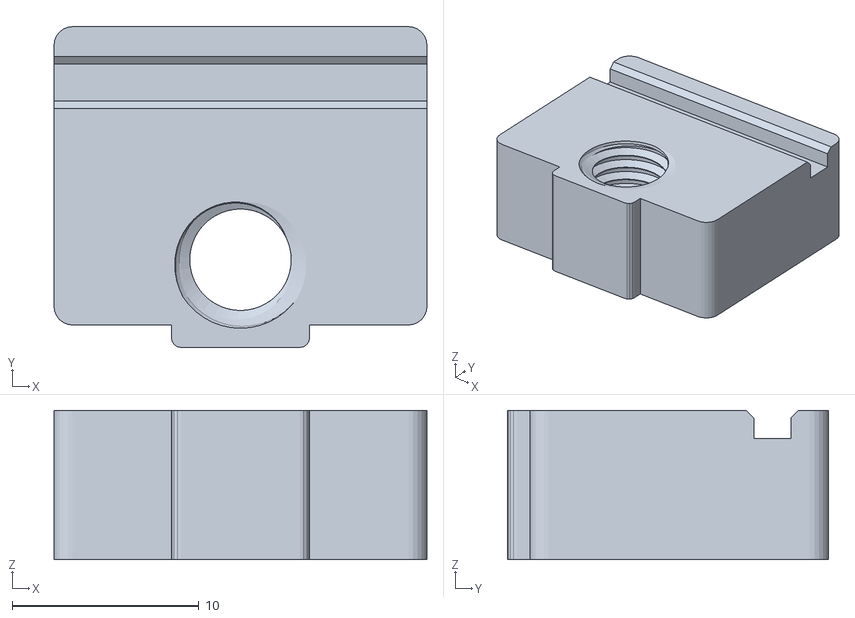
[picture p58: CAD file, 2026-10-14]
CAD/out/hbloc/hbloc_slidingjaw.stl
20.0 x 17.2 x 8.00
