seiftotal30-source/BLOC-BOT/CAD/out/vbloc/vbloc_slidingjaw.stl

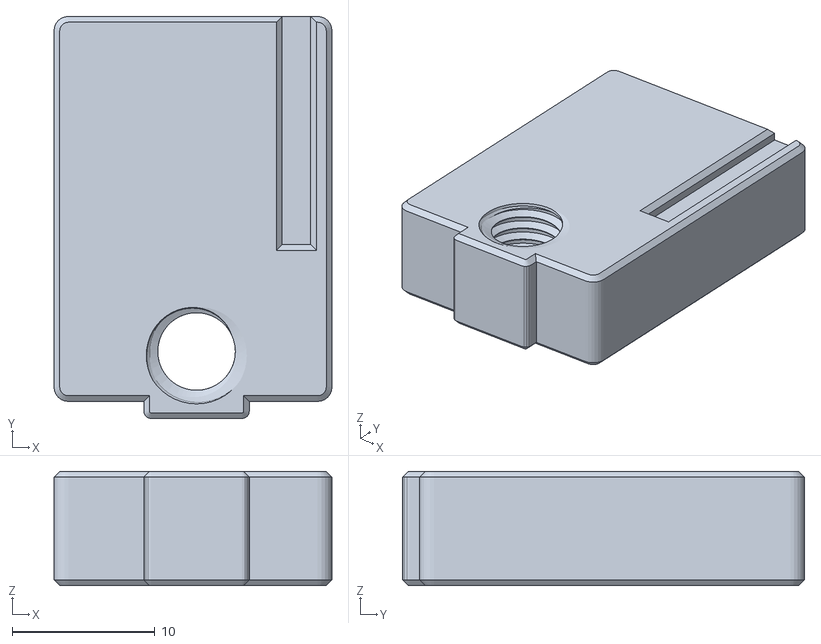
[picture p59: CAD file, 2026-10-14]
CAD/out/vbloc/vbloc_slidingjaw.stl
19.5 x 28.2 x 8.00
