seiftotal30-source/BLOC-BOT/CAD/ref/speed-sensor-mh-sensor-series-1.snapshot.6/roue_codeuse_16_v4.STEP

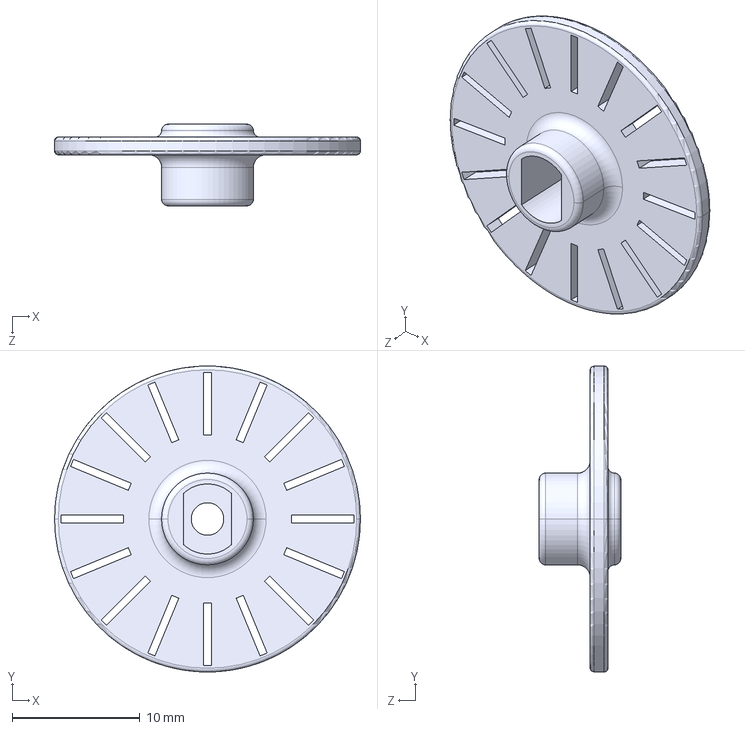
[picture p60: CAD file, 2026-10-05]
CAD/ref/speed-sensor-mh-sensor-series-1.snapshot.6/roue_codeuse_16_v4.STEP
24.0 x 24.0 x 6.40 mm
