seiftotal30-source/BLOC-BOT/CAD/out/caster/caster_support_A.stl

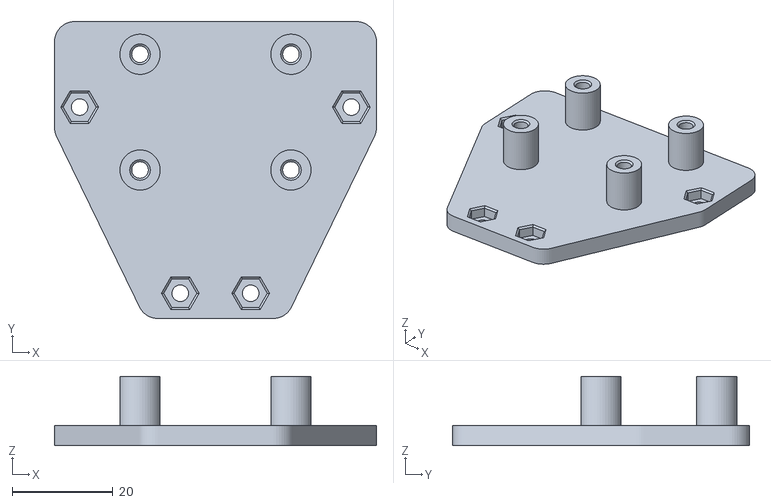
[picture p61: CAD file, 2026-10-15]
CAD/out/caster/caster_support_A.stl
64.0 x 59.0 x 13.8
