seiftotal30-source/BLOC-BOT/CAD/out/controller_top.stl

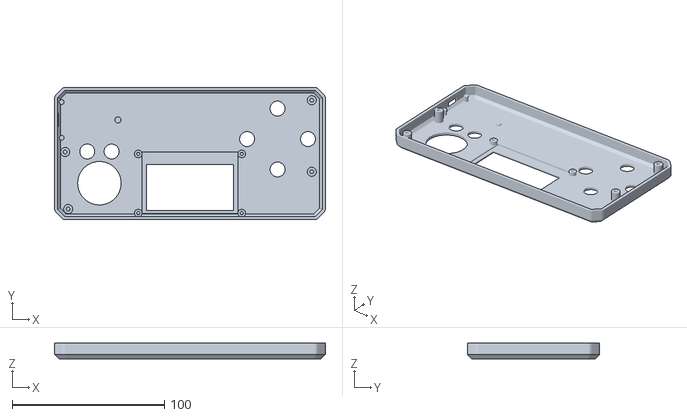
[picture p62: CAD file, 2026-10-15]
CAD/out/controller_top.stl
178.0 x 87.0 x 10.5
