seiftotal30-source/BLOC-BOT/CAD/out/vbloc/vbloc_base.stl

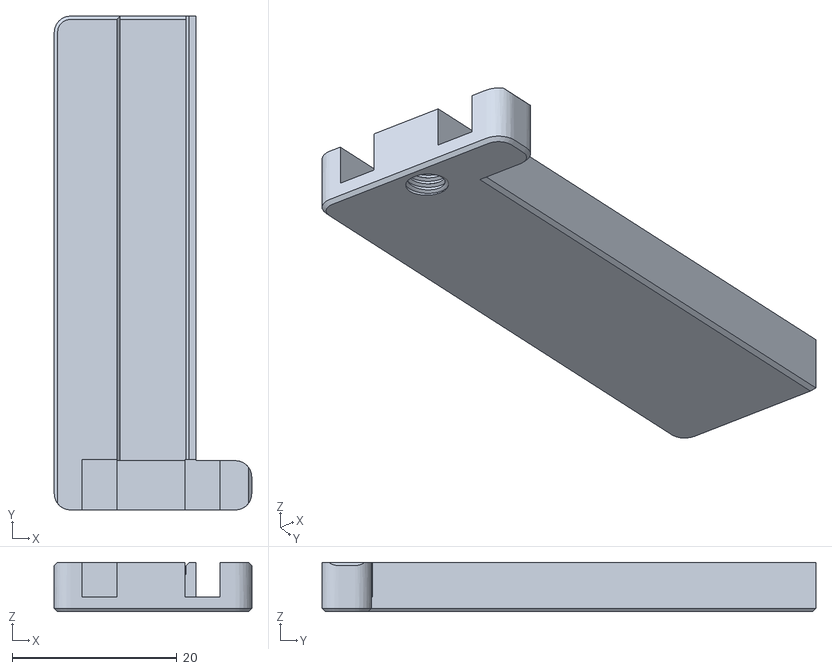
[picture p63: CAD file, 2026-10-14]
CAD/out/vbloc/vbloc_base.stl
24.0 x 60.0 x 6.00
