seiftotal30-source/BLOC-BOT/CAD/3mf/HBloc.3mf

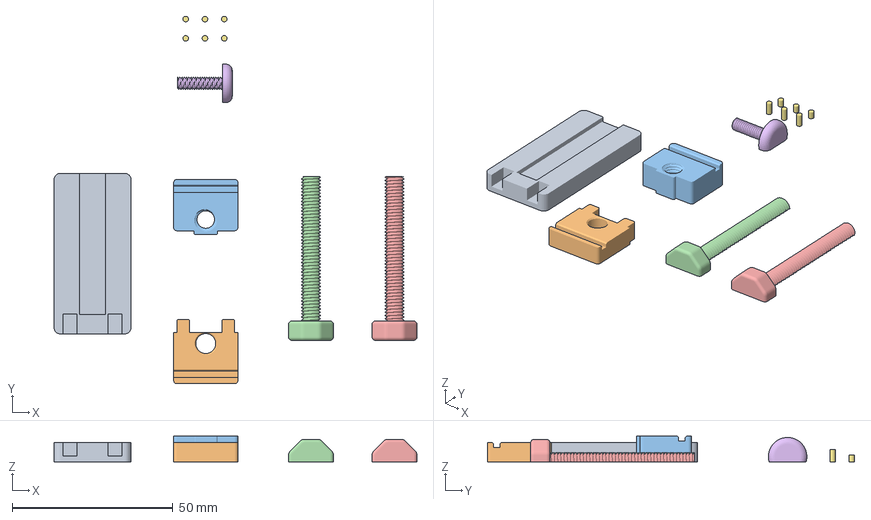
[picture p64: CAD file, 2026-10-14]
CAD/3mf/HBloc.3mf
113.0 x 114.4 x 8.00 mm
H bloc arm
H bloc fixed jaw
H bloc sliding jaw
H bloc lead screw top half
H bloc lead screw bottom half
H bloc thumb screw
H bloc pins (3 long, 3 short)
