seiftotal30-source/BLOC-BOT/CAD/out/controller_bottom.stl

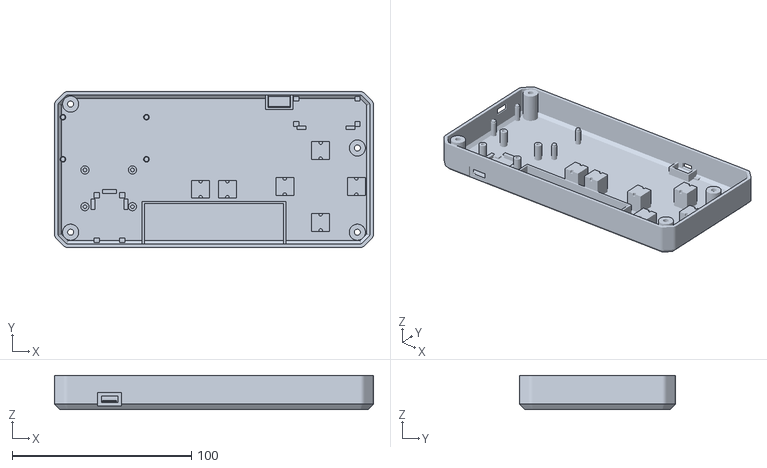
[picture p65: CAD file, 2026-10-14]
CAD/out/controller_bottom.stl
178.0 x 87.0 x 19.0
