seiftotal30-source/BLOC-BOT/CAD/out/hbloc/hbloc_base.stl

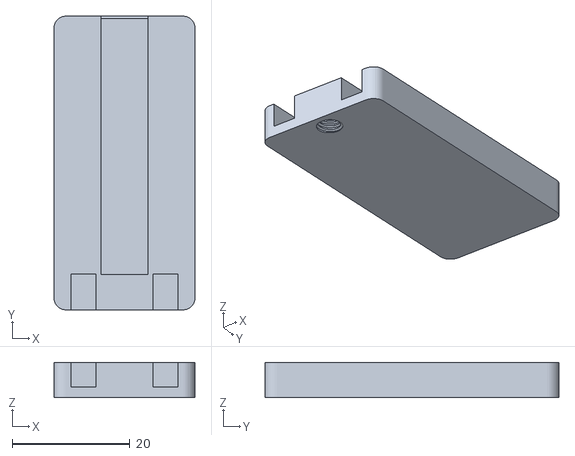
[picture p66: CAD file, 2026-10-14]
CAD/out/hbloc/hbloc_base.stl
24.0 x 50.0 x 6.00
