seiftotal30-source/BLOC-BOT/CAD/out/vbloc/vbloc_fixedjaw.stl

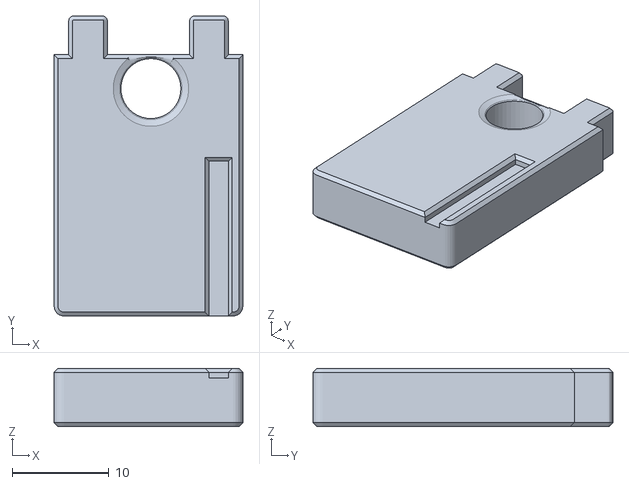
[picture p67: CAD file, 2026-10-14]
CAD/out/vbloc/vbloc_fixedjaw.stl
19.5 x 31.0 x 6.00
