seiftotal30-source/BLOC-BOT/CAD/3mf/VBloc_threads_test.3mf

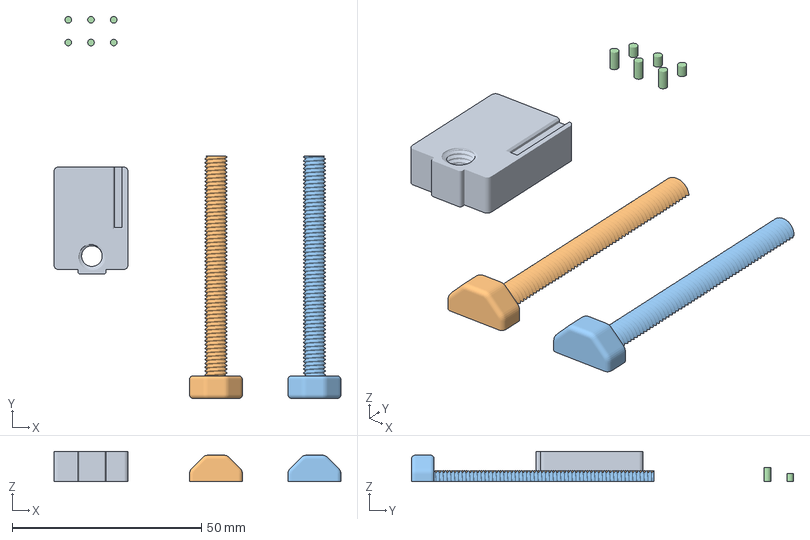
[picture p68: CAD file, 2026-10-14]
CAD/3mf/VBloc_threads_test.3mf
75.8 x 100.9 x 8.00 mm
VBloc sliding jaw
VBloc lead screw top half
VBloc lead screw bottom half
VBloc pins (3 long, 3 short)
