seiftotal30-source/BLOC-BOT/CAD/out/hbloc/hbloc_cap.stl

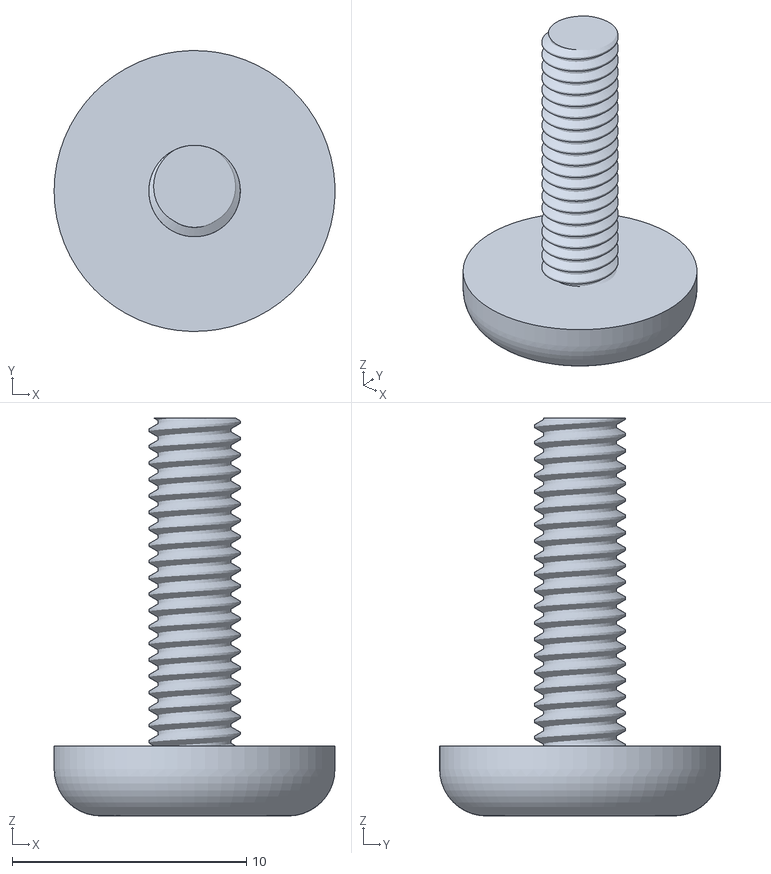
[picture p69: CAD file, 2026-10-06]
CAD/out/hbloc/hbloc_cap.stl
12.0 x 12.0 x 17.0
