seiftotal30-source/BLOC-BOT/CAD/out/waffle_plate.stl

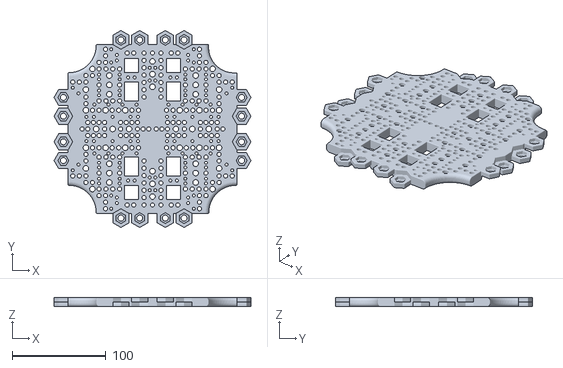
[picture p70: CAD file, 2026-10-06]
CAD/out/waffle_plate.stl
210.0 x 210.0 x 10.0
