seiftotal30-source/BLOC-BOT/CAD/3mf/VBloc.3mf

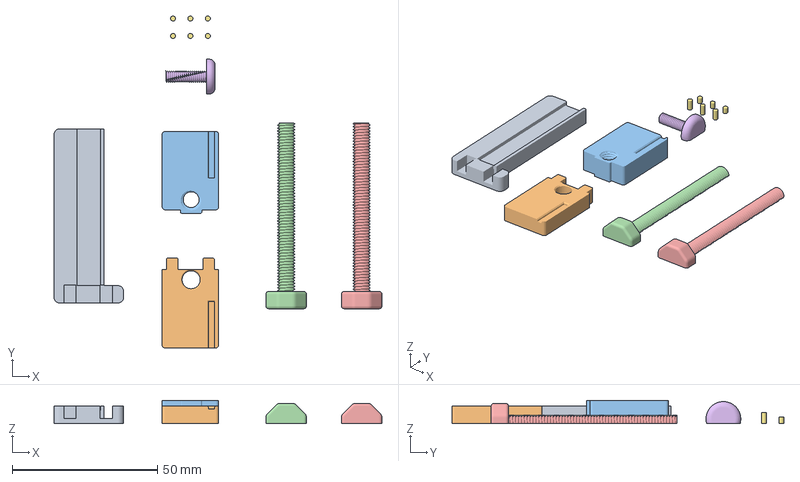
[picture p71: CAD file, 2026-10-14]
CAD/3mf/VBloc.3mf
113.0 x 114.4 x 8.00 mm
VBloc arm
VBloc fixed jaw
VBloc sliding jaw
VBloc lead screw top half
VBloc lead screw bottom half
VBloc thumb screw
VBloc pins (3 long, 3 short)
