seiftotal30-source/BLOC-BOT/CAD/out/vbloc/vbloc_cap.stl

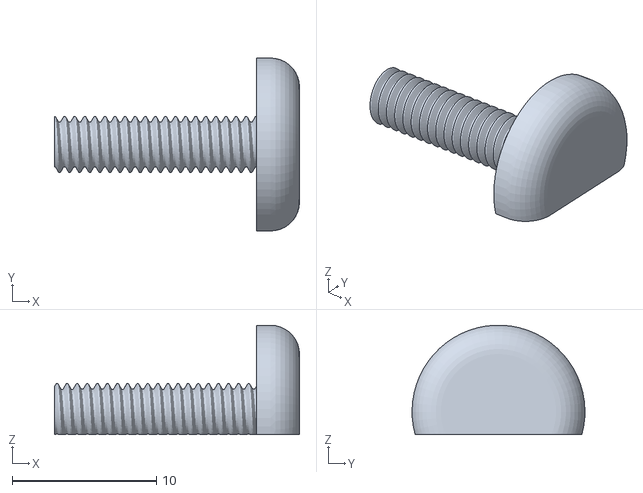
[picture p72: CAD file, 2026-10-12]
CAD/out/vbloc/vbloc_cap.stl
17.0 x 12.0 x 7.59
