seiftotal30-source/BLOC-BOT/CAD/3mf/Controller_case.3mf

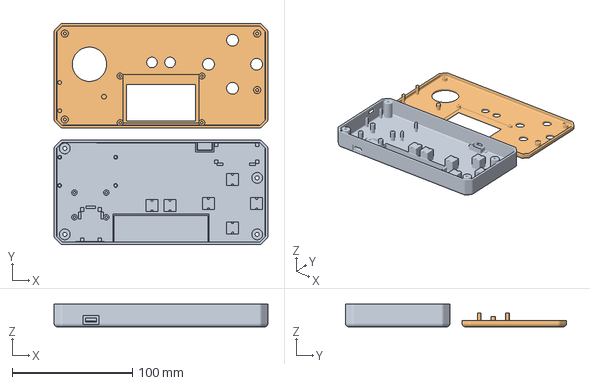
[picture p73: CAD file, 2026-10-12]
CAD/3mf/Controller_case.3mf
178.0 x 184.0 x 19.0 mm
Controller case bottom
Controller case top
