seiftotal30-source/BLOC-BOT/CAD/3mf/MotorBracket_right.3mf

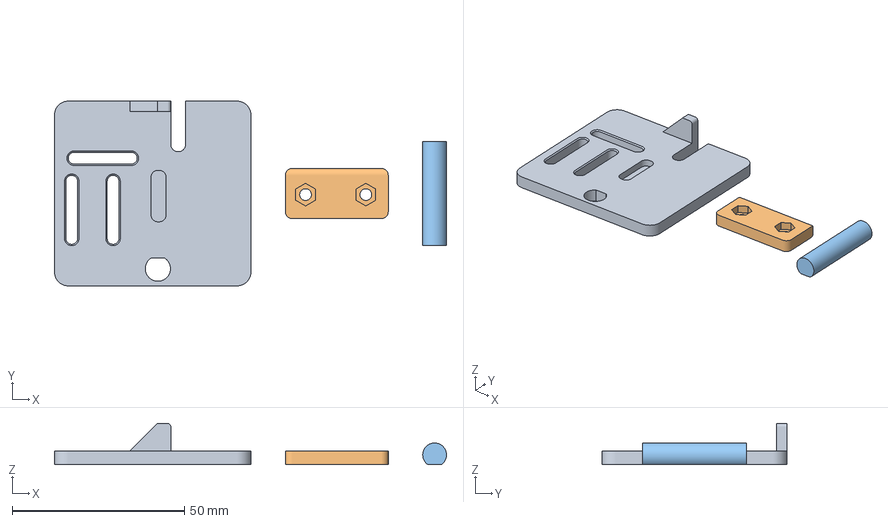
[picture p74: CAD file, 2026-10-12]
CAD/3mf/MotorBracket_right.3mf
113.7 x 53.6 x 12.0 mm
Motor bracket right flange
Motor bracket right motor tab
Motor bracket right sensor column
