seiftotal30-source/BLOC-BOT/(list of files, cad)

Other CAD files:
CAD/3mf/from_professional/Bracket(Mirror).3mf
CAD/3mf/FlyingFish_mount.3mf
CAD/controller/remote-controller/RC Transmitter.f3d
CAD/out/H bloc.f3d
CAD/out/HBloc.f3d
CAD/out/VBloc.f3d
CAD/out/hbloc/hbloc_leadscrew.stl
CAD/out/hbloc/hbloc_leadscrew_bottom.stl
CAD/out/vbloc/vbloc_leadscrew.stl
CAD/out/vbloc/vbloc_leadscrew_bottom.stl
CAD/out/vbloc/vbloc_leadscrew_top.stl
CAD/out/waffle plate.f3d
CAD/ref/tt-motor-dual-shaft-1.snapshot.1/TT Motor Dual Shaft/_XRef_/TT Motor Dual Shaft F3D.f3d
