seiftotal30-source/BLOC-BOT/CAD/out/angle_assembly_under_front.png

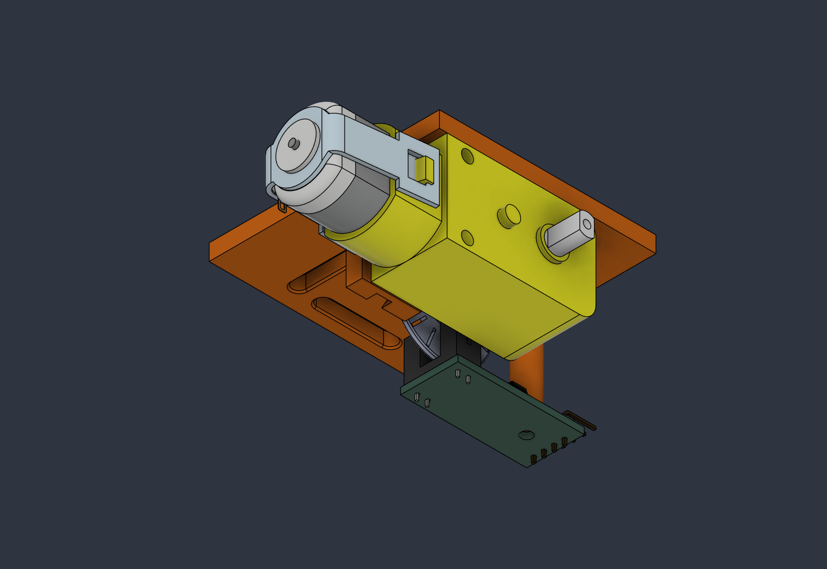
CAD/out/angle_assembly_under_front.png
