seiftotal30-source/BLOC-BOT/CAD/out/angle_assembly_under_rear.png

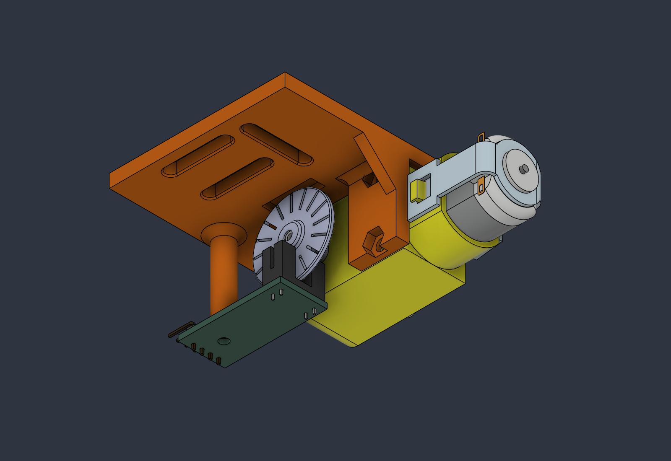
CAD/out/angle_assembly_under_rear.png
