seiftotal30-source/BLOC-BOT/circuits/kicad/controller/controller.kicad_sch

## KiCad design circuits/kicad/controller/controller.kicad_sch (2026-10-25)

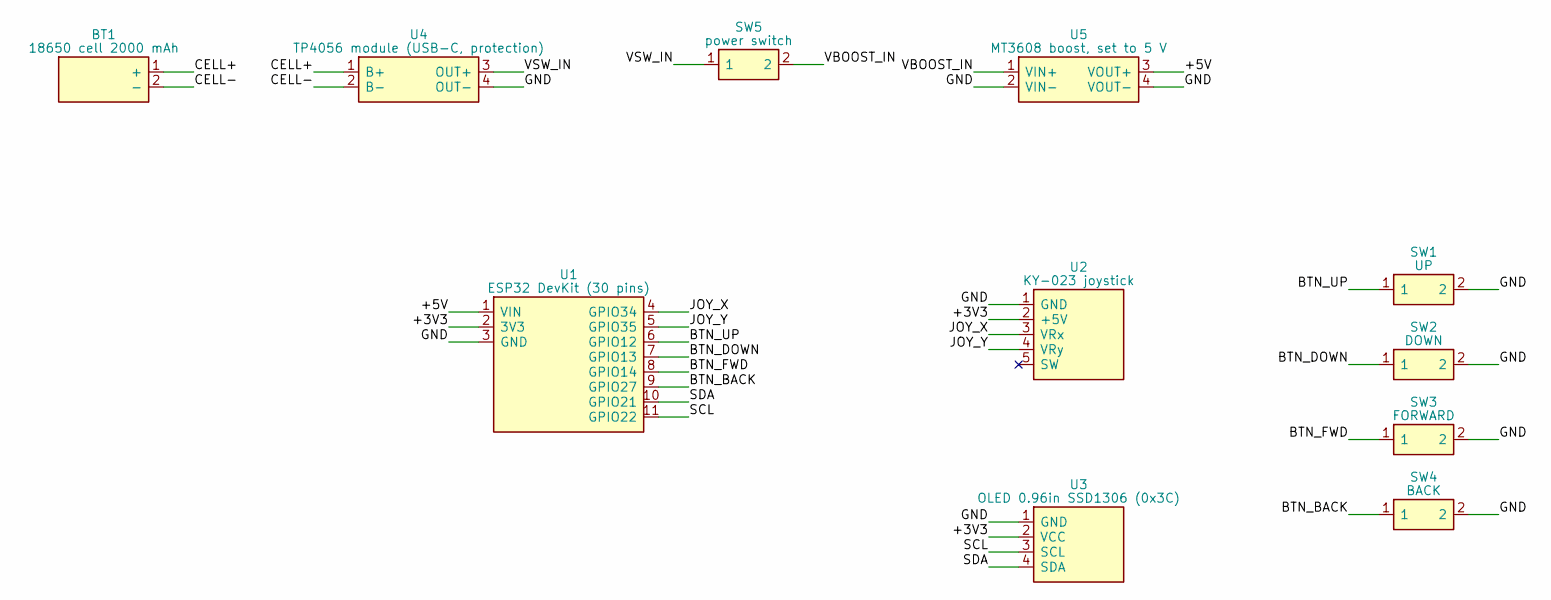
[picture p77: schematic controller.kicad_sch]

Parts:
BT1: 18650 cell 2000 mAh
SW1: UP
SW2: DOWN
SW3: FORWARD
SW4: BACK
SW5: power switch
U1: ESP32 DevKit (30 pins)
U2: KY-023 joystick
U3: OLED 0.96in SSD1306 (0x3C)
U4: TP4056 module (USB-C, protection)
U5: MT3608 boost, set to 5 V

Connections:
+3V3: U1.2 (3V3), U2.2 (+5V), U3.2 (VCC)
+5V: U1.1 (VIN), U5.3 (VOUT+)
BTN_BACK: SW4.1, U1.9 (GPIO27)
BTN_DOWN: SW2.1, U1.7 (GPIO13)
BTN_FWD: SW3.1, U1.8 (GPIO14)
BTN_UP: SW1.1, U1.6 (GPIO12)
CELL+: BT1.1 (+), U4.1 (B+)
CELL-: BT1.2 (-), U4.2 (B-)
GND: SW1.2, SW2.2, SW3.2, SW4.2, U1.3 (GND), U2.1 (GND), U3.1 (GND), U4.4 (OUT-), U5.2 (VIN-), U5.4 (VOUT-)
JOY_X: U1.4 (GPIO34), U2.3 (VRx)
JOY_Y: U1.5 (GPIO35), U2.4 (VRy)
SCL: U1.11 (GPIO22), U3.3 (SCL)
SDA: U1.10 (GPIO21), U3.4 (SDA)
VBOOST_IN: SW5.2, U5.1 (VIN+)
VSW_IN: SW5.1, U4.3 (OUT+)
