seiftotal30-source/BLOC-BOT/Bloc-Con/include/screens.h

#ifndef SCREENS_H
#define SCREENS_H

// one screen is shown at a time, the menu opens the others

enum Screen {
  MENU_SCREEN,
  ULTRASONIC_SCREEN,
  MPU_SCREEN,
  LINE_SCREEN,
  FOLLOW_SCREEN,
  DRIVE_SCREEN,
  ABOUT_SCREEN,
  SETTINGS_SCREEN
};

extern Screen currentScreen;

// ui.cpp
void showSplash();
void initButtons();
void handleButtons();
void drawMenu();
void drawAbout();
void drawSettings();

// screen_drive.cpp
void drawDriveScreen();
void stopRobot();  // sends a few stop commands

// screen_ultrasonic.cpp
void initLocalUltrasonic();
void drawUltrasonic();

// screen_mpu.cpp
void initLocalMpu();
void resetMpuFilter();
void drawMpu();

// screen_line.cpp
void drawLine();

// screen_follow.cpp (menu: Start)
void openFollow();     // starts in calibration
void followForward();  // FORWARD: calibration -> following
void stopFollow();     // BACK: line follower off
void drawFollow();

#endif
