seiftotal30-source/BLOC-BOT/(commit log)

2026-10-05 Add reference models for the TT motor, LM393 sensor and encoder disc
    These are the source of truth for every motor, disc and sensor dimension
    (there is no measuring tool available, so nothing is guessed):
    - TT Motor Dual Shaft (Oj Simpson), .f3d + STEP
    - MH-Sensor-Series speed sensor (PENNEL Patrice): LM393 board with 5 mm
    fork, plus the encoder disc (16-slot, 24 mm) and two photos of the board
    Zips are kept as downloaded; CAD/ref holds the extracted files that the
    Fusion design imports. .gitattributes marks CAD, mesh and image formats as
    binary so Git never tries to diff or convert them.
2026-10-05 Add parametric Fusion build, check and export scripts for the bracket
    build_bracket.py rebuilds the right bracket entirely from User Parameters;
    every sketch is fully constrained, so editing a parameter in Fusion moves
    the geometry. Key decisions, documented in the script comments:
    - tab on the motor's flat inner face; left motor mounts upside-down
    - LM393 lies flat under the disc (a vertical wall would hit the floor or
    the plate), screwed to a column that prints without supports
    - relief pocket for the 24 mm disc, which rises above the gearbox top
    - slots placed over real waffle-plate holes, nuts >= 3 mm from disc/fork
    checks.py verifies clearances against the reference parts; export_stl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
2026-10-05 Add first printable brackets, design backup, screenshots and README
    Outputs of the current design (axle at Y = +75, wheel inner face at X = 95):
    - bracket_right.stl / bracket_left.stl: flange on the bed, no supports
    - test_tab.stl: motor tab plus a 5 mm flange stub, for a quick fit test on
    a real motor before printing the full brackets
    - Motor Bracket.f3d: full Fusion archive (timeline, parameters, references)
    - screenshots from several angles, with and without the plate
    All checks pass: disc-tab 3.25 mm, wheel-bracket 5.0, wheel-plate 5.0,
    pillar hex tabs uncovered, nuts >= 3 mm from disc and fork. Still to verify
    on the real parts: gearbox-to-wheel gap (assumed 5 mm) and the board's
    mou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
2026-10-05 Set up LaTeX thesis with figure, reference and search tracking
    thesis/ holds the thesis sources:
    - main.tex: report-class skeleton using biblatex, reading images straight
    from CAD/out so re-rendered figures update automatically
    - figures.tex: ready-made blocks for the 12 bracket screenshots, each with
    a caption, label and a note on how it was produced
    - references.bib: the sources actually used (TT motor and LM393 sensor
    models, Fusion, the Fusion API, Git); three URLs still marked TODO
    - tracking/log.md: running log of every figure, graph, reference and
    search, including the plate, motor, sensor and disc lookups that drove
    the bracket design
    .gitignore now skips LaTeX build files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
2026-10-05 Add reference models for the controller parts
    Source models for the handheld controller, all by Seif, used the same
    way as the motor and sensor references: every part dimension comes from
    these files, not from guesses.
    - ESP32 DevKit v1 (STEP)
    - KY-023 joystick module: full module plus stick, base board and thumb
    button as separate STEPs, with reference renders
    - 2.42" 128x64 OLED display (STEP + photo)
    - OMRON B3F-4050 12x12 mm tactile switch (STEP)
    - MT3608 2 A boost converter (STEP, STL, OBJ, 3MF + renders)
    - TP4056 Type-C charging module (.f3d + STEP + photos)
    - RC Transmitter enclosure (.f3d) with renders, as a layout reference
    Zips are kept as downloaded; CAD/controller holds the ex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
2026-10-05 Add shared helpers for the Controller build scripts
    ctl_helpers.py is exec'd at the start of every controller script. It
    refuses to run unless the active document is "Controller", so a script
    can never touch "Motor Bracket" or "waffle plate" by mistake. Positions
    come from User Parameters (pv/setp) so the build follows them, and it
    adds bounding-box, temporary-body and overlap-volume helpers for the
    fit checks. A no-op run() is included because the Fusion MCP wrapper
    calls it after exec and rolls the script back if it's missing.
2026-10-05 Use Latin Modern fonts and add the built thesis PDF
    With T1 encoding and no lmodern package, LaTeX fell back to bitmap
    Type 3 fonts that look blurry when zoomed. lmodern gives vector fonts.
    main.pdf is the current build (made after this change), tracked as the
    .gitignore already intends.
2026-10-05 Add parametric build, check and export scripts for the controller
    Seven scripts, run in Fusion through ctl_helpers.py, that build the
    handheld controller case from User Parameters:
    - ctl_params: 117 parameters. Part dimensions are read from the
    reference models; values with no model (18650 holder, slide switch,
    plug overmolds, switch travel) are marked "assumed".
    - ctl_place: moves the reference parts into the layout and adds
    stand-in boxes for the holder and slide switch.
    - ctl_shell: chamfered outline taken from the GrabCAD RC Transmitter,
    3 mm fillets, 2 mm walls, split at z = 19 so both USB openings are
    in the bottom half.
    - ctl_details: bosses, switch pillars, board standoffs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
2026-10-05 Add first printable controller case, caps and screenshots
    Outer size 178 x 87 x 24.5 mm. The STLs are exported in print
    orientation and are watertight (0 open edges):
    - controller_top.stl: face down, bosses grow upward
    - controller_bottom.stl: flat on the floor
    - controller_caps.stl: six caps, flange down
    Checks on this version: no collisions across 514 body pairs, every cap
    presses its switch and nothing else, the joystick clears at 29 deg in
    8 directions, the OLED active area is fully visible, and both USB
    ports are reachable.
    Hardware: 4 x M3x20 for the halves, 8 x M2.5x6 self-tappers for the
    OLED and joystick. Still to verify on real parts: the 18650 holder
    and slide switch sizes, and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
2026-10-05 Track controller figures, model references and lookups for the thesis
    - Figures F13-F16 (controller iso, top, exploded, section) with LaTeX
    blocks and how each was made.
    - References for the GrabCAD Remote Controller (Slyman Rambo) and the
    six part models. Authors and download URLs for the part models are
    still TODO.
    - Lookups S09-S14: the dimensions read from each model and the design
    decision each one fed.
2026-10-06 Add proposed electronics plan and robot circuit diagram
    - electronics/README.md: power chains for the robot (2S, BMS, buck,
    DRV8871) and the controller, the proposed ESP32-S3 pin map with
    spare pins, build steps, known risks and fixes, and the tools to
    use for simulation and documentation.
    - electronics/robot_circuit.svg: block diagram of the robot circuit.
    - Figure F17 in the thesis tracking log (draft, not in LaTeX yet).
    Nothing here is wired or tested yet; the move to the ESP32-S3 is
    still a proposal.
2026-10-06 Add H bloc and VBloc design backups
    Export both vise designs from the Bloc-Bot project as .f3d archives so the
    repo keeps a copy alongside the other design backups in CAD/out/.
    H bloc (the horizontal vise, renamed from "Bloc"), version 3:
    - Opened up the M6 jaw thread and the M4 mounting thread by 0.2 mm
    (offset faces at the end of the timeline). The ISO 6H/6g tolerances
    left about 0.08 mm per side, which FDM prints fuse or bind; the screw
    now has about 0.28 mm per side. The jaw tongue already had 0.3 mm in
    the guide groove and was left as is.
    - Still to verify on a real print: M6 fit on the university Ender, the
    M4 thread quality (a tap or heat-set insert may be needed), and the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
2026-10-06 Add Ender-5 print files for H bloc and VBloc
    Export the four parts of each vise as print-oriented STLs and slice them
    for a Creality Ender-5 (the university printer) so they can go straight
    to the printer.
    Parts are placed on one 220 x 220 mm plate per vise, in the orientations
    chosen for clean threads and no supports:
    - base flat on its bottom
    - sliding jaw on its back face, so the thread hole is vertical
    - lead screw standing on its knob
    - thumb screw head down
    Slice settings (PLA, 0.4 mm nozzle): 0.16 mm layers (0.2 mm first),
    3 walls, 35 % grid infill, 6 top/bottom layers, 200 C (205 C first
    layer), bed 60 C, 50 mm/s (25 mm/s outer walls), 5 mm retraction for the
    Bowden extruder, 6 mm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
2026-10-06 Add pictures of H bloc, VBloc and the waffle plate
    Add viewport pictures of the three designs in a new CAD/pictures/ folder,
    one subfolder per design, so the models can be seen without opening
    Fusion.
    - hbloc/ and vbloc/: iso front-right, iso front-left, front, right and
    top views of each vise, as assembled in the design (H bloc version 3
    with the thread clearance, VBloc version 2).
    - waffle_plate/: iso front-right, iso front-left, top, bottom and iso
    underside views. The plate is only 10 mm thick, so the bottom and
    underside views replace the front and side views. Sketches, origin
    and construction planes were hidden for the pictures; the design
    itself was not changed or saved.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
2026-10-06 Add OpenSCAD rear mount for the Flying Fish IR sensor
    A test part for the rear obstacle sensor, built in OpenSCAD instead of
    Fusion. One profile extruded along the board, so it prints on its side
    with no supports (Cura, Ender-5: 1 h 15 min, 9 g PLA).
    - Board dimensions taken from the GrabCAD "Flying Fish MH-B" model
    (31.25 x 14.15 x 1.6, hole at 24.25 from the LED end).
    - Crossed M3 slots in the flange, since the plate hole list is only in
    Fusion. Beam axis 35 mm above the floor, pointing straight back.
    - 3 mm shelf with a 12 x 1.5 mm channel for the LED leads and header
    pins that poke through the board; 0.2 mm groove clearance.
    - Board slides in from the LED end against a stop at the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
2026-10-06 Add Ender-5 G-code for the Flying Fish mount
    Sliced in Cura 5.13 for the original Creality Ender-5: generic PLA
    200 C / bed 60 C, 0.2 mm layers, 3 walls, 40 % infill, brim, no
    supports, -0.15 mm initial layer horizontal expansion. About 1 h 16
    min and 2.9 m (9 g) of filament.
2026-10-06 Fit the Flying Fish mount to the real waffle plate and sensor
    The first version was drawn for a plate edge at y = -105 (the README's
    210 x 210 outline, which includes the hex pillar tabs). The plate body
    in the "waffle plate" Fusion design ends at y = -89.75, so on the real
    plate neither screw slot met a plate hole (slot 2 was off the plate)
    and only 22 % of the flange touched the plate.
    Changes in flyingfish_mount.scad:
    - plate_rear_y = -89.75, measured in Fusion
    - flange_w 30 -> 16 mm, so the flange ends at x = 62, before the
    plate's rounded corner cut-out
    - the two slots are replaced by M3 holes over real 4.5 mm plate holes
    at (50, -85) and (57, -71); an assert stops the render if a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
2026-10-06 Add waffle plate design backup and STL
    Export the "waffle plate" design (version 14) from the Bloc-Bot project
    so the repo has the plate the brackets and the Flying Fish mount are
    checked against.
    - CAD/out/waffle plate.f3d: Fusion archive of the design
    - CAD/out/waffle_plate.stl: the plate body, 210 x 210 x 10 mm over the
    hex pillar tabs (the plate body itself ends at +-89.75 mm), solid,
    228.7 cm3. Exported at medium mesh refinement (12.6 MB); high was
    27 MB with no benefit for printing.
2026-10-06 Correct the H bloc and VBloc filament weights
    The print settings sheet gave 7.1 m / 21 g for H bloc and 8.0 m / 24 g
    for VBloc. That count added every retraction re-prime (about 650 per
    file) as new filament, and came out heavier than the solid parts.
    Counting only the extrusion moves gives:
    - H bloc: 4.0 m, about 11.8 g of PLA
    - VBloc: 4.65 m, about 13.9 g of PLA
    The sheet now also lists the weight per part and notes that both vises
    are inside the 10-15 g per bloc estimate. The G-code files themselves
    are unchanged.
2026-10-12 Rework VBloc for printing and slice it for the Ender 5 Plus
    Apply the rules from the professional's motor bracket rework: every part
    prints flat on a face with no supports, layers run along the direction a
    part is loaded, and parts that need two print directions are split and
    glued.
    Design (Fusion "VBloc", new steps at the end of the timeline):
    - internal M6 and M4 threads opened by 0.2 mm, as on H bloc
    - base split where the fixed jaw sits on the arm and glued back: two
    4 mm tenons in notches, 0.14 mm clearance per side, 0.2 mm extra depth
    for glue (about 245 mm2 of glue surface); both pieces print 6 mm tall
    - lead screw split lengthwise into two identical halves that print on
    their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
2026-10-12 Slice VBloc for the Ender 3 Pro and fix unfilled end G-code
    Add Ender 3 Pro G-code for VBloc, the printer the professional printed
    the motor bracket on, with his settings (0.28 mm, 2 walls, 60 % infill,
    200/50 C, skirt), centred on its 220 x 220 bed:
    - VBloc_Ender3Pro.gcode: all parts and pins, about 1 h 03 min, 16.2 g
    - VBloc_threads_test_0.16_Ender3Pro.gcode: screw halves, sliding jaw
    and pins at 0.16 mm with a brim, about 46 min
    Fix: Cura's start/end G-code for these printers has {setting}
    placeholders that only the Cura app fills in. The command-line engine
    left "G1 X{machine_width} Y{machine_depth}" in the end of both Ender 5
    Plus VBloc files, a line a printer can't read. They are re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
2026-10-12 Add 3MF print files for every design
    From now on every plate we print is also kept as a 3MF, so it opens
    in any slicer ready to slice for whichever printer is at hand. The
    parts are turned to the face they print on, one object per part, and
    the plate is centred on a 220 x 220 bed.
    CAD/3mf/ (README.md says what each file is):
    - VBloc.3mf, VBloc_threads_test.3mf
    - HBloc.3mf
    - MotorBracket_right.3mf, MotorBracket_left.3mf: the professional's
    3-part bracket, each part on its largest flat face as he printed it
    - FlyingFish_mount.3mf, Waffle_plate.3mf
    - Controller_case.3mf (bottom and top), Controller_caps.3mf
    - from_professional/: his Bracket.3mf, Bracket(Mirror).3mf and the
    CE4_Bracket.gcod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
2026-10-14 Add the professional's Ender 3 Pro Cura profile
    Imported in Cura 5.13 from his CE3PRO_Bracket.gcode: 0.28 mm adaptive
    layers, 3 walls, 60 % triangles infill, 238 C nozzle, bed 70/67 C,
    fan off, skirt. Import it in Cura under Preferences > Profiles > Import.
2026-10-14 Rework VBloc edges, screw hole and knob after the first print
    The first print showed three problems: the lead screw wobbled in the
    fixed jaw, the knob's notches hurt to turn, and the edges had no breaks.
    Screw hole: 6.6 mm for the 5.88 mm M6 thread was 0.36 mm of play per
    side over a 6 mm thick jaw. Now 6.2 mm (0.16 mm per side; upright
    printed holes come out about 0.1 mm small, so the screw still turns),
    with 0.4 mm chamfers on both rims.
    Knob: the 8 scalloped notches left sharp ridges. It is now an octagon,
    14 mm across the flats, R2 corners and R1 rims. The screw split runs
    through the middle of two flats, so each half still prints on its cut
    face with no overhang. The two knob pin hole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
2026-10-14 Slice with the professional's Cura profile at 40 % infill
    slice_pro.sh now uses CE3PRO_pro.curaprofile instead of the values read
    from his CE4 bracket G-code: 0.28 mm adaptive layers, 3 walls, 0.45 mm
    lines, triangles infill, 65/50/45 mm/s, 238 C nozzle, bed 70 then 67 C,
    fan off, skirt 2 lines (brim 25 for the thread test). Values the
    profile leaves to Cura formulas are worked out as Cura does; skin
    support follows Cura's rule (on only below 40 % infill), since left on
    it also switched the fan on.
    Infill is 40 % for small parts (default) and 20 % for big ones such as
    the waffle plate (INFILL=20), instead of his 60 %.
    Re-sliced all four VBloc G-codes: full plate about 42 min, 4.8 m
    (14.8 g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
2026-10-14 Rework H bloc and the controller case, cut chamfers to entry rims
    H bloc printed as one base with the fixed jaw standing 22 mm tall
    (horizontal screw hole, layers across the jaw), a lead screw standing on
    its knob, and a notched knob. It now follows the same rules as VBloc:
    - base split at the arm top: the fixed jaw glues on with two 4 x 6 x 4 mm
    tenons in notches (0.14 mm per side, 0.2 mm deeper) and prints on its
    outer face, so the screw hole prints round
    - screw hole 6.6 -> 6.2 mm with 0.4 mm rim chamfers
    - lead screw: octagon knob (14 mm across flats, R2 corners, R1 rims),
    split lengthwise into two halves that print on the cut face, with
    1.85 mm pin holes
    - thumb screw lies on a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
2026-10-14 Add OpenSCAD and CQ-editor viewers for the controller case
    - CAD/scad/view_controller.scad: assembles controller_bottom, _top and
    _caps from CAD/out (top flipped from its print orientation); set
    gap = 0 for the closed case. Two preview PNGs, exploded and closed.
    - CAD/view_controller.py: the same exploded view for CQ-editor, and
    prints each part's size.
2026-10-15 Move the controller buttons and boards, chamfer the shell rims
    Layout: joystick top-left with two buttons in a row below it
    (btn_n, btn_x0, btn_pitch, btn_y), a directional cross of four
    buttons under the right thumb at (57.5, -9.5), ESP32 bottom-left on
    14.8 mm standoffs so its header pins clear the TP4056. Parting plane
    19 -> 14 mm (micro-USB in the top shell, USB-C in the bottom). The
    D-pad and BACK/FORWARD parameters are retired.
    The shell rims are 45 deg chamfers now, so the TP4056 and MT3608
    ledges, battery holder gap and switch pad grew to clear the inner
    chamfer. New ctl_clear_details.py strips the details for a rebuild;
    ctl_entry_chamfers.py adds the 0.4 mm cap-hole and counterbore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
2026-10-15 Slice HBloc for the Ender 3 Pro and Ender 5 Plus
    Sliced from CAD/3mf/HBloc.3mf with slice_pro.sh (the professional's
    profile, 0.28 mm, 40 % infill). The README no longer says HBloc
    is unsliced.
2026-10-15 Switch the robot motor driver to one DRV8833
    One DRV8833 drives both TT motors (bridge A left, B right) in place
    of two DRV8871s; the DRV8871 needs 6.5 V and cut out at half charge
    on 2S. README: datasheet limits (2.7-10.8 V, never 3S; 1.5 A RMS per
    bridge on the HTSSOP chip), wiring table, control scheme, and nSLEEP
    on GPIO 14 / nFAULT on GPIO 13. Circuit SVG updated. Datasheet added
    to references.bib and logged as S15.
2026-10-15 Add the caster support in two versions
    The caster (GrabCAD "Nylon Caster Wheel": plate 38 x 32, holes 30 x
    23, 34 mm tall) sits on the centre line at the edge away from the
    drive wheels, y = -70, with the waffle plate turned 90 deg as on the
    real robot. Both versions bolt to the plate underside with 4 M3
    screws through Ø4.5 plate holes at (+-27, -71) and (+-7, -34) into
    nut traps, and take the caster on 4 countersunk M3 screws from the
    top face.
    - A: 4 mm plate (the bracket flange's thickness) with four printed
    Ø8 x 9.75 mm pillars; the caster's metal pillars are not used
    - B: the same plate with a 38 x 32 x 9.75 mm boss
    Both give 4 + 9.75 + 34 = 47.75 mm, plate underside to floor, the
    s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
2026-10-15 Add circuits folder with updated DRV8833 wiring diagram
    AIN1 moves from GPIO 15 to GPIO 13, the right motor is flipped in
    firmware, and the link LED on GPIO 4 is listed.
2026-10-15 Label LEFT and RIGHT motors on the DRV8833 diagram
2026-10-15 Add LM393 speed sensors to the DRV8833 diagram
    Left DO on GPIO 40, right DO on GPIO 41, VCC on ESP32 3.3 V.
2026-10-15 Add assembled HBloc and VBloc 3MF exports from Fusion
2026-10-16 Add HBloc_L 3MF: large HBloc for the 5-channel line sensor
    Stretched for a 96-100 mm board, jaws 34 mm tall, two M4 mounts 130.67 mm apart, through-slot base with a deep sliding-jaw tongue.
2026-10-19 Tighten the jaw screw hole and loosen the jaw glue joint on all blocs
    Fit feedback from the first printed blocs:
    - Fixed-jaw lead screw hole 6.2 -> 6.0 mm (the screw still wobbled a bit).
    - Fixed-jaw tenon mortises 0.14 -> 0.20 mm per side (the jaw had to be forced in).
    HBloc also gets the through-slot base and deep sliding-jaw tongue that HBloc_L has.
2026-10-19 Update the waffle plate and add the pillar set
    Waffle plate:
    - Rim tabs evenly spaced: inner tabs moved 13.66 -> 11.22 mm, so every edge
    has four tabs 22.44 mm apart.
    - Hex pockets on both faces of every tab (1.5 mm pocket / 2 mm floor /
    1.5 mm pocket), so the upper plate holds the pillar tops without being
    flipped and a third plate could stack the same way.
    Pillars (print x4 pillars, x8 nuts):
    - M6 hex standoff, 9.6 mm across flats (0.2 mm per side in the 10 mm
    plate pockets), 5 mm studs.
    - Round knurled cap nut 9.4 mm x 4 mm that turns inside the pockets;
    thread +0.2 mm print clearance, 0.4 mm lead-in, 1.4 mm wall at the grip
    grooves. Print it open face down.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
2026-10-20 Add controller firmware, circuits, CAD outputs, hardware photos, gitignore updates
2026-10-20 Drop the unused link heartbeat and label the robot driver as DRV8833
2026-10-20 Add Ender 3 Pro G-code for both motor brackets
    Left and right bracket (flange, motor tab, sensor column) on one plate,
    sliced with the professional's Cura profile at his 60 % infill: 0.28 mm
    adaptive layers, 3 walls, 238 C nozzle, bed 70/67 C, fan off, skirt.
    About 1 h 17 min, 9.7 m of filament.
    CuraEngine ramped the nozzle down to 0 C over the last layers (the
    flange prints alone at the end); those heater lines are removed so the
    nozzle holds 238 C until the end-of-print command.
2026-10-20 Add the print cost table built from the G-code files
2026-10-21 Smooth wheel speed: measure time between encoder pulses
    With a 16-slot disc, a 100 ms window held only 2-5 pulses, so one pulse
    more or less made the reported speed jump by 128 mm/s. Speed now comes
    from the average pulse-to-pulse time in each window, lightly smoothed,
    and falls gradually to 0 when the wheel stops.
    Also map the old ledcSetup/ledcAttachPin/ledcWrite calls onto the
    Arduino-ESP32 3.x API so the firmware builds on the current platform.
2026-10-22 Add PINS.md: pin map for Bloc-Con and Bloc
    Lists every GPIO used by the code on main for both boards, the pins still
    only planned in electronics/README.md, the free pins, and two open
    conflicts (GPIO 4 link LED vs line sensor, GPIO 13 AIN1 vs nFAULT).
2026-10-22 Remove the GPIO 4 test LED, keep the onboard LED for the link
    The external LED on GPIO 4 was only used to check the ESP-NOW link and is
    not fitted. GPIO 4 is planned for a line sensor, so the firmware no longer
    drives it. The onboard RGB LED still shows green while Con is connected.
    PINS.md updated to match.
2026-10-22 Bloc-Con: add an MPU6050 screen for bench testing
    Temporary test with the MPU6050 on Con's I2C bus (SDA D21 / SCL D22,
    shared with the OLED). New "MPU6050" menu entry shows roll and pitch
    (complementary filter), gyro rates, and a spirit-level dot. The gyro is
    zeroed at startup. The menu now scrolls, since 7 entries no longer fit.
    Also builds on Arduino-ESP32 3.x (new ESP-NOW receive callback) and
    uploads at 115200, the only speed this board's CP2102 handles reliably.
2026-10-22 PINS.md: note the temporary MPU6050 on Con's I2C bus
2026-10-22 Send MPU6050 data from Bloc to Con over ESP-NOW
    Bloc reads the MPU6050 on I2C (SDA 8 / SCL 9), zeroes the gyro at
    startup, runs a complementary filter for roll and pitch, and broadcasts
    an ImuPacket (0xB4: roll, pitch, gyro x/y/z, all x10) at 20 Hz.
    Con shows Bloc's data on the MPU6050 screen, labelled "Bloc" in the
    corner. Without packets from Bloc it falls back to an MPU wired straight
    to Con, and otherwise shows "Waiting for Bloc".
2026-10-22 Send HC-SR04 distance from Bloc to Con
    Bloc pings the HC-SR04 (TRIG 11, ECHO 12 through a 1k/2k divider) every
    100 ms and times the echo with an interrupt, so the motor loop never
    waits. Each result goes to Con as a DistancePacket (0xB5, mm, -1 = no
    object).
    Con's Ultrasonic screen shows Bloc's distance, labelled "Bloc", and falls
    back to its own HC-SR04 when nothing arrives. No automatic stop yet.
2026-10-24 Split pillars for printing with stud flats, drop dowel pins from lead screws
2026-10-25 Encoder discs have 20 slots, not 16
    The real discs on the robot have 20 slots, so one pulse is
    pi x 65 / 20 = 10.2 mm instead of 12.8 mm. With 16, the reported wheel
    speed was 25 % too high.
2026-10-25 Split firmware into modules, set 20 encoder slots, widen joystick range, drop ESP32-CAM
2026-10-25 Add KiCad schematics for the robot and controller
2026-10-25 Add photos of the boards, driver module and cells
2026-10-25 Thesis: safety stop checked, ultrasonic range seen in use, demo videos
2026-10-25 Thesis: ultrasonic reading sticks at 59.9 cm, new plates being printed
2026-10-26 Thesis: write chapter 1 (generalities), drop the battery runtime test
2026-10-26 Read the 5-channel line sensor on Bloc, show it on Con
    Bloc reads the bar's five analog outputs (GPIO 2, 4, 5, 6, 7, left to
    right, 4 samples averaged) and sends them every 50 ms as a LinePacket
    (0xB6). Con gets a new "Line" menu entry with one bar and the raw value
    per sensor, to see what the bar reads over the floor and the tape before
    any line following is written.
2026-10-26 Line follower: calibration and PD steering, started from Con's Start menu
    Bloc: each sensor learns its own floor and line values while Con is in
    calibration (a sensor with less than 150 of range is ignored). The line
    position (-100 left .. 100 right) is a weighted average of how dark each
    sensor is, and a PD controller steers around a low base speed (duty 90).
    If the line is lost it spins toward the last side it was seen on and
    stops after 1.5 s. Con must send the mode every 50 ms; without it for
    300 ms Bloc drops back to off.
    Con: the empty "Start" entry opens the follower. It starts in
    calibration, FORWARD starts following once Bloc reports a fresh
    calibration, BACK stops. A press that op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
2026-11-07 Thesis: section 2.7 modular platform with plate drawing from the print file; Ch. 2 conclusion
2026-11-07 Add approximate M6 screw length (about 60 mm) for the plate joints
