seiftotal30-source/BLOC-BOT/tools and components irl/tools/charger-hzs-002-label.jpg

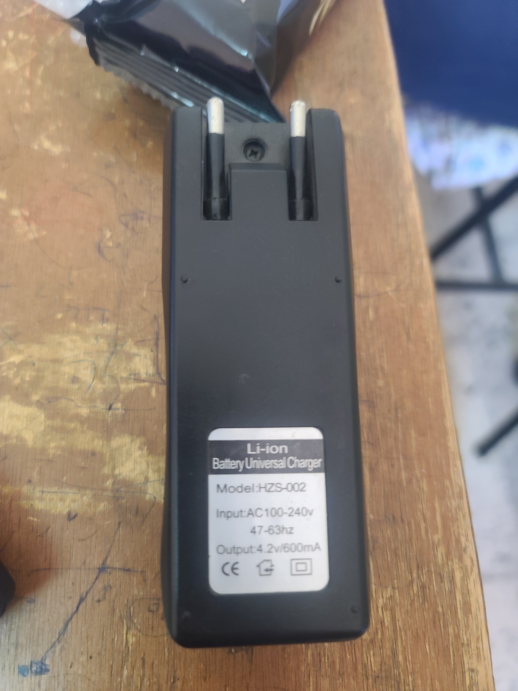
tools and components irl/tools/charger-hzs-002-label.jpg
